Vitrotem/vitronotion/MVP/BOM/IMG/13-018229.jpg

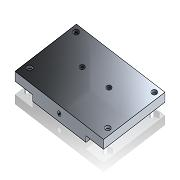
MVP/BOM/IMG/13-018229.jpg
