Vitrotem/vitronotion/MVP_02/BOM/IMG/20-019473.jpg

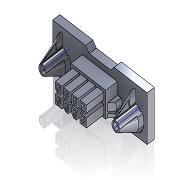
MVP_02/BOM/IMG/20-019473.jpg
