Vitrotem/vitronotion/README.md

# VitroNotion

This repo is for information display to embedded Notion pages...
