Vitrotem/vitronotion/MVP/BOM/index.html

DOCUMENT PREVIEW | ITEM NO. | PartNo | DESCRIPTION | Vendor | VendorNo | Manufacturer | MATERIAL | QTY. | MIN. QTY | Units | Order Status | Expected delivery | Stock | Price in EUR | note | LINK | EMAIL
 | 1 | 13-018308 | MVP-PRT: PELTIER 71W | CONRAD | QC-127-1.4-8.5AS |  |  | 1 |  | 1 | Ordered | 2021-12-20 00:00:00
 | 2 | 13-018423 | MVP-PRT: PCB STANDOFF, M3 x 6 | CONRAD | S45530X10 |  |  | 16 |  | 2 | Ordered | 2021-12-20 00:00:00
 | 3 | 13-018431 | MVP-PRT: CPU FAN 50mm | CONRAD | RDH6025S2 |  |  | 1 |  | 2 | Delivered |  | 2 | 9.91
 | 4 | 13-018440 | MVP-PRT: ARDUINO MEGA 2560 | CONRAD | A000067 |  |  | 1 |  | 2 | Delivered |  | 2 | 31.4
 | 5 | 13-018441 | MVP-PRT: PHOENIX CONTACTS | CONRAD | BU 3002761 |  |  | 1 | 20 | 20 | Delivered |  | 20 | 39.26
 | 6 | 13-018707 | MVP-PRT: JOY-IT PELTIER PSU | CONRAD | DPS5005 |  |  | 1 |  |  | Delivered
 | 7 | 13-018358 | MVP-PRT: PTFE TUBING 1/16" OD - 0.8 ID | PTFE TUBE SHOP | PTFE TUBE 0.8 x 1.6 |  | PTFE (general) | 1 | 1m | 5m | Ordered | 2021-12-22 00:00:00 |  | 86.14 |  | https://ptfetubeshop.com/sv/product/ptfe-slang-08mm-x-16mm-1-32-x-1-16/
 | 8 | 13-018362 | MVP-PRT: 2 PORT BOTTLE CAP | INACOM | 00938T-2F |  |  | 4 |  | 4 | Ordered | 2021-01-20 00:00:00
 | 9 | 13-018394 | MVP-PRT: LUER ADAPTER | INACOM | 009LA |  |  | 6 |  | 6 | Ordered | 2021-01-20 00:00:00
 | 10 | 13-018395 | MVP-PRT: LUER PLUG | INACOM | 009LP |  |  | 6 |  | 6 | Ordered | 2021-01-20 00:00:00
 | 11 | 13-018396 | MVP-PRT: 4 PORT WASTE CAP | INACOM | 00938T-4W |  |  | 1 |  | 1 | Ordered | 2021-01-20 00:00:00
 | 12 | 13-018237 | MVP-PRT: MDRIVE LINEAR ACTUATOR A | ERIKS | MLI1CRL14A4-EQ-LC3Z073AZ |  |  | 1 |  |  | Delivered |  | 1 |  |  | https://novantaims.com/all-products/mdrive-intelligent-motors/mdrive-linear-actuators/ | rick.dekker@eriks.nl
 | 13 | 13-018241 | MVP-PRT: ROUGH NUT | ERIKS |  |  | PMMA | 2 |  |  | Delivered |  | 1
 | 14 | 13-018243 | MVP-PRT: MDRIVE LINEAR ACTUATOR B | ERIKS | MDI31RL14A4-EQ |  |  | 1 |  |  | Delivered |  | 1 |  |  | https://novantaims.com/all-products/mdrive-intelligent-motors/mdrive-linear-actuators/ | rick.dekker@eriks.nl
 | 15 | 13-018351 | MVP-PRT: MDRIVE LINEAR ACTUATOR C | ERIKS | MLI1CRL14A4-EQ-LC3Z098AZ |  |  | 1 |  |  | Delivered |  | 1 |  |  | https://novantaims.com/all-products/mdrive-intelligent-motors/mdrive-linear-actuators/ | rick.dekker@eriks.nl
 | 16 | 13-018408 | MVP-PRT: MOTOR CABLE | ERIKS | PD12B-1434-FL3 |  |  | 1 |  |  | Delivered |  | 3 |  |  | https://novantaims.com/accesories/pd12b-1434-fl3-prototype-development-cable/ | rick.dekker@eriks.nl
 | 17 | 13-018409 | MVP-PRT: USB INTERFACE | ERIKS | MD-CC403-001 |  |  | 1 |  |  | Delivered |  | 1 |  |  | https://novantaims.com/accesories/md-cc403-001/ | rick.dekker@eriks.nl
 | 18 | 13-018399 | MVP-PRT: AWG20 CABLES - RED | FARNELL | 6714 RD005 |  |  | 1 |  |  | Ordered
 | 19 | 13-018439 | MVP-PRT: AWG20 CABLES - BLACK | FARNELL | 6714 BK005 |  |  | 1 |  |  | Ordered |  |  |  | Steven is ordering
 | 20 | 13-018443 | MVP-PRT: AC/DC POWER SUPPLY | FARNELL | VES300PS24 |  |  | 1 |  |  | Ordered
 | 21 | 13-018444 | MVP-PRT: RIBBON CABLE | FARNELL | PSG-JRBN40-MM |  |  | 2 |  |  | Ordered
 | 22 | 13-018210 | MVP-PRT: BIG SLIDER | RS COMPONENTS | 6192385 |  |  | 1
 | 23 | 13-018212 | MVP-PRT: SMALL RAIL | RS COMPONENTS | 6192521 |  |  | 1
 | 24 | 13-018213 | MVP-PRT: SMALL SLIDER | RS COMPONENTS | 6192559 |  |  | 1
 | 25 | 13-018276 | MVP-PRT: DEKSEL RAIL | RS COMPONENTS | 6192391 |  |  | 2
 | 26 | 13-018277 | MVP-PRT: DEKSEL SLIDER | RS COMPONENTS | 6192442 |  |  | 2
 | 27 | 13-018397 | MVP-PRT: BIG RAIL | RS COMPONENTS | 6192363 |  |  | 1
 | 28 | 13-018283 | MVP-PRT: LOW PRESSURE PUMP | HNP-MIKROSYSTEME | MZR-2521 |  |  | 1 |  |  | Delivered |  | 1 |  |  | https://www.hnp-mikrosysteme.de/en/products/detail/mzr-2521/ | Hugo Grunder: hg@suurmond.com
 | 29 | 13-018392 | MVP-PRT: INFLOW FILTER | HNP-MIKROSYSTEME | F-MI0 |  | AISI Type 316L stainless steel | 1 |  |  | Delivered |  | 1 |  |  | https://www.hnp-mikrosysteme.de/en/products/filters/filter-series-f-mi0-1/ | Hugo Grunder: hg@suurmond.com
 | 30 | 13-018421 | MVP-PRT: CERAMIC PUMP CONTROLLER | HNP-MIKROSYSTEME | S-KG-21 |  |  | 1 |  |  | Delivered |  | 1
 | 31 | 13-018357 | MVP-PRT: FLANGELESS FITTING PEEK 5/16-24, 1/8" OD | INACOM | XP-130 |  | Polyetheretherketone (PEEK) | 1 |  |  | Order placed | Not specified
 | 32 | 13-018368 | MVP-PRT: FITTING PEEK 1/4-28, 1/16" OD | INACOM | XP-235 |  | Polyetheretherketone (PEEK) | 16 |  |  | Order placed | Not specified |  |  | Gaat wel via metrohm.nl??? | https://www.coleparmer.de/
 | 33 | 13-018369 | MVP-PRT: ADAPTER 1/4-28 x 5/16-24 PEEK | INACOM | P-135 |  | Polyetheretherketone (PEEK) | 1 |  |  | Order placed | Not specified |  |  |  | https://www.idex-hs.com/store/adapter-1-4-28-x-5-16-24-peek.html
 | 34 | 13-018373 | MVP-PRT: PEEK MANIFOLD 5 Port,1/16" | INACOM | P-154 |  | Polyetheretherketone (PEEK) | 1 |  |  | Order placed | Not specified
 | 35 | 13-018393 | MVP-PRT: FITTING PEEK 1/4-28 - 1/8" OD | INACOM | XP-335 |  | Polyetheretherketone (PEEK) | 1 |  |  | Order placed | Not specified |  |  |  | https://www.idex-hs.com/store/flangeless-fitting-short-natural-peek-1-4-28-flat-bottom-for-1-8-od-natural-10-pack.html
 | 36 | 13-018412 | MVP-PRT: PEEK Y CONNECTOR | INACOM | P-514 |  | Polyetheretherketone (PEEK) | 1 |  |  | Order placed | Not specified |  |  |  | https://www.idex-hs.com/store/y-assembly-peek-1-4-28-060in.html
 | 37 | 13-018418 | MVP-PRT: FITTING PEEK 1/2-20, 1/4" OD | INACOM | U-665 |  | Polyetheretherketone (PEEK) | 2 |  |  | Order placed | Not specified
 | 38 | 13-018419 | MVP-PRT: FLANGELESS FITTING PEEK 1/2-20, 1/4" OD | INACOM | XU-655 |  | Polyetheretherketone (PEEK) | 2 |  |  | Order placed | Not specified
 | 39 | 13-018708 | MVP-PRT: DELRIN PLUG, 1/4-28 FLAT BOTTOM | INACOM | P-309 |  |  | 5
 | 40 | 13-018414 | MVP-PRT: MEMBRANE PUMP | KNF | NF5KPDCB-4 10-26.4V |  |  | 1 |  | 1 | Ordered | 2021-12-08 00:00:00 | 0 | 250 |  | https://knf.com/en/nl/solutions/pumps/series/diaphragm-liquid-pump-nf-5 | mark.hommersen@knf-verder.nl
 | 41 | 13-018420 | MVP-PRT: PTFE TUBING, 1/8" ID, 1/4" OD | PTFE TUBE SHOP | PTFE SLANG 3.2mm x 6.4mm |  | PTFE (general) | 1
 | 42 | 13-018290 | MVP-PRT: ACTUONIX MOTOR | RS COMPONENTS | PQ12-100-6-R |  |  | 2 |  |  | Ordered | 2021-12-20 00:00:00 |  |  | 1 actuonix actuator is delayed and expected delivery is on 21-2-2022 | https://www.actuonix.com/Actuonix-PQ12-R-micro-linear-servos-for-RC-p/pq12-r.htm
 | 43 | 13-018400 | MVP-PRT: BOOTLACE FERRULE | RS COMPONENTS | 228-0321 |  |  | 1 |  |  | Ordered | 2021-12-20 00:00:00
 | 44 | 13-018416 | MVP-PRT: RED BUTTON | RS COMPONENTS | 3SU1150-0AB20-1CA0 |  |  | 1 |  |  | Ordered | 2021-12-20 00:00:00
 | 45 | 13-018434 | MVP-PRT: MOLEX RECEPTICLE | RS COMPONENTS | 15-06-0080 |  |  | 1 |  |  | Ordered | 2021-12-20 00:00:00
 | 46 | 13-018442 | MVP-PRT: SOLID STATE RELAY | RS COMPONENTS | EL100D10-05 |  |  | 4 |  |  | Ordered | 2021-12-20 00:00:00
 | 47 | 13-018445 | MVP-PRT: OMRON 120mm FAN | RS COMPONENTS | R89F-DS1238L |  |  | 1 |  |  | Ordered | 2021-12-20 00:00:00
 | 48 | 13-018447 | MVP-PRT: M8 RUBBER FEET | RS COMPONENTS | 126-4964 |  |  | 4 |  |  | Ordered | 2021-12-20 00:00:00
 | 49 | 13-016706 | M2.5 X 6 SHCS | SAM | DIN 912 A4 M2.5 X 6 |  | AISI Type 316L stainless steel | 4 |  | 50 | Out for delivery | 2021-12-17 00:00:00 |  | 5.29
 | 50 | 13-016707 | M2.5 X 8 SHCS | SAM | DIN 912 A4 M2.5 X 8 |  | AISI Type 316L stainless steel | 1 |  | 50 | Out for delivery | 2021-12-17 00:00:00 |  | 5.29
 | 51 | 13-016708 | M2.5 X 10 SHCS | SAM | DIN 912 A4 M2.5 X 10 |  | AISI Type 316L stainless steel | 4 |  | 50 | Out for delivery | 2021-12-17 00:00:00 |  | 5.29
 | 52 | 13-016709 | M2.5 X 12 SHCS | SAM | DIN 912 A4 M2.5 X 12 |  | AISI Type 316L stainless steel | 12 |  | 50 | Out for delivery | 2021-12-17 00:00:00 |  | 5.29
 | 53 | 13-016711 | M2.5 X 18 SHCS | SAM | DIN 912 A4 M2.5 X 18 |  | AISI Type 316L stainless steel | 2 |  | 25 | Out for delivery | 2021-12-17 00:00:00 |  | 5.87
 | 54 | 13-016752 | M3 X 5 SHCS | SAM | DIN 912 A4 M3 X 5 |  | AISI Type 316L stainless steel | 6 |  | 50 | Out for delivery | 2021-12-17 00:00:00 |  | 4.7
 | 55 | 13-016753 | M3 X 6 SHCS | SAM | DIN 912 A4 M3 X 6 |  | AISI Type 316L stainless steel | 10 |  | 50 | Out for delivery | 2021-12-17 00:00:00 |  | 4.7
 | 56 | 13-016754 | M3 X 8 SHCS | SAM | DIN 912 A4 M3 X 8 |  | AISI Type 316L stainless steel | 6 |  | 50 | Out for delivery | 2021-12-17 00:00:00 |  | 4.7
 | 57 | 13-016755 | M3 X 10 SHCS | SAM | DIN 912 A4 M3 X 10 |  | AISI Type 316L stainless steel | 17 |  | 50 | Out for delivery | 2021-12-17 00:00:00 |  | 4.7
 | 58 | 13-016756 | M3 X 12 SHCS | SAM | DIN 912 A4 M3 X 12 |  | AISI Type 316L stainless steel | 10 |  | 50 | Out for delivery | 2021-12-17 00:00:00 |  | 4.7
 | 59 | 13-016757 | M3 X 16 SHCS | SAM | DIN 912 A4 M3 X 16 |  | AISI Type 316L stainless steel | 8 |  | 50 | Out for delivery | 2021-12-17 00:00:00 |  | 5.29
 | 60 | 13-016797 | M4 X 8 SHCS | SAM | DIN 912 A4 M4 X 8 |  | AISI Type 316L stainless steel | 16 |  | 50 | Out for delivery | 2021-12-17 00:00:00 |  | 6.97
 | 61 | 13-016798 | M4 X 10 SHCS | SAM | DIN 912 A4 M4 X 10 |  | AISI Type 316L stainless steel | 8 |  | 50 | Out for delivery | 2021-12-17 00:00:00 |  | 6.97
 | 62 | 13-016799 | M4 X 12 SHCS | SAM | DIN 912 A4 M4 X 12 |  | AISI Type 316L stainless steel | 6 |  | 50 | Out for delivery | 2021-12-17 00:00:00 |  | 6.97
 | 63 | 13-016800 | M4 X 16 SHCS | SAM | DIN 912 A4 M4 X 16 |  | AISI Type 316L stainless steel | 17 |  | 50 | Out for delivery | 2021-12-17 00:00:00 |  | 8.23
 | 64 | 13-016802 | M4 X 20 SHCS | SAM | DIN 912 A4 M4 X 20 |  | AISI Type 316L stainless steel | 4 |  | 50 | Out for delivery | 2021-12-17 00:00:00 |  | 8.23
 | 65 | 13-016803 | M4 X 25 SHCS | SAM | DIN 912 A4 M4 X 25 |  | AISI Type 316L stainless steel | 4 |  | 50 | Out for delivery | 2021-12-17 00:00:00 |  | 9.32
 | 66 | 13-016807 | M4 X 45 SHCS | SAM | DIN 912 A4 M4 X 45 |  | AISI Type 316L stainless steel | 4 |  | 25 | Out for delivery | 2021-12-17 00:00:00 |  | 8.23
 | 67 | 13-016809 | M4 X 60 SHCS | SAM | DIN 912 A4 M4 X 60 |  | AISI Type 316L stainless steel | 4 |  | 10 | Out for delivery | 2021-12-17 00:00:00 |  | 5.87
 | 68 | 13-016812 | M5 X 10 SHCS | SAM | DIN 912 A4 M5 X 10 |  | AISI Type 316L stainless steel | 15 |  | 25 | Out for delivery | 2021-12-17 00:00:00 |  | 7.55
 | 69 | 13-016813 | M5 X 12 SHCS | SAM | DIN 912 A4 M5 X 12 |  | AISI Type 316L stainless steel | 6
 | 70 | 13-016814 | M5 X 16 SHCS | SAM | DIN 912 A4 M5 X 16 |  | AISI Type 316L stainless steel | 8 |  | 25 | Out for delivery | 2021-12-17 00:00:00 |  | 7.55
 | 71 | 13-016899 | M2.5 HEX NUT | SAM | DIN 934 A4 M2.5 |  | AISI Type 316L stainless steel | 2 |  | 50 | Out for delivery | 2021-12-17 00:00:00 |  | 2.93
 | 72 | 13-016901 | M4 HEX NUT | SAM | DIN 934 A4 M4 |  | AISI Type 316L stainless steel | 4 |  | 50 | Out for delivery | 2021-12-17 00:00:00 |  | 2.93
 | 73 | 13-017540 | M4 FLAT WASHER | SAM | DIN 125 A4 M4 |  | AISI Type 316L stainless steel | 8 |  | 100 | Out for delivery | 2021-12-17 00:00:00 |  | 3.52
 | 74 | 13-017714 | 4 X 12 DP | SAM | DIN 7 A1 4m6 X 12 |  | AISI Type 316L stainless steel | 6 |  | 25 | Out for delivery | 2021-12-17 00:00:00 |  | 3.44
 | 75 | 13-018353 | MVP:PRT: FLOW VALVE | SMC NEDERLAND | LVM10R3-5E2U-3-Q |  |  | 5 |  | 5 | Ordered |  | 0 |  |  | https://www.smc.eu/nl-nl/products/lvm10-100-2-3-poort-magneetventiel-voor-chemicalien~134871~cfg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 | RenÃƒÂ© Bachofner: verkoop@smc.nl
 | 76 | 13-018354 | MVP:PRT: 500ML WATER FLASK | THERMOFISHER | 2019-500 |  |  | 2 | 48.0 |  |  |  |  |  |  | https://www.thermofisher.com/order/catalog/product/2019-0125#/2019-0125
 | 77 | 13-018355 | MVP:PRT: 250ML WATER FLASK | THERMOFISHER | 2019-250 |  |  | 1 | 48.0
 | 78 | 13-018356 | MVP:PRT: 2000ML WATER FLASK | THERMOFISHER | 2019-2000 |  |  | 1 | 24.0
 | 79 | 13-018361 | MVP:PRT: 1000ML WATER FLASK | THERMOFISHER | 2019-1000 |  |  | 1 | 24.0
 | 80 | 13-018219 | MVP-PRT: PRECISION MICRO 4 | VITROTEM | 13-018219 | PRECISION MICRO | 304 SS | 1
 | 81 | 13-018218 | MVP-PRT: CARTRIDGE | VITROTEM | 13-018218 | LASERBEEST | PMMA | 1
 | 82 | 13-018293 | MVP-PRT: TOP COVER | VITROTEM | 13-018293 | LASERBEEST | PMMA | 1 |  | 1 |  | 2021-12-17 00:00:00 | 0
 | 83 | 13-018294 | MVP-PRT: BACK COVER | VITROTEM | 13-018294 | LASERBEEST | PMMA | 1 |  | 1 |  | 2021-12-17 00:00:00 | 0
 | 84 | 13-018295 | MVP-PRT: SIDE COVER A | VITROTEM | 13-018295 | LASERBEEST | PMMA | 1 |  | 1 |  | 2021-12-17 00:00:00 | 0
 | 85 | 13-018426 | MVP-PRT: SIDE COVER B | VITROTEM | 13-018295 | LASERBEEST | PMMA | 1 |  | 1 |  | 2021-12-17 00:00:00 | 0
 | 86 | 13-018433 | MVP-PRT: FRONT COVER | VITROTEM | 13-018433 | LASERBEEST | PMMA | 1 |  | 1 |  | 2021-12-17 00:00:00 | 0
 | 87 | 13-018269 | MVP-PRT: HEATPIPE | VITROTEM | 13-018269 | QUICKCOOL | Copper | 3 |  |  | Delivered |  | 6
 | 88 | 13-018206 | MVP-PRT: BASE PLATE | VITROTEM | 13-018206 | SUPE | 6061 Alloy | 1 |  | 1 | Parts finished dec 27th |  | 0
 | 89 | 13-018207 | MVP-PRT: BACK PLATE | VITROTEM | 13-018207 | SUPE | 6061 Alloy | 1 |  | 1 | Parts finished dec 27th |  | 0
 | 90 | 13-018217 | MVP-PRT: LOOP HOLDER | VITROTEM | 13-018217 | SUPE | 6061 Alloy | 1 |  | 1 | Parts finished dec 27th |  | 0
 | 91 | 13-018220 | MVP-PRT: LOOP HOLDER INTERFACE | VITROTEM | 13-018220 | SUPE | 1060 Alloy | 1 |  | 1 | Parts finished dec 27th |  | 0
 | 92 | 13-018224 | MVP-PRT: BOTTOM PLATE | VITROTEM | 13-018224 | SUPE | 6061 Alloy | 1 |  | 1 | Parts finished dec 27th |  | 0
 | 93 | 13-018229 | MVP-PRT: FLOWCELL SLIDER | VITROTEM | 13-018229 | SUPE | 6061 Alloy | 1 |  | 1 | Parts finished dec 27th |  | 0
 | 94 | 13-018232 | MVP-PRT: CARTRIDGE PLATFORM | VITROTEM | 13-018232 | SUPE | 6061 Alloy | 1 |  | 1 | Parts finished dec 27th |  | 0
 | 95 | 13-018233 | MVP-PRT: GRID HOLDER | VITROTEM | 13-018233 | SUPE | PMMA | 1
 | 96 | 13-018234 | MVP-PRT: CARTRIDGE LANDING PAD | VITROTEM | 13-018234 | SUPE | 6061 Alloy | 1 |  | 1 | Parts finished dec 27th |  | 0
 | 97 | 13-018235 | MVP-PRT: SET BLOCK | VITROTEM | 13-018235 | SUPE | 6061 Alloy | 2 |  | 2 | Parts finished dec 27th |  | 0
 | 98 | 13-018236 | MVP-PRT: CARTRIDGE LANDING LID | VITROTEM | 13-018236 | SUPE | Polyetheretherketone (PEEK) | 1 |  | 1 | Parts finished dec 27th |  | 0
 | 99 | 13-018240 | MVP-PRT: DIFFERENTIAL SCREW | VITROTEM | 13-018240 | SUPE | AISI Type 316L stainless steel | 2 |  | 1 | Parts finished dec 27th |  | 0
 | 100 | 13-018242 | MVP-PRT: HORIZONTAL MOTOR PLATE | VITROTEM | 13-018242 | SUPE | 6061 Alloy | 1 |  | 1 | Parts finished dec 27th |  | 0
 | 101 | 13-018265 | MVP-PRT: HEATPIPE CLAMP A | VITROTEM | 13-018265 | SUPE | Copper | 1 |  | 1 | Parts finished dec 27th |  | 0
 | 102 | 13-018266 | MVP-PRT: HEATPIPE CLAMP B | VITROTEM | 13-018266 | SUPE | Copper | 1 |  | 1 | Parts finished dec 27th |  | 0
 | 103 | 13-018267 | MVP-PRT: LONG AIR | VITROTEM | 13-018267 | SUPE | 6061 Alloy | 1 |  | 1 | Parts finished dec 27th |  | 0
 | 104 | 13-018268 | MVP-PRT: HEATSINK | VITROTEM | 13-018268 | SUPE | Copper | 1 |  | 1 | Parts finished dec 27th |  | 0
 | 105 | 13-018270 | MVP-PRT: SHORT AIR | VITROTEM | 13-018270 | SUPE | 6061 Alloy | 1 |  | 1 | Parts finished dec 27th |  | 0
 | 106 | 13-018271 | MVP-PRT: FLOWCELL COVER | VITROTEM | 13-018271 | SUPE | Polyetheretherketone (PEEK) | 1 |  | 1 | Parts finished dec 27th |  | 0
 | 107 | 13-018272 | MVP-PRT: DIVIDER PLATE A | VITROTEM | 13-018272 | SUPE | 6061 Alloy | 1 |  | 1 | Parts finished dec 27th |  | 0
 | 108 | 13-018273 | MVP-PRT: DIVIDER PLATE B | VITROTEM | 13-018273 | SUPE | 6061 Alloy | 1 |  | 1 | Parts finished dec 27th |  | 0
 | 109 | 13-018274 | MVP-PRT: HEATSINK CLAMP | VITROTEM | 13-018274 | SUPE | 6061 Alloy | 1 |  | 1 | Parts finished dec 27th |  | 0
 | 110 | 13-018275 | MVP-PRT: FLOWCELL COVER BRACKET | VITROTEM | 13-018275 | SUPE | 6061 Alloy | 1 |  | 1 | Parts finished dec 27th |  | 0
 | 111 | 13-018278 | MVP-PRT: LEFT BRACE CONNECTOR | VITROTEM | 13-018278 | SUPE | 6061 Alloy | 1 |  | 1 | Parts finished dec 27th |  | 0
 | 112 | 13-018279 | MVP-PRT: RIGHT BRACE CONNECTOR | VITROTEM | 13-018279 | SUPE | 6061 Alloy | 1 |  | 1 | Parts finished dec 27th |  | 0
 | 113 | 13-018285 | MVP-PRT: VALVE PLATE | VITROTEM | 13-018285 | SUPE | 6061 Alloy | 1 |  | 1 | Parts finished dec 27th |  | 0
 | 114 | 13-018286 | MVP-PRT: ACTUATOR BRACKET | VITROTEM | 13-018286 | SUPE | 6061 Alloy | 1 |  | 1 | Parts finished dec 27th |  | 0
 | 115 | 13-018287 | MVP-PRT: CARTRIDGE BRACKET | VITROTEM | 13-018287 | SUPE | 6061 Alloy | 1 |  | 1 | Parts finished dec 27th |  | 0
 | 116 | 13-018288 | MVP-PRT: BOTTOM TRAY B | VITROTEM | 13-018288 | SUPE | Polyetheretherketone (PEEK) | 1 |  | 1 | Parts finished dec 27th |  | 0
 | 117 | 13-018289 | MVP-PRT: BOTTOM TRAY A | VITROTEM | 13-018289 | SUPE | Polyetheretherketone (PEEK) | 1 |  | 1 | Parts finished dec 27th |  | 0
 | 118 | 13-018292 | MVP-PRT: LOOP HOLDER CLIP | VITROTEM | 13-018292 | SUPE | Polyetheretherketone (PEEK) | 1 |  | 1 | Parts finished dec 27th |  | 0
 | 119 | 13-018301 | MVP-PRT: HOUSING CONNECTION A | VITROTEM | 13-018301 | SUPE | 6061 Alloy | 4 |  | 4 | Parts finished dec 27th |  | 0
 | 120 | 13-018309 | MVP-PRT: COPPER JACKET | VITROTEM | 13-018309 | SUPE | Copper | 1 |  | 1 | Parts finished dec 27th |  | 0
 | 121 | 13-018313 | MVP-PRT: MOTOR / RAIL BRACKET A | VITROTEM | 13-018313 | SUPE | 6061 Alloy | 1 |  | 1 | Parts finished dec 27th |  | 0
 | 122 | 13-018314 | MVP-PRT: MOTOR / RAIL BRACKET b | VITROTEM | 13-018314 | SUPE | 6061 Alloy | 1 |  | 1 | Parts finished dec 27th |  | 0
 | 123 | 13-018410 | MVP-PRT: FLOWCELL | VITROTEM | 13-018307 | SUPE | Polyetheretherketone (PEEK) | 1 |  | 1 | Parts finished dec 27th |  | 0
 | 124 | 13-018425 | MVP-PRT: HOUSING CONNECTION B | VITROTEM | 13-018301 | SUPE | 6061 Alloy | 4 |  | 4 | Parts finished dec 27th |  | 0
 | 125 | 13-018446 | MVP-PRT: PATCH PANEL FOR PSU | VITROTEM | 13-018446 | SUPE | 6061 Alloy | 1 |  | 1 | Parts finished dec 27th |  | 0
 | 126 | 13-018730 | MVP-PRT: SS SPRING | RS COMPONENTS | 821-526 |  |  | 2
 | 127 | 13-018370 | MVP-PRT: PTFE TUBING 1/8" OD - 1.6 ID | PTFE TUBE SHOP | PTFE SLANG 1.6mm x 3.2mm |  | PTFE (general) | 1
 | 128 | 13-018716 | MVP-PRT: PELTIER PSU SUPPORT | VITROTEM | 13-018716 |  | PMMA | 1
 | 129 | 13-018717 | MVP-PRT: PELTIER HOLDER BRACKET | VITROTEM | 13-018717 |  | PMMA | 1
 | 130 | 13-018718 | MVP-PRT: TC PLATE | VITROTEM | 13-018718 |  | PMMA | 1
 | 131 | 13-018720 | MVP-PRT: TC HOLDER BRACKET | VITROTEM | 13-018720 |  | PMMA | 1
 | 132 | 13-018737 | MVP: PCB | VITROTEM | 13-018737 |  |  | 1
 | 133 | 13-018738 | MVP: PCB BRACKET | VITROTEM | 13-018738 |  | Material <not specified> | 1
 | 134 | 13-018739 | MVP: ARUINO BRACKET | VITROTEM | 13-018739 |  | Material <not specified> | 1
