Vitrotem/vitronotion/MVP_02/SHOPPING_LISTS/CONRAD.xlsx

DOCUMENT PREVIEW | ITEM NO. | PartNo | DESCRIPTION | Vendor | VendorNo | Manufacturer | MATERIAL | QTY.
 | 1 | 20-019470 | PELTIER 71W | CONRAD | QC-127-1.4-8.5AS |  |  | 1
 | 2 | 20-019458 | PCB STANDOFF, M3 x 6 | CONRAD | S45530X10 |  |  | 8
 | 3 | 20-019475 | ARDUINO MEGA 2560 | CONRAD | A000067 |  |  | 1
 | 4 | 20-019476 | PHOENIX CONTACTS | CONRAD | BU 3002761 |  |  | 1
 | 5 | 20-019485 | JOY-IT PELTIER PSU | CONRAD | DPS5005 |  |  | 1
