Vitrotem/vitronotion/MVP_02/SHOPPING_LISTS/ERIKS.xlsx

DOCUMENT PREVIEW | ITEM NO. | PartNo | DESCRIPTION | Vendor | VendorNo | Manufacturer | MATERIAL | QTY.
 | 11 | 20-019380 | MDRIVE LINEAR ACTUATOR C | ERIKS | MLI1CRL14A4-EQ-LC3Z098AZ |  |  | 1
 | 12 | 20-019382 | ROUGH NUT | ERIKS | 20-019382 |  | PMMA | 2
 | 13 | 20-019448 | MOTOR CABLE | ERIKS | PD12B-1434-FL3 |  |  | 3
 | 14 | 20-019449 | USB INTERFACE | ERIKS | MD-CC403-001 |  |  | 1
 | 114 | 20-019424 | MDRIVE LINEAR ACTUATOR A | ERIKS | MLI1CRL14A4-EQ-LC3Z073AZ |  |  | 1
