Vitrotem/vitronotion/MVP_02/SHOPPING_LISTS/FARNELL.xlsx

DOCUMENT PREVIEW | ITEM NO. | PartNo | DESCRIPTION | Vendor | VendorNo | Manufacturer | MATERIAL | QTY.
 | 15 | 20-019442 | AWG20 CABLES - RED | FARNELL | 6714 RD005 |  |  | 1
 | 16 | 20-019474 | AWG20 CABLES - BLACK | FARNELL | 6714 BK005 |  |  | 1
 | 18 | 20-019479 | RIBBON CABLE | FARNELL | PSG-JRBN40-MM |  |  | 2
 | 39 | 20-019477 | SOLID STATE RELAY | FARNELL | 7229136 | OPTO 22 |  | 4
 | 132 | 20-019512 | DC POWER CONNECTOR | FARNELL | 1871166 | SWITCHCRAFT |  | 1
 | 133 | 20-019513 | AC/DC POWER SUPPLY - 120W, 5A | FARNELL | 2815847 | MEAN WELL |  | 1
