Vitrotem/vitronotion/MVP_02/SHOPPING_LISTS/HNP-MIKROSYSTEME.xlsx

DOCUMENT PREVIEW | ITEM NO. | PartNo | DESCRIPTION | Vendor | VendorNo | Manufacturer | MATERIAL | QTY.
 | 25 | 20-019398 | LOW PRESSURE PUMP | HNP-MIKROSYSTEME | MZR-2521 |  |  | 1
 | 26 | 20-019436 | INFLOW FILTER | HNP-MIKROSYSTEME | F-MI0 |  | AISI Type 316L stainless steel | 1
 | 27 | 20-019457 | CERAMIC PUMP CONTROLLER | HNP-MIKROSYSTEME | S-KG-21 |  |  | 1
