Vitrotem/vitronotion/MVP_02/SHOPPING_LISTS/KNF.xlsx

DOCUMENT PREVIEW | ITEM NO. | PartNo | DESCRIPTION | Vendor | VendorNo | Manufacturer | MATERIAL | QTY.
 | 35 | 20-019452 | MEMBRANE PUMP | KNF | NF5KPDCB-4 10-26.4V |  |  | 1
 | 124 | 20-019522 | OUTFLOW FILTER | KNF | FS60 |  |  | 1
