Vitrotem/vitronotion/MVP_02/SHOPPING_LISTS/PTFE TUBE SHOP.xlsx

DOCUMENT PREVIEW | ITEM NO. | PartNo | DESCRIPTION | Vendor | VendorNo | Manufacturer | MATERIAL | QTY.
 | 6 | 20-019429 | PTFE TUBING 1/16" OD - 0.8 ID | PTFE TUBE SHOP | PTFE TUBE 0.8 x 1.6 |  | PTFE (general) | 1
 | 122 | 20-019434 | PTFE TUBING 1/8" OD - 1.6 ID | PTFE TUBE SHOP | PTFE SLANG 1.6mm x 3.2mm |  | PTFE (general) | 1
