Vitrotem/vitronotion/MVP_02/SHOPPING_LISTS/RS COMPONENTS.xlsx

DOCUMENT PREVIEW | ITEM NO. | PartNo | DESCRIPTION | Vendor | VendorNo | Manufacturer | MATERIAL | QTY.
 | 17 | 20-019478 | AC/DC POWER SUPPLY | RS COMPONENTS | 200-6361 |  |  | 1
 | 19 | 20-019365 | BIG SLIDER | RS COMPONENTS | 6192385 |  |  | 1
 | 20 | 20-019367 | SMALL RAIL | RS COMPONENTS | 6192521 |  |  | 1
 | 21 | 20-019368 | SMALL SLIDER | RS COMPONENTS | 6192559 |  |  | 1
 | 22 | 20-019394 | DEKSEL RAIL | RS COMPONENTS | 6192391 |  |  | 2
 | 23 | 20-019395 | DEKSEL SLIDER | RS COMPONENTS | 6192442 |  |  | 2
 | 24 | 20-019441 | BIG RAIL | RS COMPONENTS | 6192363 |  |  | 1
 | 36 | 20-019404 | ACTUONIX MOTOR | RS COMPONENTS | 180-8409 |  |  | 2
 | 37 | 20-019443 | BOOTLACE FERRULE | RS COMPONENTS | 228-0321 |  |  | 1
 | 38 | 20-019511 | EMERGENCY STOP | RS COMPONENTS | 425-8449 | SCHNEIDER |  | 1
 | 40 | 20-019480 | OMRON 120mm FAN | RS COMPONENTS | 194-0653 | OMRON |  | 1
 | 41 | 20-019483 | M8 RUBBER FEET | RS COMPONENTS | 126-4964 |  |  | 4
 | 115 | 20-019491 | SS SPRING | RS COMPONENTS | 821-526 |  |  | 2
 | 135 | 20-019525 | TYPE K THERMOCOUPLE | RS COMPONENTS | 444-1275 |  |  | 1
