Vitrotem/vitronotion/MVP_02/SHOPPING_LISTS/SMC NEDERLAND.xlsx

DOCUMENT PREVIEW | ITEM NO. | PartNo | DESCRIPTION | Vendor | VendorNo | Manufacturer | MATERIAL | QTY.
 | 66 | 20-019425 | MVP:PRT: FLOW VALVE | SMC NEDERLAND | LVM10R3-5E2U-3-Q |  |  | 5
