Vitrotem/vitronotion/MVP_02/SHOPPING_LISTS/THERMOFISHER.xlsx

DOCUMENT PREVIEW | ITEM NO. | PartNo | DESCRIPTION | Vendor | VendorNo | Manufacturer | MATERIAL | QTY.
 | 67 | 20-019427 | MVP:PRT: 500ML WATER FLASK | THERMOFISHER | 2019-500 |  |  | 2
 | 68 | 20-019409 | MVP:PRT: 250ML WATER FLASK | THERMOFISHER | 2019-250 |  |  | 1
 | 69 | 20-019430 | MVP:PRT: 2000ML WATER FLASK | THERMOFISHER | 2019-2000 |  |  | 1
 | 70 | 20-019426 | MVP:PRT: 1000ML WATER FLASK | THERMOFISHER | 2019-1000 |  |  | 1
