Vitrotem/vitronotion/MVP_02/SHOPPING_LISTS/VITROTEM.xlsx

DOCUMENT PREVIEW | ITEM NO. | PartNo | DESCRIPTION | Vendor | VendorNo | Manufacturer | MATERIAL | QTY.
 | 71 | 20-019371 | PRECISION MICRO 4 | VITROTEM | 20-019371 | PRECISION MICRO | 304 SS | 1
 | 72 | 20-019370 | CARTRIDGE | VITROTEM | 20-019370 | LASERBEEST | PMMA | 1
 | 73 | 20-019406 | TOP COVER | VITROTEM | 20-019406 | LASERBEEST | PMMA | 1
 | 74 | 20-019407 | BACK COVER | VITROTEM | 20-019407 | LASERBEEST | PMMA | 1
 | 75 | 20-019408 | SIDE COVER A | VITROTEM | 20-019408 | LASERBEEST | PMMA | 1
 | 76 | 20-019462 | SIDE COVER B | VITROTEM | 20-019462 | LASERBEEST | PMMA | 1
 | 77 | 20-019468 | FRONT COVER | VITROTEM | 20-019468 | LASERBEEST | PMMA | 1
 | 78 | 20-019388 | HEATPIPE | VITROTEM | 20-019388 | QUICKCOOL | Copper | 3
 | 79 | 20-019362 | BASE PLATE | VITROTEM | 20-019362 | SUPE | 6061 Alloy | 1
 | 80 | 20-019363 | BACK PLATE | VITROTEM | 20-019363 | SUPE | 6061 Alloy | 1
 | 81 | 20-019369 | LOOP HOLDER | VITROTEM | 20-019369 | SUPE | 6061 Alloy | 1
 | 82 | 20-019373 | BOTTOM PLATE | VITROTEM | 20-019373 | SUPE | 6061 Alloy | 1
 | 83 | 20-019374 | FLOWCELL SLIDER | VITROTEM | 20-019374 | SUPE | 6061 Alloy | 1
 | 84 | 20-019375 | CARTRIDGE PLATFORM | VITROTEM | 20-019375 | SUPE | 6061 Alloy | 1
 | 85 | 20-019376 | GRID HOLDER | VITROTEM | 20-019376 | SUPE | PMMA | 1
 | 86 | 20-019377 | CARTRIDGE LANDING PAD | VITROTEM | 20-019377 | SUPE | 6061 Alloy | 1
 | 87 | 20-019378 | SET BLOCK | VITROTEM | 20-019378 | SUPE | 6061 Alloy | 2
 | 88 | 20-019379 | CARTRIDGE LANDING LID | VITROTEM | 20-019379 | SUPE | ABS Black | 1
 | 89 | 20-019383 | HORIZONTAL MOTOR PLATE | VITROTEM | 20-019383 | SUPE | 6061 Alloy | 1
 | 90 | 20-019385 | HEATPIPE CLAMP A | VITROTEM | 20-019385 | SUPE | Copper | 1
 | 91 | 20-019386 | HEATPIPE CLAMP B | VITROTEM | 20-019386 | SUPE | Copper | 1
 | 92 | 20-019387 | HEATSINK | VITROTEM | 20-019387 | SUPE | Copper | 1
 | 93 | 20-019389 | FLOWCELL COVER | VITROTEM | 20-019389 | SUPE | ABS Clear | 1
 | 94 | 20-019390 | DIVIDER PLATE A | VITROTEM | 20-019390 | SUPE | 6061 Alloy | 1
 | 95 | 20-019391 | DIVIDER PLATE B | VITROTEM | 20-019391 | SUPE | 6061 Alloy | 1
 | 96 | 20-019392 | HEATSINK CLAMP | VITROTEM | 20-019392 | SUPE | 6061 Alloy | 1
 | 97 | 20-019393 | FLOWCELL COVER BRACKET | VITROTEM | 20-019393 | SUPE | 6061 Alloy | 1
 | 98 | 20-019396 | LEFT BRACE CONNECTOR | VITROTEM | 20-019396 | SUPE | 6061 Alloy | 1
 | 99 | 20-019397 | RIGHT BRACE CONNECTOR | VITROTEM | 20-019397 | SUPE | 6061 Alloy | 1
 | 100 | 20-019399 | VALVE PLATE | VITROTEM | 20-019399 | SUPE | 6061 Alloy | 1
 | 101 | 20-019400 | ACTUATOR BRACKET | VITROTEM | 20-019400 | SUPE | 6061 Alloy | 1
 | 102 | 20-019401 | CARTRIDGE BRACKET | VITROTEM | 20-019401 | SUPE | 6061 Alloy | 1
 | 103 | 20-019402 | BOTTOM TRAY B | VITROTEM | 20-019402 | SUPE | ABS Black | 1
 | 104 | 20-019403 | BOTTOM TRAY A | VITROTEM | 20-019403 | SUPE | ABS Black | 1
 | 105 | 20-019405 | LOOP HOLDER CLIP | VITROTEM | 20-019405 | SUPE | ABS Black | 1
 | 106 | 20-019410 | HOUSING CONNECTION A | VITROTEM | 20-019410 | SUPE | 6061 Alloy | 4
 | 107 | 20-019471 | COPPER JACKET | VITROTEM | 20-019471 | SUPE | Copper | 1
 | 108 | 20-019421 | MOTOR / RAIL BRACKET A | VITROTEM | 20-019421 | SUPE | 6061 Alloy | 1
 | 109 | 20-019422 | MOTOR / RAIL BRACKET b | VITROTEM | 20-019422 | SUPE | 6061 Alloy | 1
 | 110 | 20-019469 | FLOWCELL | VITROTEM | 20-019469 | SUPE | PEEK Natural | 1
 | 111 | 20-019460 | HOUSING CONNECTION B | VITROTEM | 20-019460 | SUPE | 6061 Alloy | 4
 | 112 | 20-019482 | PATCH PANEL FOR PSU | VITROTEM | 20-019482 | SUPE | 6061 Alloy | 1
 | 113 | 20-019497 | WATER TRAY | VITROTEM | 20-019497 |  | PLA | 1
 | 116 | 20-019529 | COVER D | VITROTEM | 20-019529 | LASERBEEST | PMMA | 1
 | 117 | 20-019500 | COVER A | VITROTEM | 20-019500 | LASERBEEST | PMMA | 1
 | 118 | 20-019501 | COVER B | VITROTEM | 20-019501 | LASERBEEST | PMMA | 2
 | 119 | 20-019502 | COVER C | VITROTEM | 20-019502 | LASERBEEST | PMMA | 1
 | 120 | 20-019506 | COVER CORNER BRACKETS | VITROTEM | 20-019506 |  | PLA | 4
 | 123 | 20-019503 | MEMBRANE PUMP BRACKET | VITROTEM | 20-019503 |  | PLA | 1
 | 125 | 20-019487 | PELTIER PSU SUPPORT | VITROTEM | 20-019487 |  | PLA | 1
 | 126 | 20-019488 | PELTIER HOLDER BRACKET | VITROTEM | 20-019488 |  | PLA | 1
 | 127 | 20-019490 | TC HOLDER BRACKET | VITROTEM | 20-019490 |  | PLA | 1
 | 128 | 20-019492 | MVP: PCB | VITROTEM | 20-019492 |  |  | 1
 | 129 | 20-019494 | MVP: ARUINO BRACKET | VITROTEM | 20-019494 |  | PLA | 1
 | 130 | 20-019493 | MVP: PCB BRACKET | VITROTEM | 20-019493 |  | PLA | 1
 | 131 | 20-019496 | PUMP BRACKET B | VITROTEM | 20-019496 |  | PLA | 1
 | 134 | 20-019508 | MOTOR STOP | VITROTEM | 20-019508 |  | PLA | 1
 | 136 | 20-019526 | LOOP HOLDER INTERFACE | VITROTEM | 20-019372 | SUPE | 6061 Alloy | 1
 | 137 | 20-019528 | COVER CORNER BRACKETS B | VITROTEM | 20-019528 |  | PLA | 2
 | 138 | 20-019633 | TC / OUTFLOW MOTOR PLATE | VITROTEM | 20-019633 |  | Material <not specified> | 1
