Vitrotem/vitronotion/MVP_02/SHOPPING_LISTS/TAMESON.xlsx

DOCUMENT PREVIEW | ITEM NO. | PartNo | DESCRIPTION | Vendor | VendorNo | Manufacturer | MATERIAL | QTY.
 | 131 | 20-019507 | 1/2-28 X 10 NIPPLE | TAMESON | FL2S-MH-BN-012R-10 | TAMESON |  | 1
