Vitrotem/vitronotion/MVP/SHOPPING_LISTS/DARWIN.xlsx

DOCUMENT PREVIEW | ITEM NO. | PartNo | DESCRIPTION | Vendor | VendorNo | Manufacturer | MATERIAL | QTY.
 | 7 | 13-018358 | MVP-PRT: PTFE TUBING 1/16" OD - 0.8 ID | DARWIN | BL-PTFE-1603-20 |  | PTFE (general) | 1
