Vitrotem/vitronotion/MVP/SHOPPING_LISTS/ROMYNOX.xlsx

DOCUMENT PREVIEW | ITEM NO. | PartNo | DESCRIPTION | Vendor | VendorNo | Manufacturer | MATERIAL | QTY.
 | 41 | 13-018420 | MVP-PRT: PTFE TUBING, 1/8" ID, 1/4" OD | ROMYNOX | CG-125X250 |  | PTFE (general) | 1
