Vitrotem/vitronotion/MVP_02/SHOPPING_LISTS/QUICKCOOL/QUICKCOOL.xlsx

DOCUMENT PREVIEW | ITEM NO. | PartNo | DESCRIPTION | Vendor | VendorNo | Manufacturer | MATERIAL | QTY.
 | 78 | 20-019388 | HEATPIPE | VITROTEM | 20-019388 | QUICKCOOL | Copper | 3
