Vitrotem/vitronotion/MVP_02/SHOPPING_LISTS/SCHNEIDER/SCHNEIDER.xlsx

DOCUMENT PREVIEW | ITEM NO. | PartNo | DESCRIPTION | Vendor | VendorNo | Manufacturer | MATERIAL | QTY.
 | 42 | 20-019511 | EMERGENCY STOP | RS COMPONENTS | 330-9388 | SCHNEIDER |  | 1
