Vitrotem/vitronotion/MVP/SHOPPING_LISTS/LASERBEEST/LASERBEEST.xlsx

DOCUMENT PREVIEW | ITEM NO. | PartNo | DESCRIPTION | Vendor | VendorNo | Manufacturer | MATERIAL | QTY.
 | 80 | 13-018218 | MVP-PRT: CARTRIDGE | VITROTEM | 13-018218 | LASERBEEST | PMMA | 1
 | 81 | 13-018293 | MVP-PRT: TOP COVER | VITROTEM | 13-018293 | LASERBEEST | PMMA | 1
 | 82 | 13-018294 | MVP-PRT: BACK COVER | VITROTEM | 13-018294 | LASERBEEST | PMMA | 1
 | 83 | 13-018295 | MVP-PRT: SIDE COVER A | VITROTEM | 13-018295 | LASERBEEST | PMMA | 1
 | 84 | 13-018426 | MVP-PRT: SIDE COVER B | VITROTEM | 13-018295 | LASERBEEST | PMMA | 1
 | 85 | 13-018433 | MVP-PRT: FRONT COVER | VITROTEM | 13-018433 | LASERBEEST | PMMA | 1
 | 125 | 13-018746 | MVP-PRT: COVER A | VITROTEM | 13-018746 | LASERBEEST | PLA | 2
 | 126 | 13-018747 | MVP-PRT: COVER B | VITROTEM | 13-018747 | LASERBEEST | Material <not specified> | 2
 | 127 | 13-018748 | MVP-PRT: COVER C | VITROTEM | 13-018748 | LASERBEEST | Material <not specified> | 1
