Vitrotem/vitronotion/MVP/SHOPPING_LISTS/PRECISION MICRO/PRECISION MICRO.xlsx

DOCUMENT PREVIEW | ITEM NO. | PartNo | DESCRIPTION | Vendor | VendorNo | Manufacturer | MATERIAL | QTY.
 | 79 | 13-018219 | MVP-PRT: PRECISION MICRO 4 | VITROTEM | 13-018219 | PRECISION MICRO | 304 SS | 1
