Vitrotem/vitronotion/MVP/SHOPPING_LISTS/QUICKCOOL/QUICKCOOL.xlsx

DOCUMENT PREVIEW | ITEM NO. | PartNo | DESCRIPTION | Vendor | VendorNo | Manufacturer | MATERIAL | QTY.
 | 86 | 13-018269 | MVP-PRT: HEATPIPE | VITROTEM | 13-018269 | QUICKCOOL | Copper | 3
