Vitrotem/vitronotion/MVP/SHOPPING_LISTS/SUPE/SUPE.xlsx

DOCUMENT PREVIEW | ITEM NO. | PartNo | DESCRIPTION | Vendor | VendorNo | Manufacturer | MATERIAL | QTY.
 | 87 | 13-018206 | MVP-PRT: BASE PLATE | VITROTEM | 13-018206 | SUPE | 6061 Alloy | 1
 | 88 | 13-018207 | MVP-PRT: BACK PLATE | VITROTEM | 13-018207 | SUPE | 6061 Alloy | 1
 | 89 | 13-018217 | MVP-PRT: LOOP HOLDER | VITROTEM | 13-018217 | SUPE | 6061 Alloy | 1
 | 90 | 13-018220 | MVP-PRT: LOOP HOLDER INTERFACE | VITROTEM | 13-018220 | SUPE | 1060 Alloy | 1
 | 91 | 13-018224 | MVP-PRT: BOTTOM PLATE | VITROTEM | 13-018224 | SUPE | 6061 Alloy | 1
 | 92 | 13-018229 | MVP-PRT: FLOWCELL SLIDER | VITROTEM | 13-018229 | SUPE | 6061 Alloy | 1
 | 93 | 13-018232 | MVP-PRT: CARTRIDGE PLATFORM | VITROTEM | 13-018232 | SUPE | 6061 Alloy | 1
 | 94 | 13-018233 | MVP-PRT: GRID HOLDER | VITROTEM | 13-018233 | SUPE | PMMA | 1
 | 95 | 13-018234 | MVP-PRT: CARTRIDGE LANDING PAD | VITROTEM | 13-018234 | SUPE | 6061 Alloy | 1
 | 96 | 13-018235 | MVP-PRT: SET BLOCK | VITROTEM | 13-018235 | SUPE | 6061 Alloy | 2
 | 97 | 13-018236 | MVP-PRT: CARTRIDGE LANDING LID | VITROTEM | 13-018236 | SUPE | Polyetheretherketone (PEEK) | 1
 | 98 | 13-018240 | MVP-PRT: DIFFERENTIAL SCREW | VITROTEM | 13-018240 | SUPE | AISI Type 316L stainless steel | 2
 | 99 | 13-018242 | MVP-PRT: HORIZONTAL MOTOR PLATE | VITROTEM | 13-018242 | SUPE | 6061 Alloy | 1
 | 100 | 13-018265 | MVP-PRT: HEATPIPE CLAMP A | VITROTEM | 13-018265 | SUPE | Copper | 1
 | 101 | 13-018266 | MVP-PRT: HEATPIPE CLAMP B | VITROTEM | 13-018266 | SUPE | Copper | 1
 | 102 | 13-018268 | MVP-PRT: HEATSINK | VITROTEM | 13-018268 | SUPE | Copper | 1
 | 103 | 13-018271 | MVP-PRT: FLOWCELL COVER | VITROTEM | 13-018271 | SUPE | Polyetheretherketone (PEEK) | 1
 | 104 | 13-018272 | MVP-PRT: DIVIDER PLATE A | VITROTEM | 13-018272 | SUPE | 6061 Alloy | 1
 | 105 | 13-018273 | MVP-PRT: DIVIDER PLATE B | VITROTEM | 13-018273 | SUPE | 6061 Alloy | 1
 | 106 | 13-018274 | MVP-PRT: HEATSINK CLAMP | VITROTEM | 13-018274 | SUPE | 6061 Alloy | 1
 | 107 | 13-018275 | MVP-PRT: FLOWCELL COVER BRACKET | VITROTEM | 13-018275 | SUPE | 6061 Alloy | 1
 | 108 | 13-018278 | MVP-PRT: LEFT BRACE CONNECTOR | VITROTEM | 13-018278 | SUPE | 6061 Alloy | 1
 | 109 | 13-018279 | MVP-PRT: RIGHT BRACE CONNECTOR | VITROTEM | 13-018279 | SUPE | 6061 Alloy | 1
 | 110 | 13-018285 | MVP-PRT: VALVE PLATE | VITROTEM | 13-018285 | SUPE | 6061 Alloy | 1
 | 111 | 13-018286 | MVP-PRT: ACTUATOR BRACKET | VITROTEM | 13-018286 | SUPE | 6061 Alloy | 1
 | 112 | 13-018287 | MVP-PRT: CARTRIDGE BRACKET | VITROTEM | 13-018287 | SUPE | 6061 Alloy | 1
 | 113 | 13-018288 | MVP-PRT: BOTTOM TRAY B | VITROTEM | 13-018288 | SUPE | Polyetheretherketone (PEEK) | 1
 | 114 | 13-018289 | MVP-PRT: BOTTOM TRAY A | VITROTEM | 13-018289 | SUPE | Polyetheretherketone (PEEK) | 1
 | 115 | 13-018292 | MVP-PRT: LOOP HOLDER CLIP | VITROTEM | 13-018292 | SUPE | Polyetheretherketone (PEEK) | 1
 | 116 | 13-018301 | MVP-PRT: HOUSING CONNECTION A | VITROTEM | 13-018301 | SUPE | 6061 Alloy | 4
 | 117 | 13-018309 | MVP-PRT: COPPER JACKET | VITROTEM | 13-018309 | SUPE | Copper | 1
 | 118 | 13-018313 | MVP-PRT: MOTOR / RAIL BRACKET A | VITROTEM | 13-018313 | SUPE | 6061 Alloy | 1
 | 119 | 13-018314 | MVP-PRT: MOTOR / RAIL BRACKET b | VITROTEM | 13-018314 | SUPE | 6061 Alloy | 1
 | 120 | 13-018410 | MVP-PRT: FLOWCELL | VITROTEM | 13-018307 | SUPE | Polyetheretherketone (PEEK) | 1
 | 121 | 13-018425 | MVP-PRT: HOUSING CONNECTION B | VITROTEM | 13-018301 | SUPE | 6061 Alloy | 4
 | 122 | 13-018446 | MVP-PRT: PATCH PANEL FOR PSU | VITROTEM | 13-018446 | SUPE | 6061 Alloy | 1
