Vitrotem/vitronotion/MVP_02/SHOPPING_LISTS/INACOM.xlsx

DOCUMENT PREVIEW | ITEM NO. | PartNo | DESCRIPTION | Vendor | VendorNo | Manufacturer | MATERIAL | QTY.
 | 7 | 20-019431 | 2 PORT BOTTLE CAP | INACOM | 00938T-2F |  |  | 4
 | 8 | 20-019438 | LUER ADAPTER | INACOM | 009LA |  |  | 6
 | 9 | 20-019439 | LUER PLUG | INACOM | 009LP |  |  | 6
 | 10 | 20-019440 | 4 PORT WASTE CAP | INACOM | 00938T-4W |  |  | 1
 | 28 | 20-019428 | FLANGELESS FITTING PEEK 5/16-24, 1/8" OD | INACOM | XP-130 |  | Polyetheretherketone (PEEK) | 1
 | 29 | 20-019432 | FITTING PEEK 1/4-28, 1/16" OD | INACOM | XP-235 |  | Polyetheretherketone (PEEK) | 16
 | 30 | 20-019433 | ADAPTER 1/4-28 x 5/16-24 PEEK | INACOM | P-135 |  | Polyetheretherketone (PEEK) | 1
 | 31 | 20-019435 | PEEK MANIFOLD 5 Port,1/16" | INACOM | P-154 |  | Polyetheretherketone (PEEK) | 1
 | 32 | 20-019437 | FITTING PEEK 1/4-28 - 1/8" OD | INACOM | XP-335 |  | Polyetheretherketone (PEEK) | 1
 | 33 | 20-019450 | PEEK Y CONNECTOR | INACOM | P-514 |  | Polyetheretherketone (PEEK) | 1
 | 34 | 20-019486 | DELRIN PLUG, 1/4-28 FLAT BOTTOM | INACOM | P-309 |  |  | 5
