Vitrotem/vitronotion/MVP_02/SHOPPING_LISTS/RVS PALEIS.xlsx

DOCUMENT PREVIEW | ITEM NO. | PartNo | DESCRIPTION | Vendor | VendorNo | Manufacturer | MATERIAL | QTY.
 | 42 | 13-016706 | M2.5 X 6 SHCS | RVS PALEIS | DIN 912 A4 M2.5 X 6 |  | AISI Type 316L stainless steel | 4
 | 43 | 13-016707 | M2.5 X 8 SHCS | RVS PALEIS | DIN 912 A4 M2.5 X 8 |  | AISI Type 316L stainless steel | 1
 | 44 | 13-016708 | M2.5 X 10 SHCS | RVS PALEIS | DIN 912 A4 M2.5 X 10 |  | AISI Type 316L stainless steel | 4
 | 45 | 13-016711 | M2.5 X 18 SHCS | RVS PALEIS | DIN 912 A4 M2.5 X 18 |  | AISI Type 316L stainless steel | 2
 | 46 | 13-016752 | M3 X 5 SHCS | RVS PALEIS | DIN 912 A4 M3 X 5 |  | AISI Type 316L stainless steel | 6
 | 47 | 13-016753 | M3 X 6 SHCS | RVS PALEIS | DIN 912 A4 M3 X 6 |  | AISI Type 316L stainless steel | 10
 | 48 | 13-016755 | M3 X 10 SHCS | RVS PALEIS | DIN 912 A4 M3 X 10 |  | AISI Type 316L stainless steel | 12
 | 49 | 13-016756 | M3 X 12 SHCS | RVS PALEIS | DIN 912 A4 M3 X 12 |  | AISI Type 316L stainless steel | 22
 | 50 | 13-016757 | M3 X 16 SHCS | RVS PALEIS | DIN 912 A4 M3 X 16 |  | AISI Type 316L stainless steel | 8
 | 51 | 13-016797 | M4 X 8 SHCS | RVS PALEIS | DIN 912 A4 M4 X 8 |  | AISI Type 316L stainless steel | 22
 | 52 | 13-016798 | M4 X 10 SHCS | RVS PALEIS | DIN 912 A4 M4 X 10 |  | AISI Type 316L stainless steel | 8
 | 53 | 13-016799 | M4 X 12 SHCS | RVS PALEIS | DIN 912 A4 M4 X 12 |  | AISI Type 316L stainless steel | 26
 | 54 | 13-016800 | M4 X 16 SHCS | RVS PALEIS | DIN 912 A4 M4 X 16 |  | AISI Type 316L stainless steel | 17
 | 55 | 13-016802 | M4 X 20 SHCS | RVS PALEIS | DIN 912 A4 M4 X 20 |  | AISI Type 316L stainless steel | 4
 | 56 | 13-016803 | M4 X 25 SHCS | RVS PALEIS | DIN 912 A4 M4 X 25 |  | AISI Type 316L stainless steel | 4
 | 57 | 13-016807 | M4 X 45 SHCS | RVS PALEIS | DIN 912 A4 M4 X 45 |  | AISI Type 316L stainless steel | 4
 | 58 | 13-016809 | M4 X 60 SHCS | RVS PALEIS | DIN 912 A4 M4 X 60 |  | AISI Type 316L stainless steel | 4
 | 59 | 13-016812 | M5 X 10 SHCS | RVS PALEIS | DIN 912 A4 M5 X 10 |  | AISI Type 316L stainless steel | 15
 | 60 | 13-016813 | M5 X 12 SHCS | RVS PALEIS | DIN 912 A4 M5 X 12 |  | AISI Type 316L stainless steel | 6
 | 61 | 13-016814 | M5 X 16 SHCS | RVS PALEIS | DIN 912 A4 M5 X 16 |  | AISI Type 316L stainless steel | 8
 | 62 | 13-016899 | M2.5 HEX NUT | RVS PALEIS | DIN 934 A4 M2.5 |  | AISI Type 316L stainless steel | 2
 | 63 | 13-016901 | M4 HEX NUT | RVS PALEIS | DIN 934 A4 M4 |  | AISI Type 316L stainless steel | 4
 | 64 | 13-017540 | M4 FLAT WASHER | RVS PALEIS | DIN 125 A4 M4 |  | AISI Type 316L stainless steel | 8
 | 65 | 13-017712 | 4 X 8 DP | RVS PALEIS | DIN 7 A1 4m6 X 8 |  | AISI Type 316L stainless steel | 6
 | 121 | 13-016835 | M6 X 30 SHCS | RVS PALEIS | DIN 912 A4 M6 X 30 |  | AISI Type 316L stainless steel | 2
