Vitrotem/vitronotion/MVP/SHOPPING_LISTS/DIBA INDUSTRIES.xlsx

DOCUMENT PREVIEW | ITEM NO. | PartNo | DESCRIPTION | Vendor | VendorNo | Manufacturer | MATERIAL | QTY.
 | 8 | 13-018362 | MVP-PRT: 2 PORT BOTTLE CAP | DIBA INDUSTRIES | 00938T-2F |  |  | 4
 | 9 | 13-018394 | MVP-PRT: LUER ADAPTER | DIBA INDUSTRIES | 009LA |  |  | 6
 | 10 | 13-018395 | MVP-PRT: LUER PLUG | DIBA INDUSTRIES | 009LP |  |  | 6
 | 11 | 13-018396 | MVP-PRT: 4 PORT WASTE CAP | DIBA INDUSTRIES | 00938T-4W |  |  | 1
