Vitrotem/vitronotion/MVP/BOM/IMG/13-017714.jpg

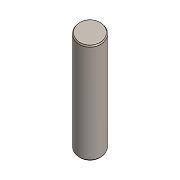
MVP/BOM/IMG/13-017714.jpg
