Vitrotem/vitronotion/MVP/BOM/IMG/13-018206.jpg

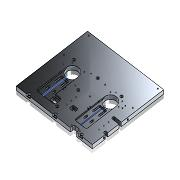
MVP/BOM/IMG/13-018206.jpg
