Vitrotem/vitronotion/MVP/BOM/IMG/13-018207.jpg

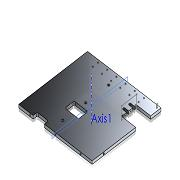
MVP/BOM/IMG/13-018207.jpg
