Vitrotem/vitronotion/MVP/BOM/IMG/13-018232.jpg

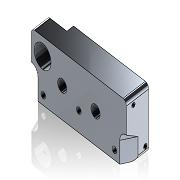
MVP/BOM/IMG/13-018232.jpg
