Vitrotem/vitronotion/MVP/BOM/IMG/13-018234.jpg

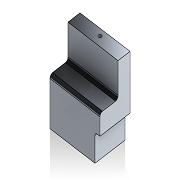
MVP/BOM/IMG/13-018234.jpg
