Vitrotem/vitronotion/MVP/BOM/IMG/13-018236.jpg

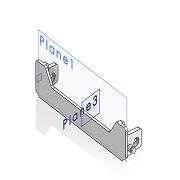
MVP/BOM/IMG/13-018236.jpg
