Vitrotem/vitronotion/MVP/BOM/IMG/13-018240.jpg

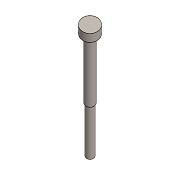
MVP/BOM/IMG/13-018240.jpg
