Vitrotem/vitronotion/MVP/BOM/IMG/13-018267.jpg

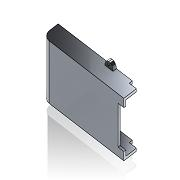
MVP/BOM/IMG/13-018267.jpg
