Vitrotem/vitronotion/MVP/BOM/IMG/13-018268.jpg

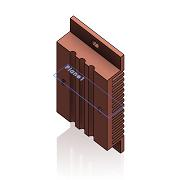
MVP/BOM/IMG/13-018268.jpg
