Vitrotem/vitronotion/MVP/BOM/IMG/13-018270.jpg

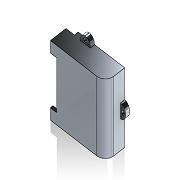
MVP/BOM/IMG/13-018270.jpg
