Vitrotem/vitronotion/MVP/BOM/IMG/13-018283.jpg

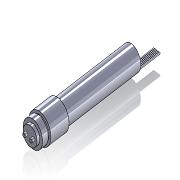
MVP/BOM/IMG/13-018283.jpg
