Vitrotem/vitronotion/MVP/BOM/IMG/13-018313.jpg

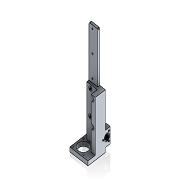
MVP/BOM/IMG/13-018313.jpg
