Vitrotem/vitronotion/MVP/BOM/IMG/13-018314.jpg

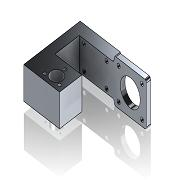
MVP/BOM/IMG/13-018314.jpg
