Vitrotem/vitronotion/MVP/BOM/IMG/13-018423.jpg

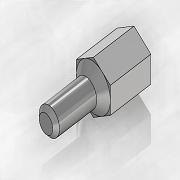
MVP/BOM/IMG/13-018423.jpg
