Vitrotem/vitronotion/MVP/BOM/IMG/13-018431.jpg

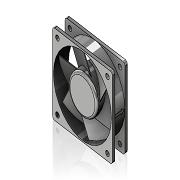
MVP/BOM/IMG/13-018431.jpg
