Vitrotem/vitronotion/MVP/BOM/IMG/13-018436.jpg

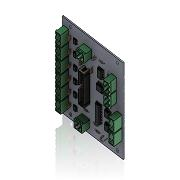
MVP/BOM/IMG/13-018436.jpg
