Vitrotem/vitronotion/MVP/BOM/IMG/13-018437.jpg

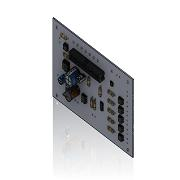
MVP/BOM/IMG/13-018437.jpg
