Vitrotem/vitronotion/MVP/BOM/IMG/13-018438.jpg

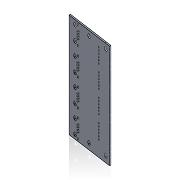
MVP/BOM/IMG/13-018438.jpg
