Vitrotem/vitronotion/MVP_02/BOM/IMG/13-016706.jpg

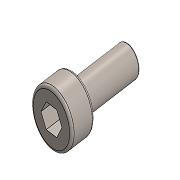
MVP_02/BOM/IMG/13-016706.jpg
