Vitrotem/vitronotion/MVP_02/BOM/IMG/13-016707.jpg

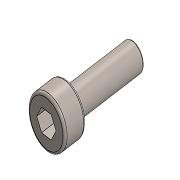
MVP_02/BOM/IMG/13-016707.jpg
