Vitrotem/vitronotion/MVP_02/BOM/IMG/13-016809.jpg

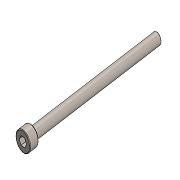
MVP_02/BOM/IMG/13-016809.jpg
