Vitrotem/vitronotion/MVP_02/BOM/IMG/20-019372.jpg

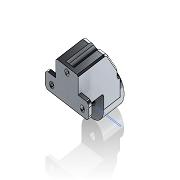
MVP_02/BOM/IMG/20-019372.jpg
