Vitrotem/vitronotion/MVP_02/BOM/IMG/20-019373.jpg

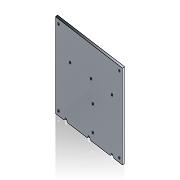
MVP_02/BOM/IMG/20-019373.jpg
