Vitrotem/vitronotion/MVP_02/BOM/IMG/20-019376.jpg

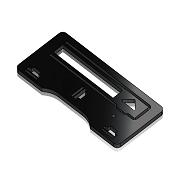
MVP_02/BOM/IMG/20-019376.jpg
