Vitrotem/vitronotion/MVP_02/BOM/IMG/20-019388.jpg

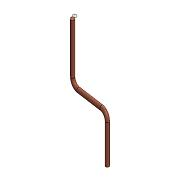
MVP_02/BOM/IMG/20-019388.jpg
