Vitrotem/vitronotion/MVP_02/BOM/IMG/20-019399.jpg

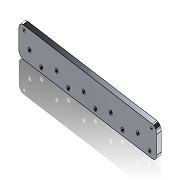
MVP_02/BOM/IMG/20-019399.jpg
