Vitrotem/vitronotion/MVP_02/BOM/IMG/20-019401.jpg

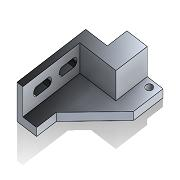
MVP_02/BOM/IMG/20-019401.jpg
