Vitrotem/vitronotion/MVP_02/BOM/IMG/20-019406.jpg

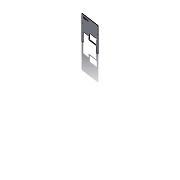
MVP_02/BOM/IMG/20-019406.jpg
