Vitrotem/vitronotion/MVP_02/BOM/IMG/20-019407.jpg

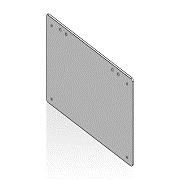
MVP_02/BOM/IMG/20-019407.jpg
