Vitrotem/vitronotion/MVP_02/BOM/IMG/20-019408.jpg

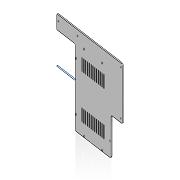
MVP_02/BOM/IMG/20-019408.jpg
