Vitrotem/vitronotion/MVP_02/BOM/IMG/20-019410.jpg

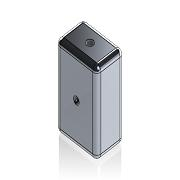
MVP_02/BOM/IMG/20-019410.jpg
