Vitrotem/vitronotion/MVP_02/BOM/IMG/20-019453.jpg

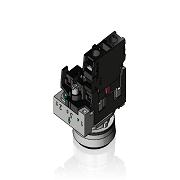
MVP_02/BOM/IMG/20-019453.jpg
