Vitrotem/vitronotion/MVP_02/BOM/IMG/20-019454.jpg

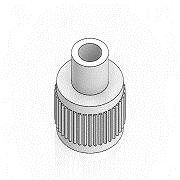
MVP_02/BOM/IMG/20-019454.jpg
