Vitrotem/vitronotion/MVP_02/BOM/IMG/20-019455.jpg

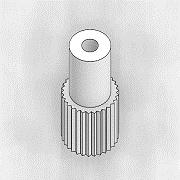
MVP_02/BOM/IMG/20-019455.jpg
