Vitrotem/vitronotion/MVP_02/BOM/IMG/20-019456.jpg

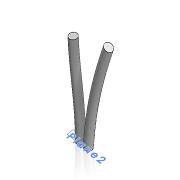
MVP_02/BOM/IMG/20-019456.jpg
