Vitrotem/vitronotion/MVP_02/BOM/IMG/20-019468.jpg

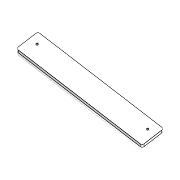
MVP_02/BOM/IMG/20-019468.jpg
