Vitrotem/vitronotion/MVP_02/BOM/IMG/20-019482.jpg

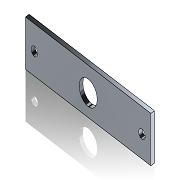
MVP_02/BOM/IMG/20-019482.jpg
