Vitrotem/vitronotion/MVP_02/BOM/IMG/20-019489.jpg

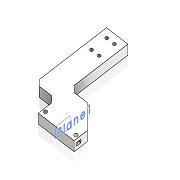
MVP_02/BOM/IMG/20-019489.jpg
