Vitrotem/vitronotion/MVP_02/BOM/IMG/20-019495.jpg

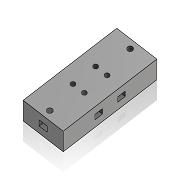
MVP_02/BOM/IMG/20-019495.jpg
