Vitrotem/vitronotion/MVP_02/BOM/IMG/20-019498.jpg

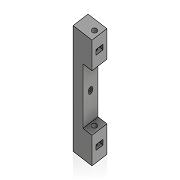
MVP_02/BOM/IMG/20-019498.jpg
