Vitrotem/vitronotion/MVP_02/BOM/IMG/20-019499.jpg

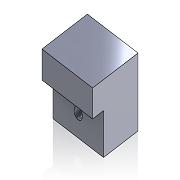
MVP_02/BOM/IMG/20-019499.jpg
