Vitrotem/vitronotion/MVP_02/BOM/IMG/20-019500.jpg

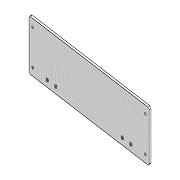
MVP_02/BOM/IMG/20-019500.jpg
