Vitrotem/vitronotion/MVP_02/BOM/IMG/20-019501.jpg

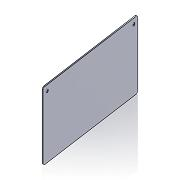
MVP_02/BOM/IMG/20-019501.jpg
