Vitrotem/vitronotion/MVP_02/BOM/IMG/20-019502.jpg

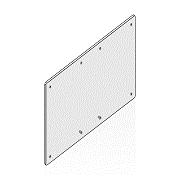
MVP_02/BOM/IMG/20-019502.jpg
