Vitrotem/vitronotion/MVP_02/BOM/IMG/20-019504.jpg

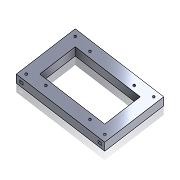
MVP_02/BOM/IMG/20-019504.jpg
