Vitrotem/vitronotion/MVP_02/BOM/IMG/20-019505.jpg

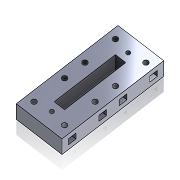
MVP_02/BOM/IMG/20-019505.jpg
