Vitrotem/vitronotion/MVP_02/BOM/IMG/20-019506.jpg

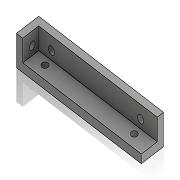
MVP_02/BOM/IMG/20-019506.jpg
