Vitrotem/vitronotion/MVP_02/BOM/IMG/20-019511.jpg

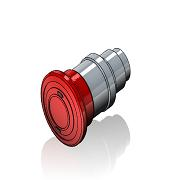
MVP_02/BOM/IMG/20-019511.jpg
