Vitrotem/vitronotion/MVP_02/BOM/IMG/20-019526.jpg

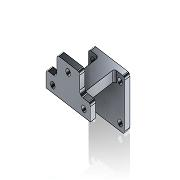
MVP_02/BOM/IMG/20-019526.jpg
