Vitrotem/vitronotion/MVP_02/BOM/IMG/20-019633.jpg

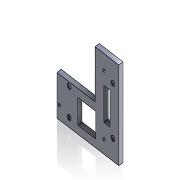
MVP_02/BOM/IMG/20-019633.jpg
