Vitrotem/vitronotion/NAIAD/BOM/IMG/13-016799.jpg

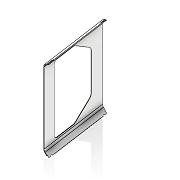
NAIAD/BOM/IMG/13-016799.jpg
