Vitrotem/vitronotion/NAIAD/BOM/IMG/20-019669.jpg

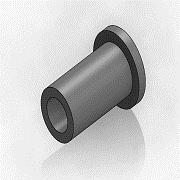
NAIAD/BOM/IMG/20-019669.jpg
