Vitrotem/vitronotion/NAIAD/BOM/IMG/20-019746.jpg

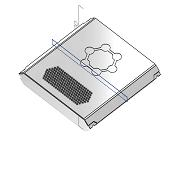
NAIAD/BOM/IMG/20-019746.jpg
