Vitrotem/vitronotion/NAIAD/BOM/IMG/20-019752.jpg

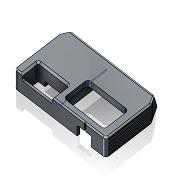
NAIAD/BOM/IMG/20-019752.jpg
