Vitrotem/vitronotion/NAIAD/BOM/IMG/20-019760.jpg

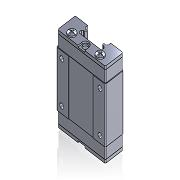
NAIAD/BOM/IMG/20-019760.jpg
