Vitrotem/vitronotion/NAIAD/BOM/IMG/20-019765.jpg

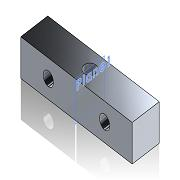
NAIAD/BOM/IMG/20-019765.jpg
