Vitrotem/vitronotion/NAIAD/BOM/IMG/20-019769.jpg

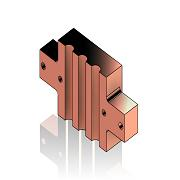
NAIAD/BOM/IMG/20-019769.jpg
