Vitrotem/vitronotion/NAIAD/BOM/IMG/20-019770.jpg

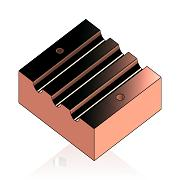
NAIAD/BOM/IMG/20-019770.jpg
