Vitrotem/vitronotion/NAIAD/BOM/IMG/20-019771.jpg

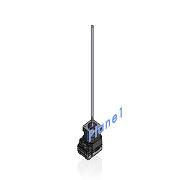
NAIAD/BOM/IMG/20-019771.jpg
