Vitrotem/vitronotion/NAIAD/BOM/IMG/20-019772.jpg

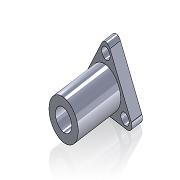
NAIAD/BOM/IMG/20-019772.jpg
