Vitrotem/vitronotion/NAIAD/BOM/IMG/20-019774.jpg

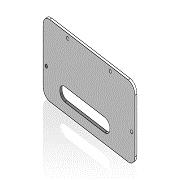
NAIAD/BOM/IMG/20-019774.jpg
