Vitrotem/vitronotion/NAIAD/BOM/IMG/20-019776.jpg

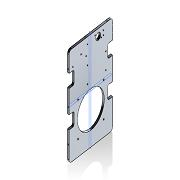
NAIAD/BOM/IMG/20-019776.jpg
