Vitrotem/vitronotion/NAIAD/BOM/IMG/20-019777.jpg

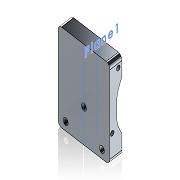
NAIAD/BOM/IMG/20-019777.jpg
