Vitrotem/vitronotion/NAIAD/BOM/IMG/20-019779.jpg

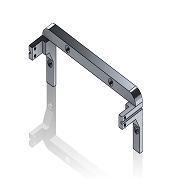
NAIAD/BOM/IMG/20-019779.jpg
