Vitrotem/vitronotion/NAIAD/BOM/IMG/20-019780.jpg

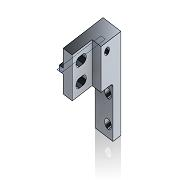
NAIAD/BOM/IMG/20-019780.jpg
