Vitrotem/vitronotion/NAIAD/BOM/IMG/20-019781.jpg

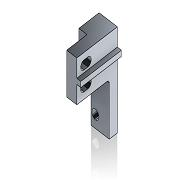
NAIAD/BOM/IMG/20-019781.jpg
