Vitrotem/vitronotion/NAIAD/BOM/IMG/20-019785.jpg

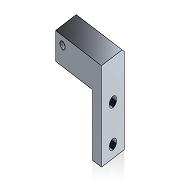
NAIAD/BOM/IMG/20-019785.jpg
