Vitrotem/vitronotion/NAIAD/BOM/IMG/20-019789.jpg

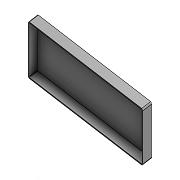
NAIAD/BOM/IMG/20-019789.jpg
