Vitrotem/vitronotion/NAIAD/BOM/IMG/20-019790.jpg

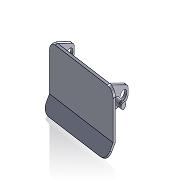
NAIAD/BOM/IMG/20-019790.jpg
