Vitrotem/vitronotion/NAIAD/BOM/IMG/20-019791.jpg

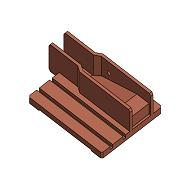
NAIAD/BOM/IMG/20-019791.jpg
