Vitrotem/vitronotion/NAIAD/BOM/IMG/20-019793.jpg

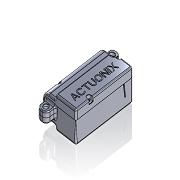
NAIAD/BOM/IMG/20-019793.jpg
