Vitrotem/vitronotion/NAIAD/BOM/IMG/20-019794.jpg

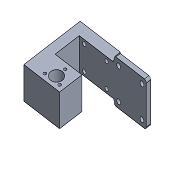
NAIAD/BOM/IMG/20-019794.jpg
