Vitrotem/vitronotion/NAIAD/BOM/IMG/20-019798.jpg

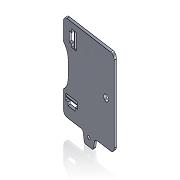
NAIAD/BOM/IMG/20-019798.jpg
