Vitrotem/vitronotion/NAIAD/BOM/IMG/20-019800.jpg

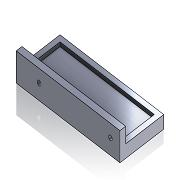
NAIAD/BOM/IMG/20-019800.jpg
