Vitrotem/vitronotion/NAIAD/BOM/IMG/20-019802.jpg

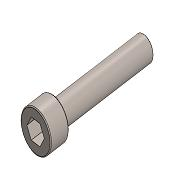
NAIAD/BOM/IMG/20-019802.jpg
