Vitrotem/vitronotion/NAIAD/BOM/IMG/20-019807.jpg

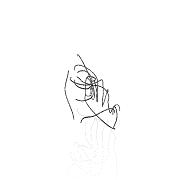
NAIAD/BOM/IMG/20-019807.jpg
