Vitrotem/vitronotion/NAIAD/BOM/IMG/20-019808.jpg

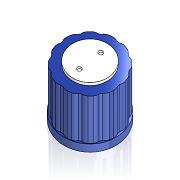
NAIAD/BOM/IMG/20-019808.jpg
