Vitrotem/vitronotion/NAIAD/BOM/IMG/20-019809.jpg

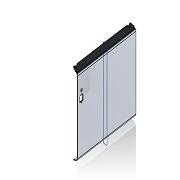
NAIAD/BOM/IMG/20-019809.jpg
