Vitrotem/vitronotion/NAIAD/BOM/IMG/20-019810.jpg

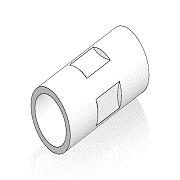
NAIAD/BOM/IMG/20-019810.jpg
