Vitrotem/vitronotion/NAIAD/BOM/IMG/20-019812.jpg

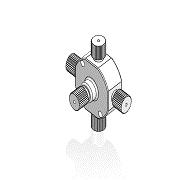
NAIAD/BOM/IMG/20-019812.jpg
