Vitrotem/vitronotion/NAIAD/BOM/IMG/20-019814.jpg

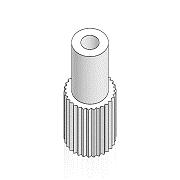
NAIAD/BOM/IMG/20-019814.jpg
