Vitrotem/vitronotion/NAIAD/BOM/IMG/20-019819.jpg

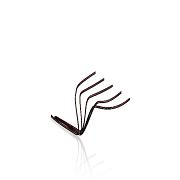
NAIAD/BOM/IMG/20-019819.jpg
