Vitrotem/vitronotion/NAIAD/BOM/IMG/20-019824.jpg

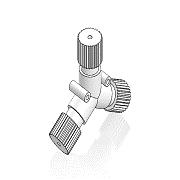
NAIAD/BOM/IMG/20-019824.jpg
