Vitrotem/vitronotion/NAIAD/BOM/IMG/20-019825.jpg

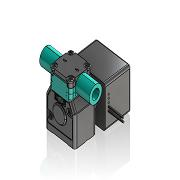
NAIAD/BOM/IMG/20-019825.jpg
