Vitrotem/vitronotion/NAIAD/BOM/IMG/20-019826.jpg

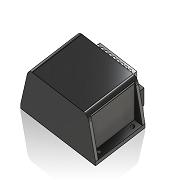
NAIAD/BOM/IMG/20-019826.jpg
