Vitrotem/vitronotion/NAIAD/BOM/IMG/20-019827.jpg

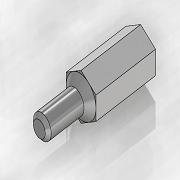
NAIAD/BOM/IMG/20-019827.jpg
