Vitrotem/vitronotion/NAIAD/BOM/IMG/20-019832.jpg

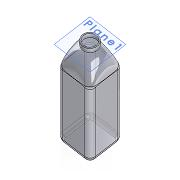
NAIAD/BOM/IMG/20-019832.jpg
