Vitrotem/vitronotion/NAIAD/BOM/IMG/20-019835.jpg

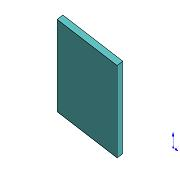
NAIAD/BOM/IMG/20-019835.jpg
