Vitrotem/vitronotion/NAIAD/BOM/IMG/20-019836.jpg

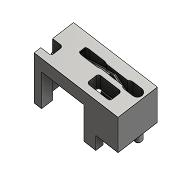
NAIAD/BOM/IMG/20-019836.jpg
