Vitrotem/vitronotion/NAIAD/BOM/IMG/20-019838.jpg

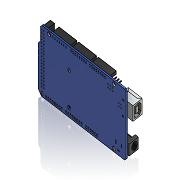
NAIAD/BOM/IMG/20-019838.jpg
