Vitrotem/vitronotion/NAIAD/BOM/IMG/20-019843.jpg

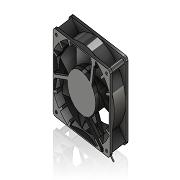
NAIAD/BOM/IMG/20-019843.jpg
