Vitrotem/vitronotion/NAIAD/BOM/IMG/20-019846.jpg

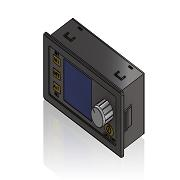
NAIAD/BOM/IMG/20-019846.jpg
