Vitrotem/vitronotion/NAIAD/BOM/IMG/20-019848.jpg

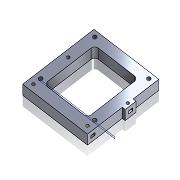
NAIAD/BOM/IMG/20-019848.jpg
