Vitrotem/vitronotion/NAIAD/BOM/IMG/20-019849.jpg

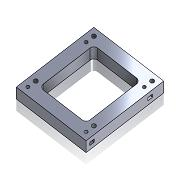
NAIAD/BOM/IMG/20-019849.jpg
