Vitrotem/vitronotion/NAIAD/BOM/IMG/20-019850.jpg

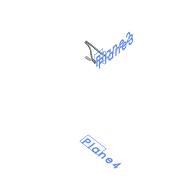
NAIAD/BOM/IMG/20-019850.jpg
