Vitrotem/vitronotion/NAIAD/BOM/IMG/20-019851.jpg

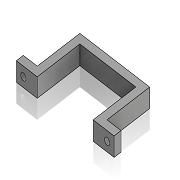
NAIAD/BOM/IMG/20-019851.jpg
