Vitrotem/vitronotion/NAIAD/BOM/IMG/20-019854.jpg

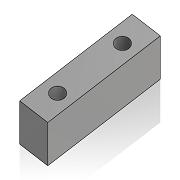
NAIAD/BOM/IMG/20-019854.jpg
