Vitrotem/vitronotion/NAIAD/BOM/IMG/20-019855.jpg

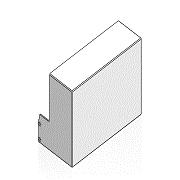
NAIAD/BOM/IMG/20-019855.jpg
