Vitrotem/vitronotion/NAIAD/BOM/IMG/20-019858.jpg

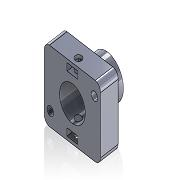
NAIAD/BOM/IMG/20-019858.jpg
