Vitrotem/vitronotion/NAIAD/BOM/IMG/20-019859.jpg

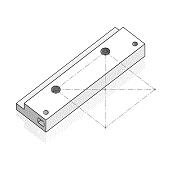
NAIAD/BOM/IMG/20-019859.jpg
