Vitrotem/vitronotion/NAIAD/BOM/IMG/20-019861.jpg

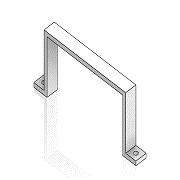
NAIAD/BOM/IMG/20-019861.jpg
