Vitrotem/vitronotion/NAIAD/BOM/IMG/20-019872.jpg

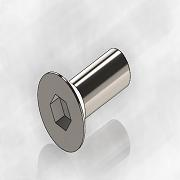
NAIAD/BOM/IMG/20-019872.jpg
