Vitrotem/vitronotion/NAIAD/BOM/IMG/20-019876.jpg

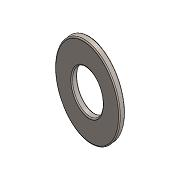
NAIAD/BOM/IMG/20-019876.jpg
