Vitrotem/vitronotion/NAIAD/BOM/IMG/20-019881.jpg

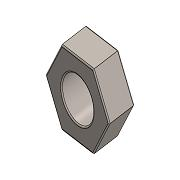
NAIAD/BOM/IMG/20-019881.jpg
