Vitrotem/vitronotion/NAIAD/BOM/IMG/20-019882.jpg

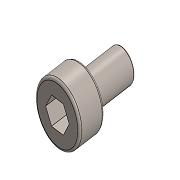
NAIAD/BOM/IMG/20-019882.jpg
