Vitrotem/vitronotion/NAIAD/BOM/IMG/20-019888.jpg

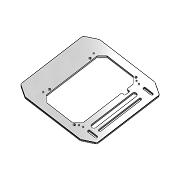
NAIAD/BOM/IMG/20-019888.jpg
