Vitrotem/vitronotion/NAIAD/BOM/IMG/20-019891.jpg

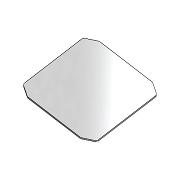
NAIAD/BOM/IMG/20-019891.jpg
