Vitrotem/vitronotion/NAIAD/BOM/IMG/20-019894.jpg

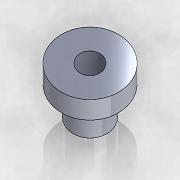
NAIAD/BOM/IMG/20-019894.jpg
