Vitrotem/vitronotion/NAIAD/BOM/IMG/20-019896.jpg

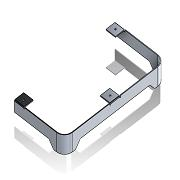
NAIAD/BOM/IMG/20-019896.jpg
