Vitrotem/vitronotion/NAIAD/BOM/IMG/20-019897.jpg

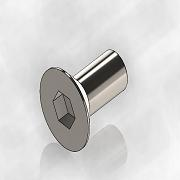
NAIAD/BOM/IMG/20-019897.jpg
