Vitrotem/vitronotion/NAIAD/BOM/IMG/20-019898.jpg

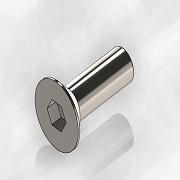
NAIAD/BOM/IMG/20-019898.jpg
