Vitrotem/vitronotion/NAIAD/BOM/IMG/20-019899.jpg

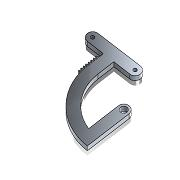
NAIAD/BOM/IMG/20-019899.jpg
