Vitrotem/vitronotion/NAIAD/BOM/IMG/20-019906.jpg

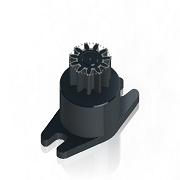
NAIAD/BOM/IMG/20-019906.jpg
