Vitrotem/vitronotion/MVP/SHOPPING_LISTS/LASERBEEST/13-018426.step

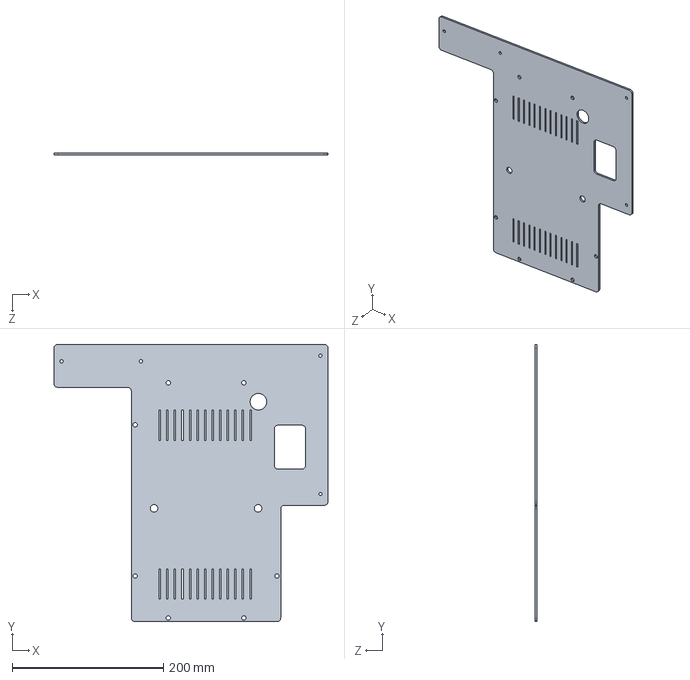
[picture p116: CAD file, 2022-03-07]
MVP/SHOPPING_LISTS/LASERBEEST/13-018426.step
362.5 x 367.0 x 3.00 mm
