Vitrotem/vitronotion/MVP/SHOPPING_LISTS/PRECISION MICRO/13-018219.step

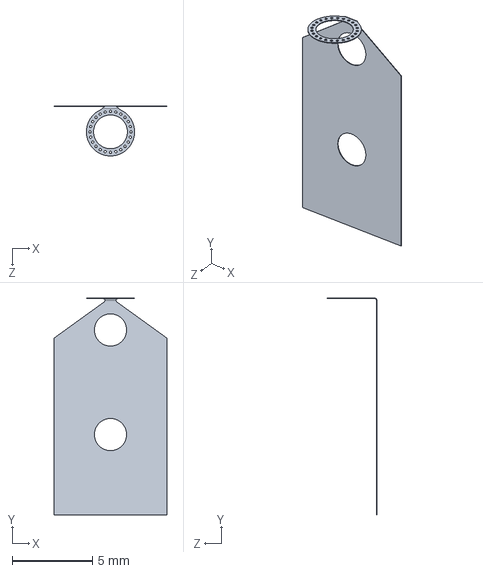
[picture p117: CAD file, 2022-03-07]
MVP/SHOPPING_LISTS/PRECISION MICRO/13-018219.step
7.00 x 13.5 x 3.10 mm
