Vitrotem/vitronotion/MVP/SHOPPING_LISTS/QUICKCOOL/13-018269.step

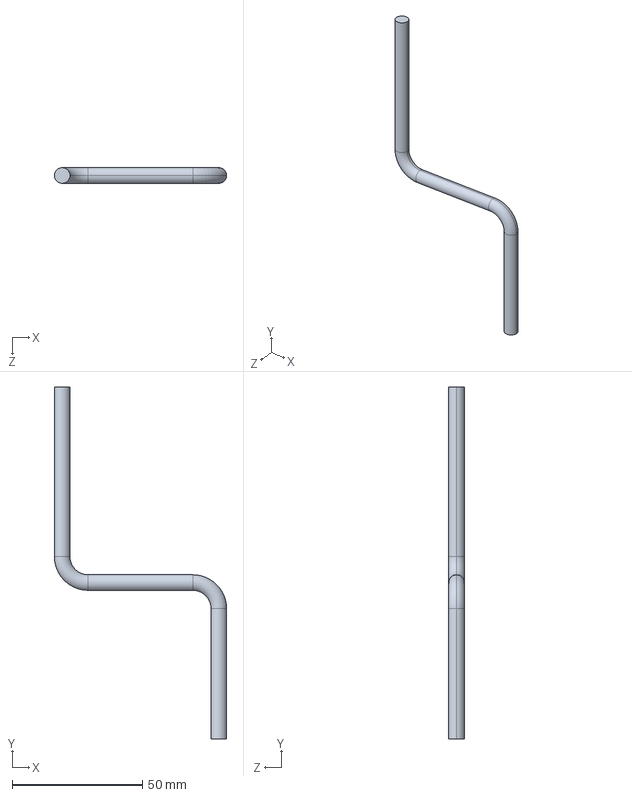
[picture p118: CAD file, 2022-03-07]
MVP/SHOPPING_LISTS/QUICKCOOL/13-018269.step
66.1 x 135.0 x 5.99 mm
