Vitrotem/vitronotion/MVP/SHOPPING_LISTS/SUPE/13-018236.step

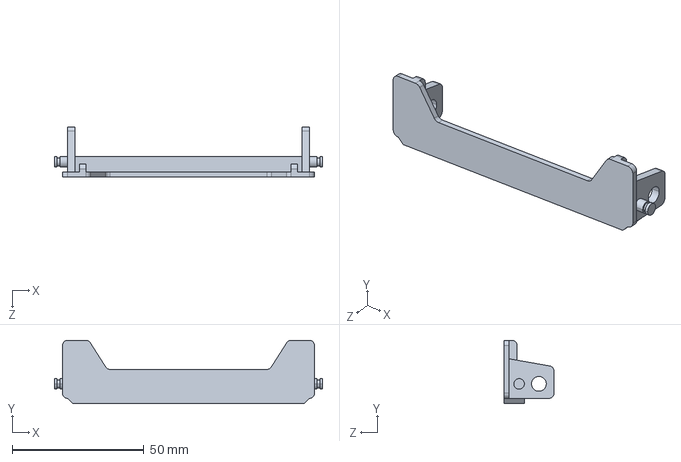
[picture p119: CAD file, 2022-03-07]
MVP/SHOPPING_LISTS/SUPE/13-018236.step
101.6 x 24.0 x 19.0 mm
