Vitrotem/vitronotion/MVP_02/SHOPPING_LISTS/LASERBEEST/20-019529.dxf

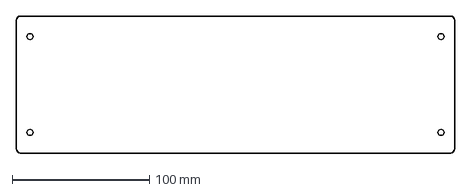
[picture p120: CAD file, 2022-06-14]
MVP_02/SHOPPING_LISTS/LASERBEEST/20-019529.dxf
320.0 x 100.0 mm
