Vitrotem/vitronotion/MVP_02/SHOPPING_LISTS/QUICKCOOL/20-019388--HEATPIPE--Rev_B.step

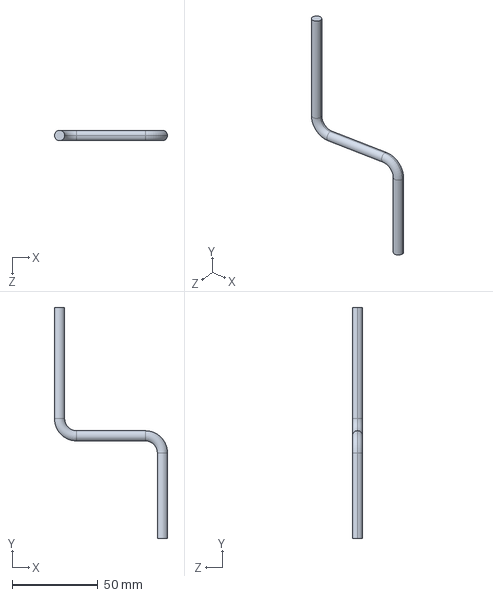
[picture p121: CAD file, 2022-06-14]
MVP_02/SHOPPING_LISTS/QUICKCOOL/20-019388--HEATPIPE--Rev_B.step
66.1 x 135.0 x 5.99 mm
