Vitrotem/vitronotion/MVP_02/SHOPPING_LISTS/SCHNEIDER/20-019511.step

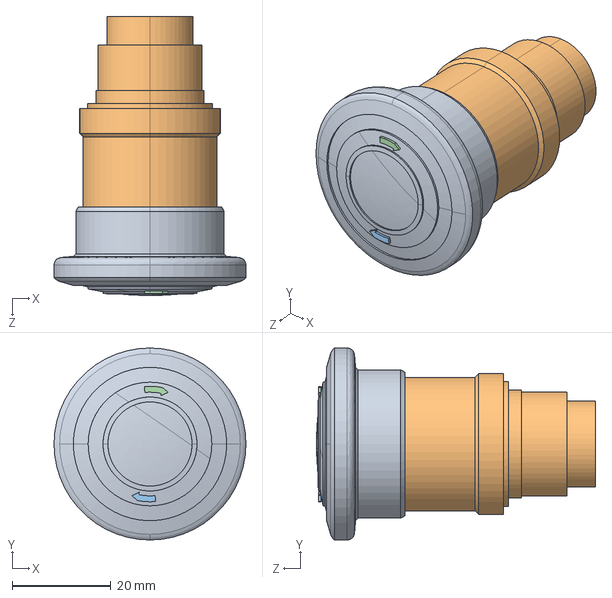
[picture p122: CAD file, 2022-04-21]
MVP_02/SHOPPING_LISTS/SCHNEIDER/20-019511.step
38.8 x 38.8 x 56.4 mm
