Vitrotem/vitronotion/MVP_02/SHOPPING_LISTS/SUPE/20-019362--BASE PLATE--Rev_A.step

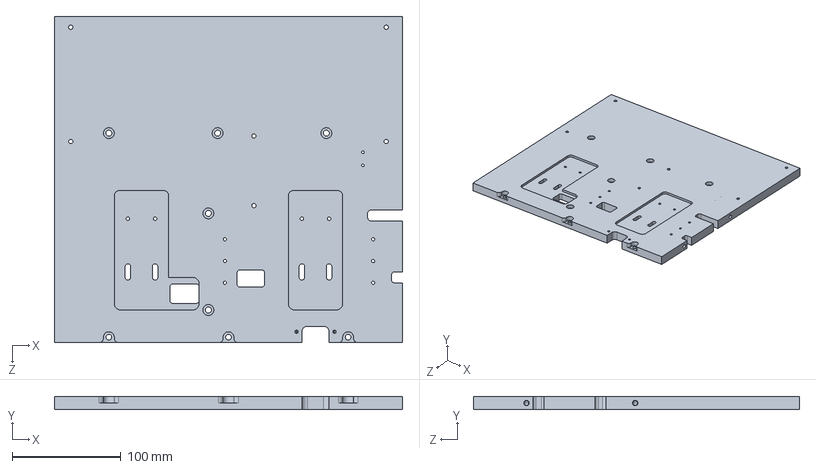
[picture p123: CAD file, 2022-06-14]
MVP_02/SHOPPING_LISTS/SUPE/20-019362--BASE PLATE--Rev_A.step
320.0 x 12.0 x 300.0 mm
