Vitrotem/vitronotion/MVP/SHOPPING_LISTS/LASERBEEST/13-018218.step

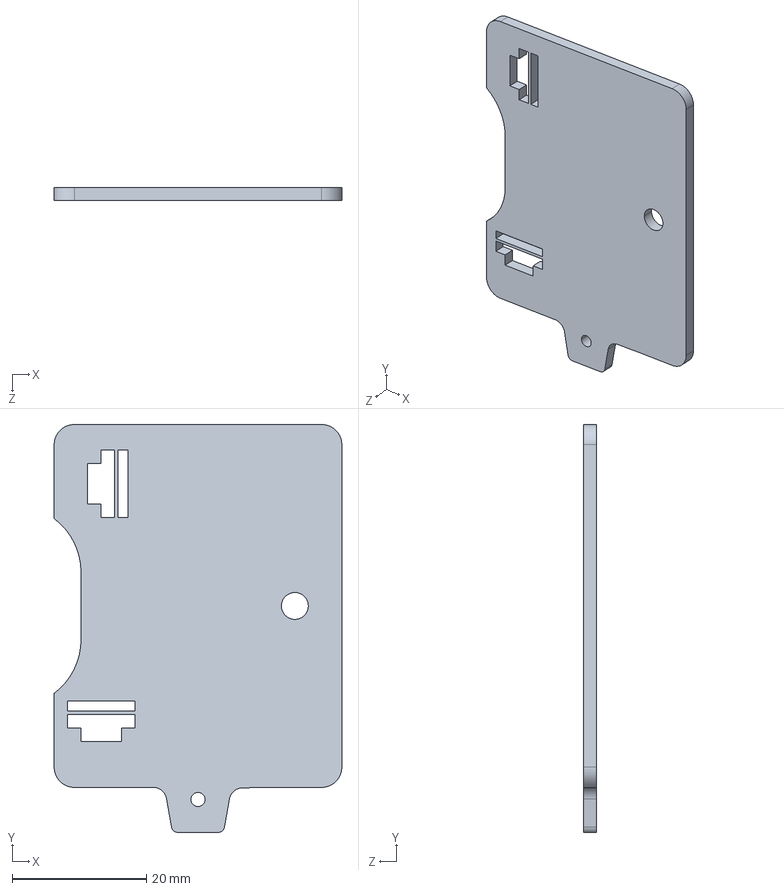
[picture p124: CAD file, 2022-03-07]
MVP/SHOPPING_LISTS/LASERBEEST/13-018218.step
42.8 x 60.7 x 2.00 mm
