Vitrotem/vitronotion/MVP_02/SHOPPING_LISTS/LASERBEEST/20-019406--TOP COVER --Rev_A.step

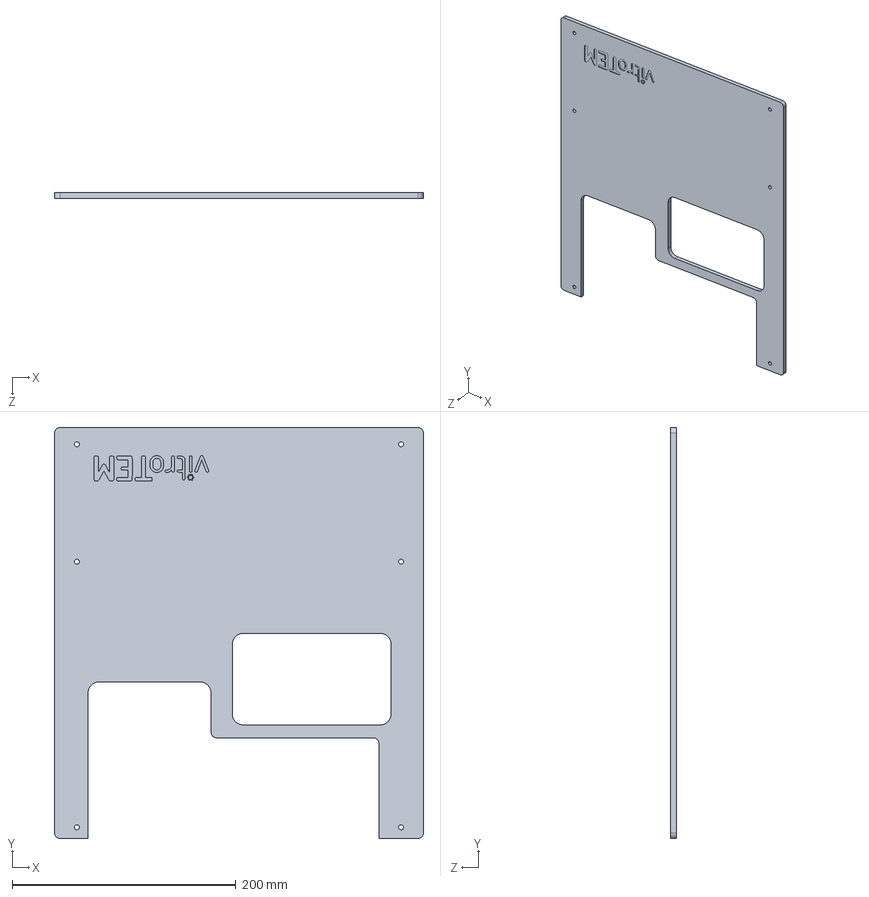
[picture p126: CAD file, 2022-06-14]
MVP_02/SHOPPING_LISTS/LASERBEEST/20-019406--TOP COVER --Rev_A.step
330.0 x 367.5 x 5.00 mm
