Vitrotem/vitronotion/MVP_02/SHOPPING_LISTS/SUPE/20-019374--FLOWCELL SLIDER--Rev_A.step

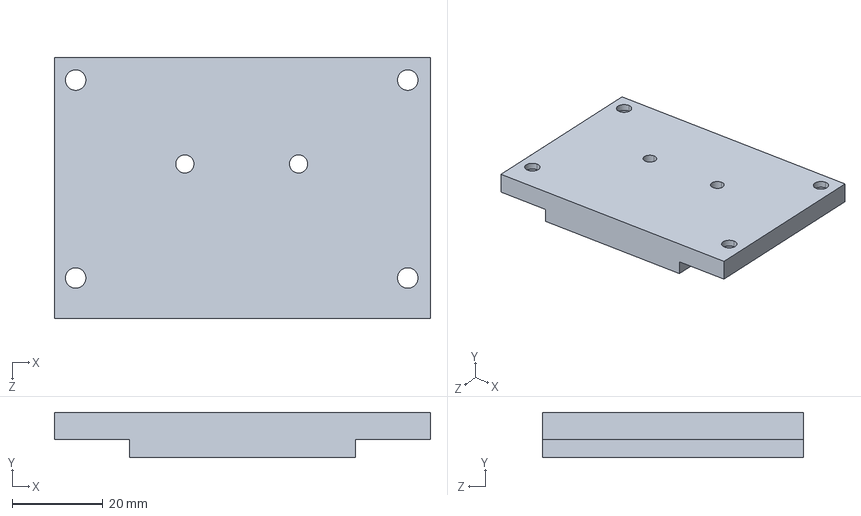
[picture p127: CAD file, 2022-06-14]
MVP_02/SHOPPING_LISTS/SUPE/20-019374--FLOWCELL SLIDER--Rev_A.step
82.6 x 10.0 x 57.4 mm
