Vitrotem/vitronotion/MVP/SHOPPING_LISTS/LASERBEEST/13-018433.step

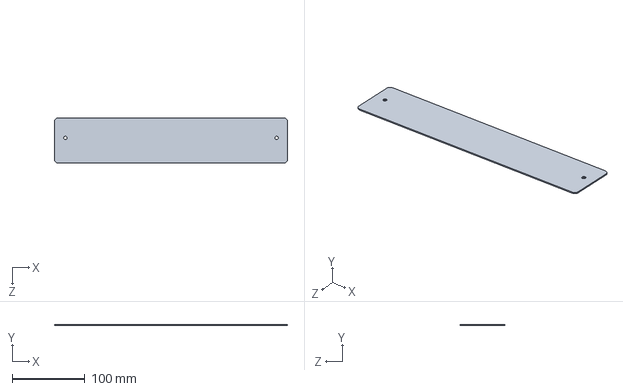
[picture p128: CAD file, 2022-03-07]
MVP/SHOPPING_LISTS/LASERBEEST/13-018433.step
320.0 x 1.50 x 62.0 mm
