Vitrotem/vitronotion/MVP/SHOPPING_LISTS/SUPE/13-018285.step

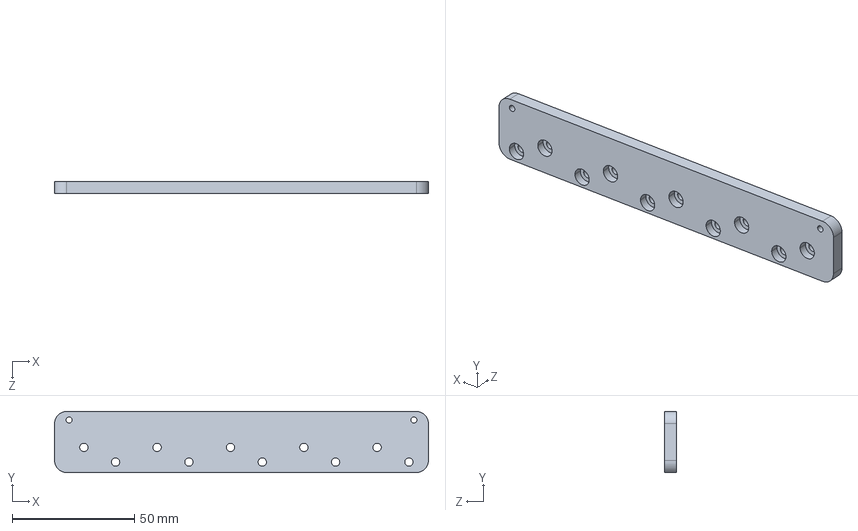
[picture p129: CAD file, 2022-03-07]
MVP/SHOPPING_LISTS/SUPE/13-018285.step
153.0 x 25.0 x 5.00 mm
