Vitrotem/vitronotion/MVP_02/SHOPPING_LISTS/SUPE/20-019389--FLOWCELL COVER--Rev_A.step

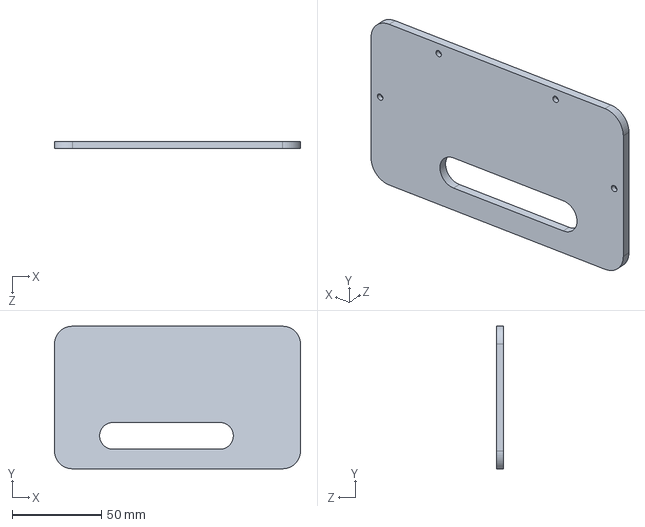
[picture p130: CAD file, 2022-06-14]
MVP_02/SHOPPING_LISTS/SUPE/20-019389--FLOWCELL COVER--Rev_A.step
138.0 x 80.0 x 4.00 mm
