Vitrotem/vitronotion/MVP/SHOPPING_LISTS/LASERBEEST/13-018748.step

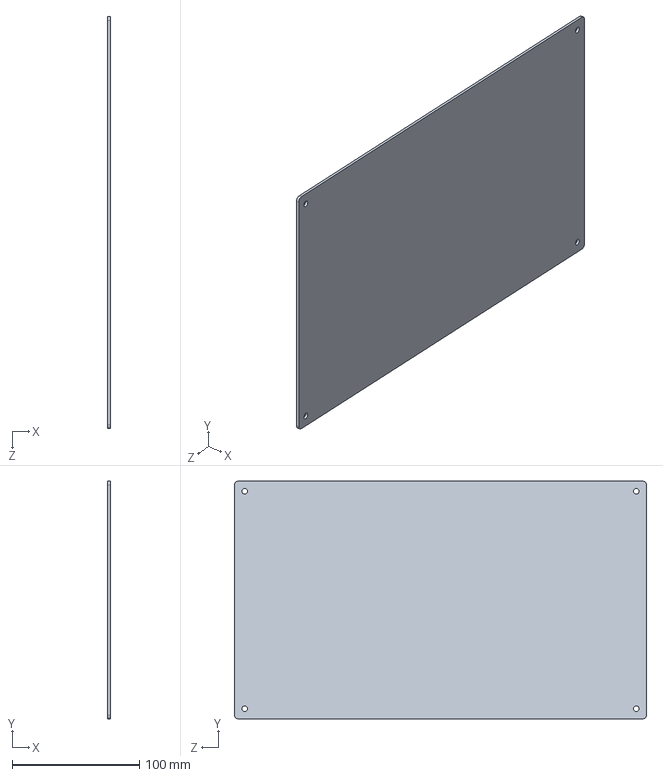
[picture p131: CAD file, 2022-03-07]
MVP/SHOPPING_LISTS/LASERBEEST/13-018748.step
2.00 x 187.0 x 324.0 mm
