Vitrotem/vitronotion/MVP/SHOPPING_LISTS/SUPE/13-018268.step

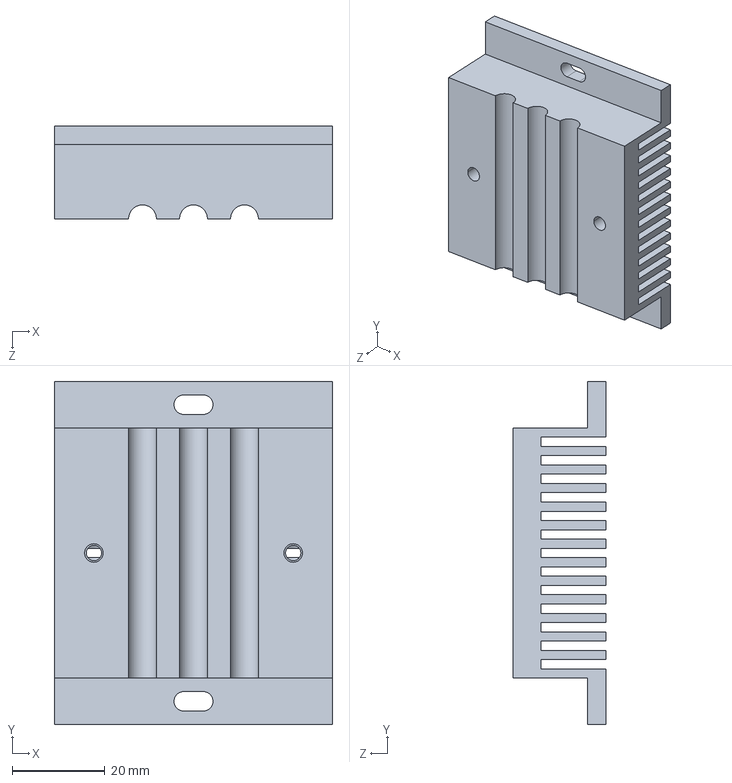
[picture p132: CAD file, 2022-03-07]
MVP/SHOPPING_LISTS/SUPE/13-018268.step
60.0 x 74.0 x 20.0 mm
