Vitrotem/vitronotion/MVP_02/SHOPPING_LISTS/LASERBEEST/20-019502--COVER C--Rev_A.step

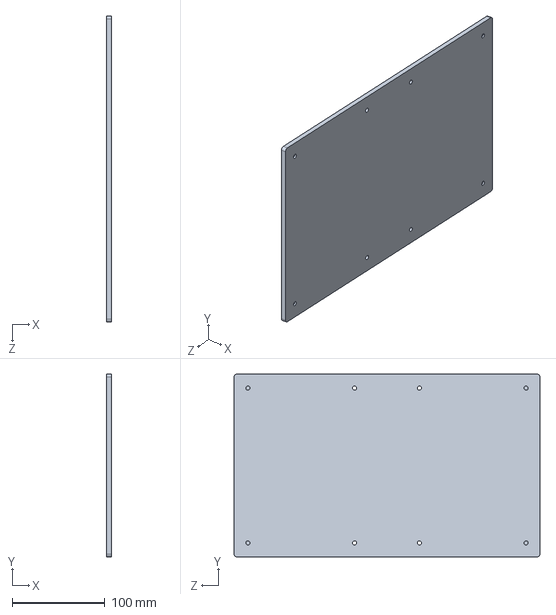
[picture p133: CAD file, 2022-06-14]
MVP_02/SHOPPING_LISTS/LASERBEEST/20-019502--COVER C--Rev_A.step
5.00 x 197.0 x 330.0 mm
