Vitrotem/vitronotion/MVP_02/SHOPPING_LISTS/SUPE/20-019377--CARTRIDGE LANDING PAD--Rev_A.step

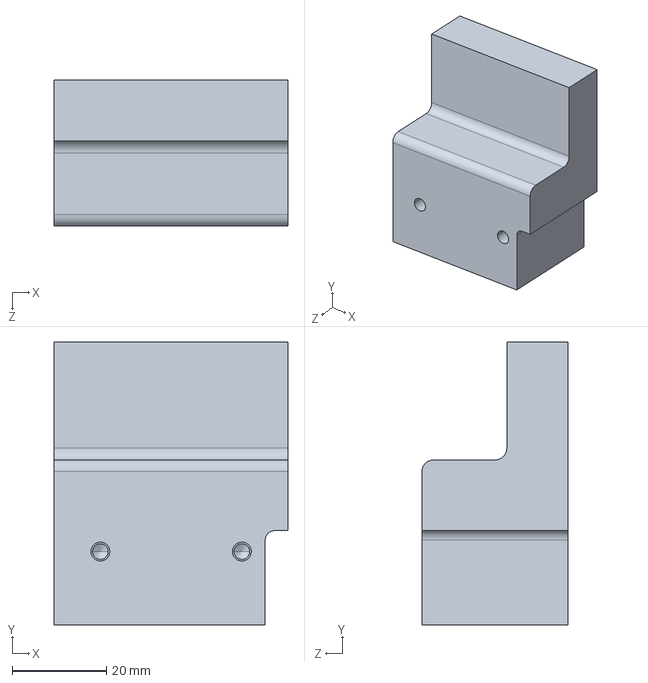
[picture p134: CAD file, 2022-06-14]
MVP_02/SHOPPING_LISTS/SUPE/20-019377--CARTRIDGE LANDING PAD--Rev_A.step
49.6 x 60.0 x 31.0 mm
