Vitrotem/vitronotion/MVP/SHOPPING_LISTS/LASERBEEST/13-018294.step

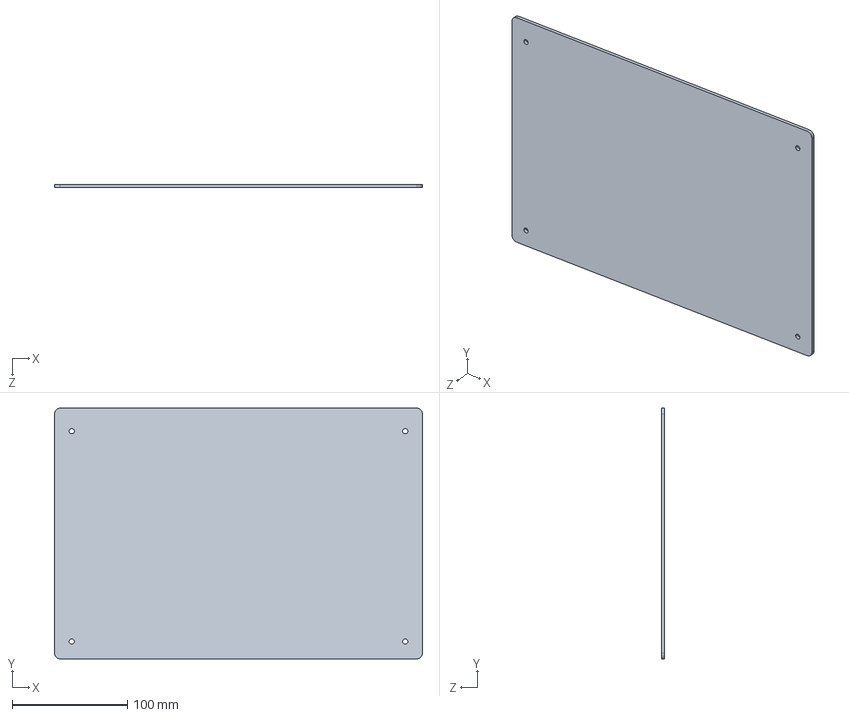
[picture p135: CAD file, 2022-03-07]
MVP/SHOPPING_LISTS/LASERBEEST/13-018294.step
320.0 x 218.0 x 3.00 mm
