Vitrotem/vitronotion/MVP/SHOPPING_LISTS/SUPE/13-018274.step

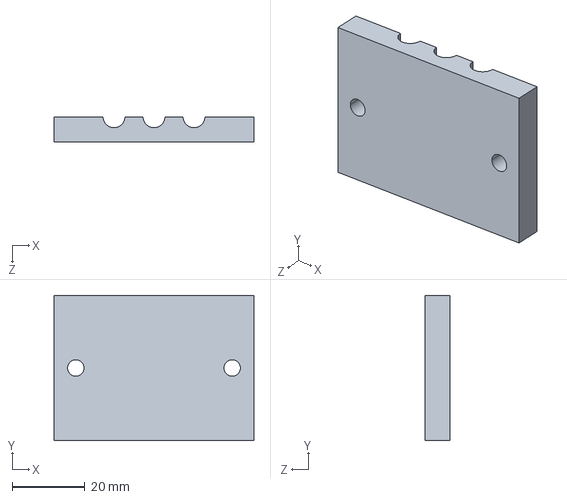
[picture p136: CAD file, 2022-03-07]
MVP/SHOPPING_LISTS/SUPE/13-018274.step
55.0 x 40.0 x 7.00 mm
