Vitrotem/vitronotion/MVP_02/SHOPPING_LISTS/LASERBEEST/20-019500--COVER A--Rev_A.step

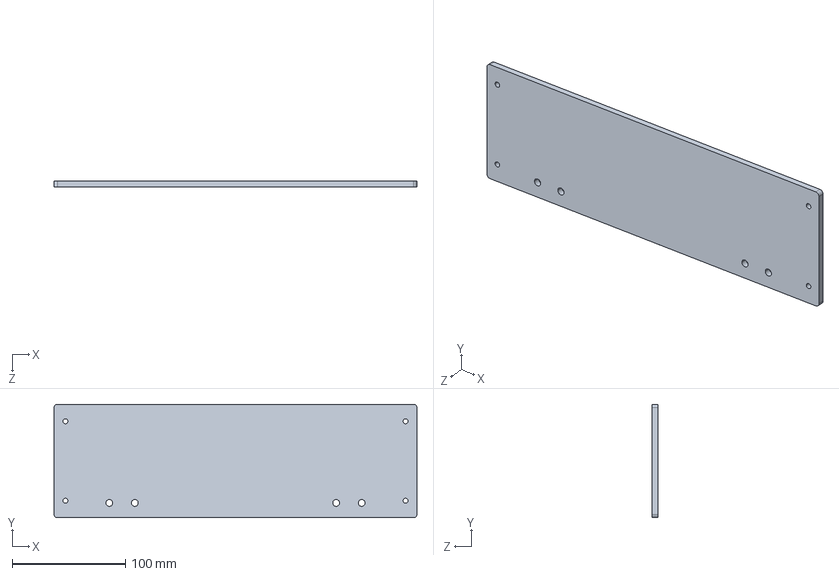
[picture p137: CAD file, 2022-06-14]
MVP_02/SHOPPING_LISTS/LASERBEEST/20-019500--COVER A--Rev_A.step
320.0 x 100.0 x 5.00 mm
