Vitrotem/vitronotion/MVP_02/SHOPPING_LISTS/SUPE/20-019410--HOUSING CONNECTION A--Rev_A.step

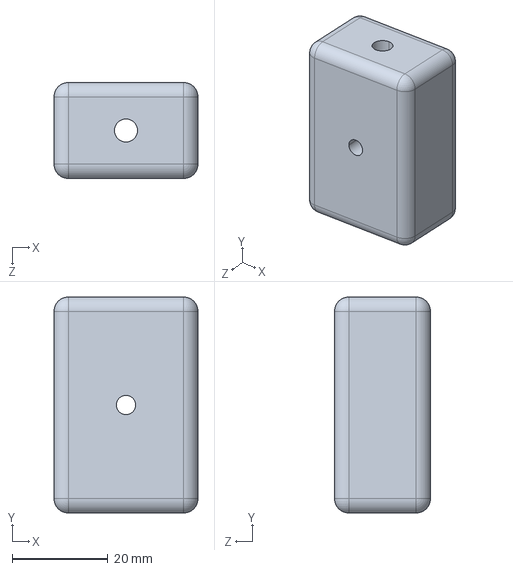
[picture p138: CAD file, 2022-06-14]
MVP_02/SHOPPING_LISTS/SUPE/20-019410--HOUSING CONNECTION A--Rev_A.step
30.0 x 45.0 x 20.0 mm
