Vitrotem/vitronotion/MVP/SHOPPING_LISTS/LASERBEEST/13-018746.step

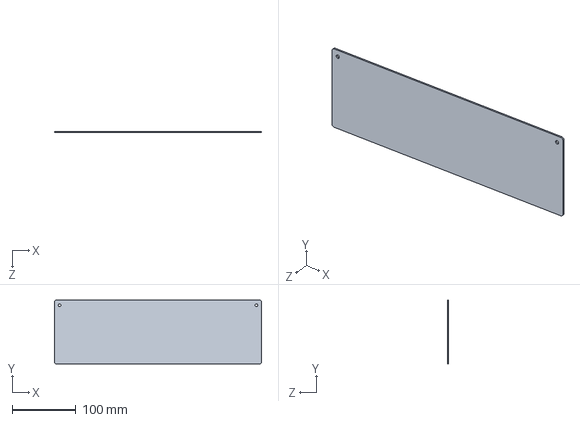
[picture p139: CAD file, 2022-03-07]
MVP/SHOPPING_LISTS/LASERBEEST/13-018746.step
324.0 x 100.0 x 2.00 mm
