Vitrotem/vitronotion/MVP_02/SHOPPING_LISTS/LASERBEEST/20-019407--BACK COVER--Rev_A.step

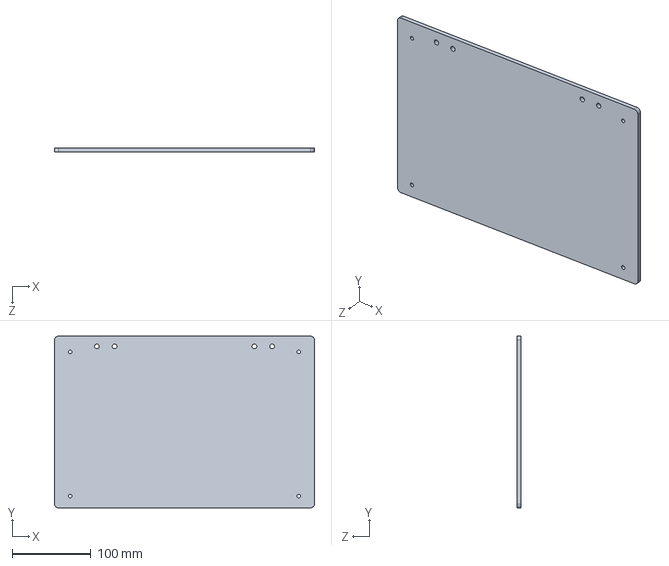
[picture p140: CAD file, 2022-06-14]
MVP_02/SHOPPING_LISTS/LASERBEEST/20-019407--BACK COVER--Rev_A.step
330.0 x 218.0 x 5.00 mm
