Vitrotem/vitronotion/MVP_02/SHOPPING_LISTS/SUPE/20-019460--HOUSING CONNECTION B--Rev_A.step

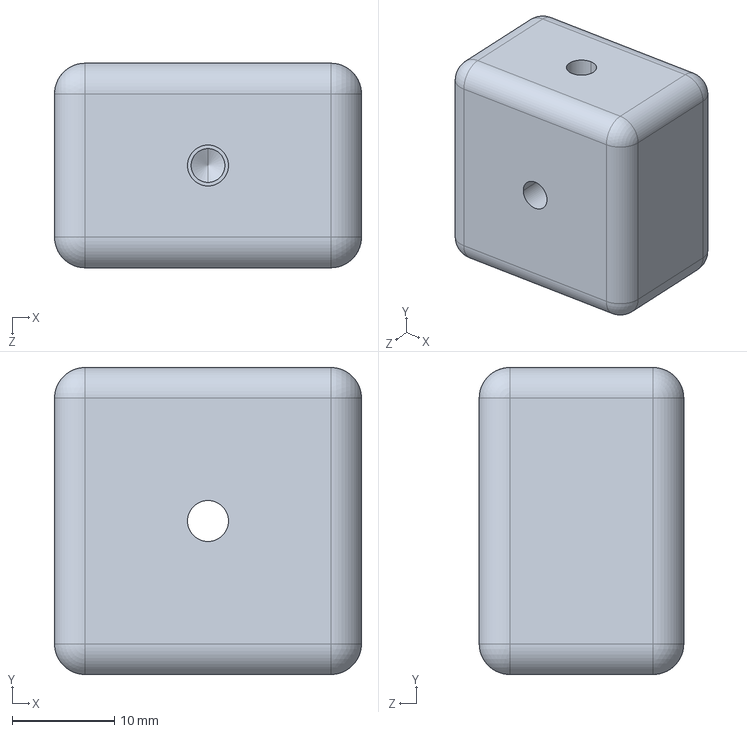
[picture p141: CAD file, 2022-06-14]
MVP_02/SHOPPING_LISTS/SUPE/20-019460--HOUSING CONNECTION B--Rev_A.step
30.0 x 30.0 x 20.0 mm
