Vitrotem/vitronotion/MVP/SHOPPING_LISTS/SUPE/13-018266.step

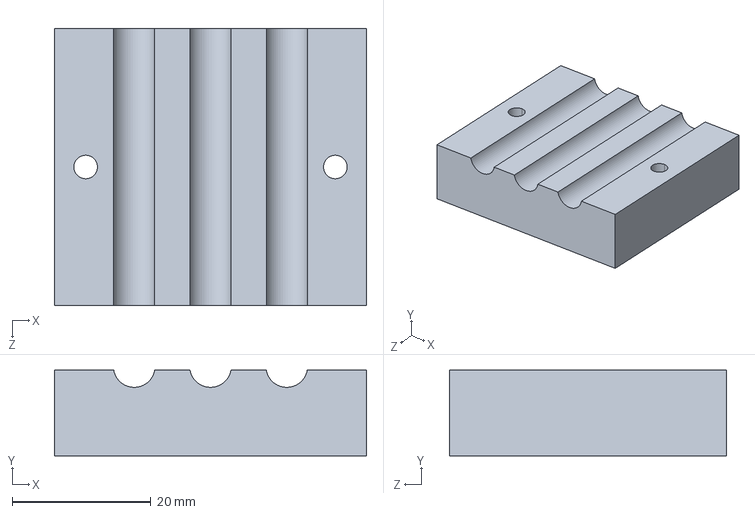
[picture p142: CAD file, 2022-03-07]
MVP/SHOPPING_LISTS/SUPE/13-018266.step
45.0 x 12.4 x 40.0 mm
