Vitrotem/vitronotion/MVP_02/SHOPPING_LISTS/LASERBEEST/20-019408--SIDE COVER A--Rev_A.step

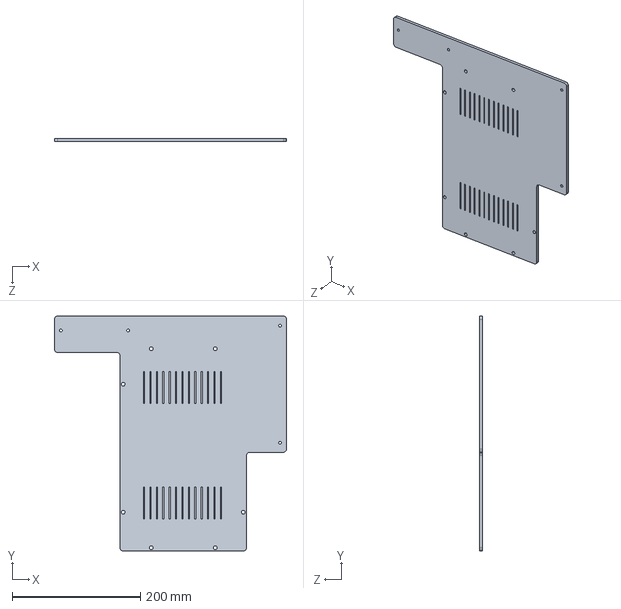
[picture p143: CAD file, 2022-06-14]
MVP_02/SHOPPING_LISTS/LASERBEEST/20-019408--SIDE COVER A--Rev_A.step
362.5 x 367.0 x 5.00 mm
