Vitrotem/vitronotion/MVP/SHOPPING_LISTS/LASERBEEST/13-018747.step

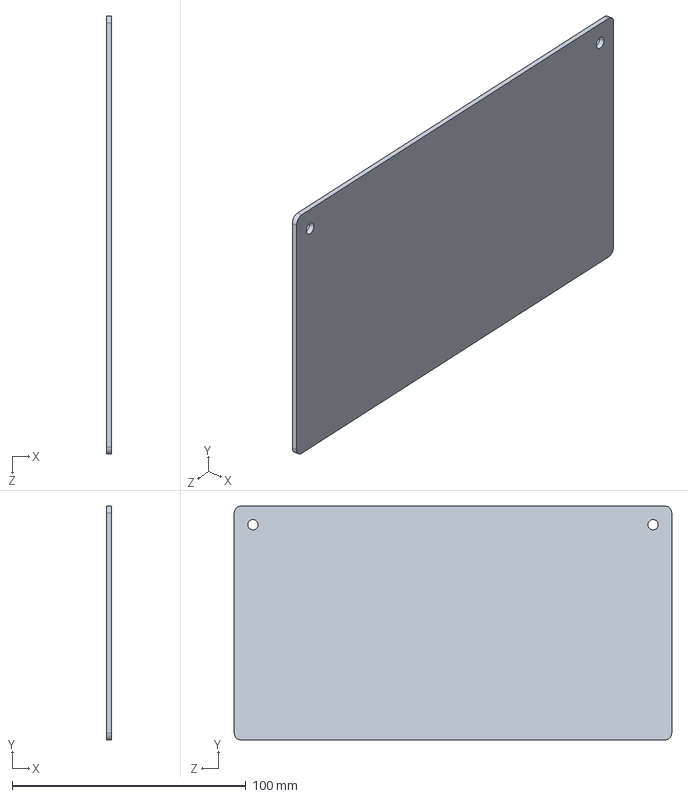
[picture p144: CAD file, 2022-03-07]
MVP/SHOPPING_LISTS/LASERBEEST/13-018747.step
2.00 x 100.0 x 187.0 mm
