Vitrotem/vitronotion/MVP/SHOPPING_LISTS/SUPE/13-018272.step

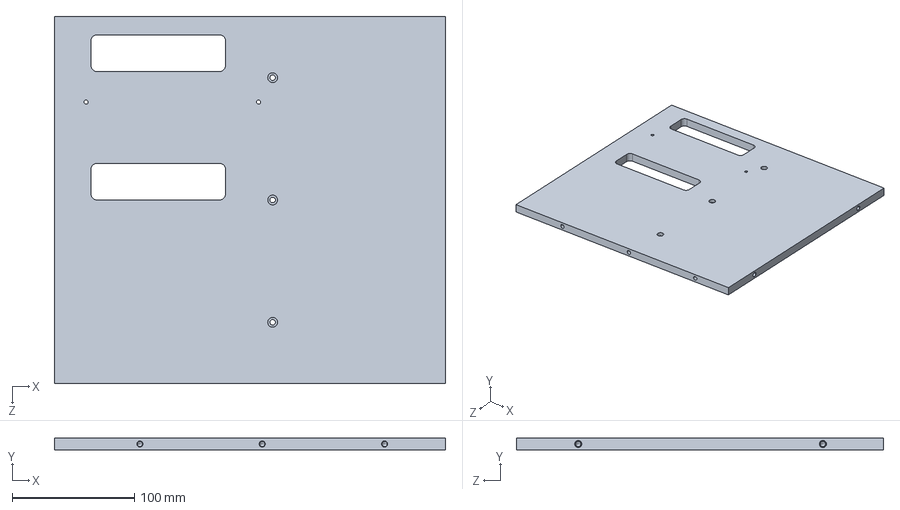
[picture p145: CAD file, 2022-03-07]
MVP/SHOPPING_LISTS/SUPE/13-018272.step
320.0 x 10.0 x 300.0 mm
