Vitrotem/vitronotion/MVP_02/SHOPPING_LISTS/LASERBEEST/20-019462--SIDE COVER B--Rev_A.step

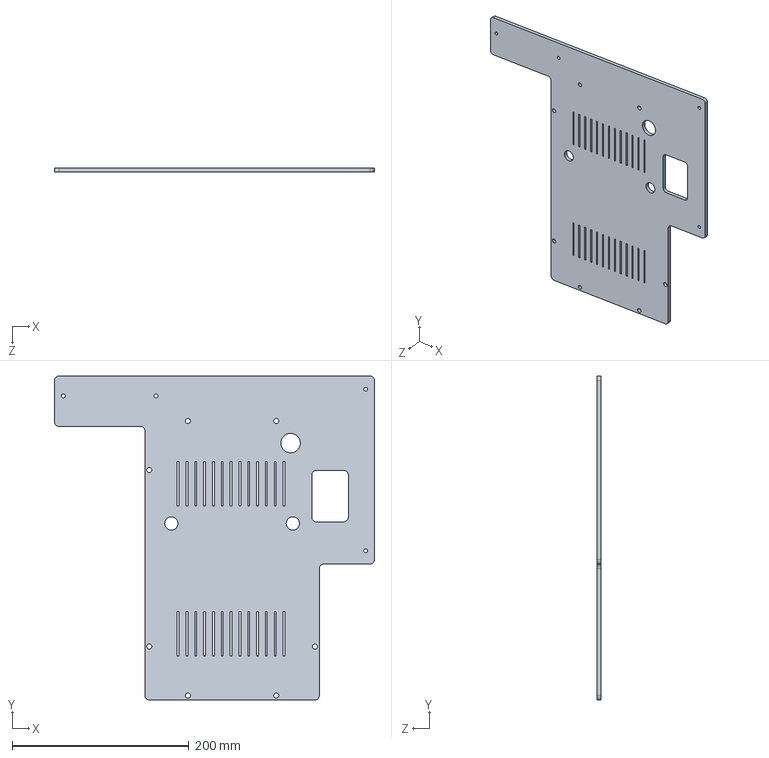
[picture p146: CAD file, 2022-06-14]
MVP_02/SHOPPING_LISTS/LASERBEEST/20-019462--SIDE COVER B--Rev_A.step
362.5 x 367.0 x 5.00 mm
