Vitrotem/vitronotion/MVP_02/SHOPPING_LISTS/SUPE/20-019385--HEATPIPE CLAMP A--Rev_A.step

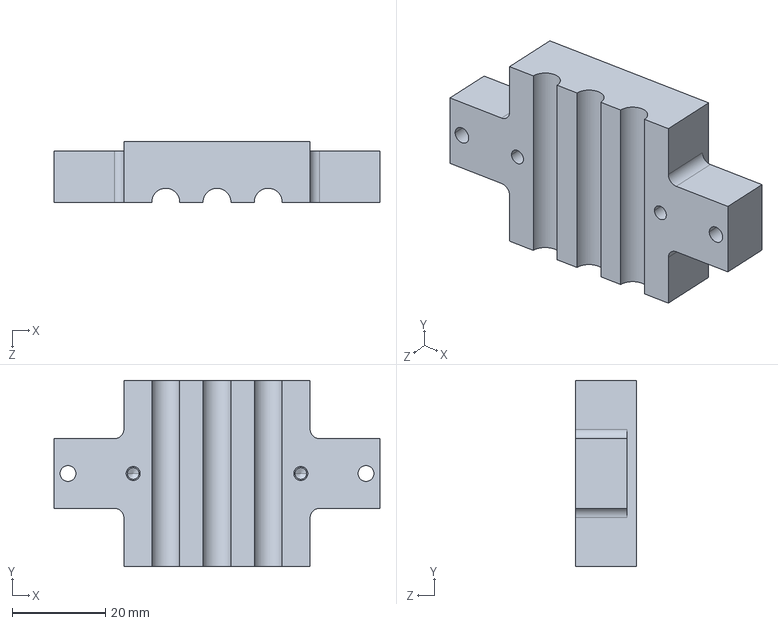
[picture p147: CAD file, 2022-06-14]
MVP_02/SHOPPING_LISTS/SUPE/20-019385--HEATPIPE CLAMP A--Rev_A.step
70.0 x 40.0 x 13.0 mm
