Vitrotem/vitronotion/MVP/SHOPPING_LISTS/LASERBEEST/13-018293.step

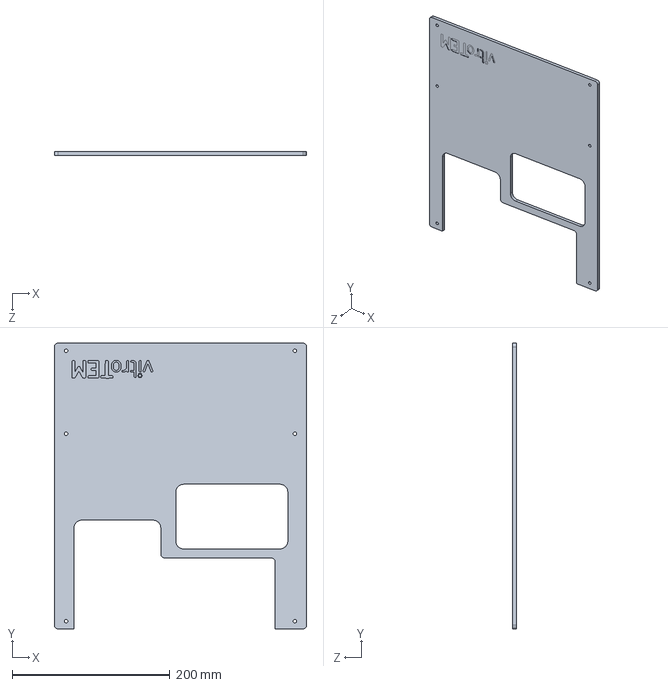
[picture p148: CAD file, 2022-03-07]
MVP/SHOPPING_LISTS/LASERBEEST/13-018293.step
320.0 x 362.5 x 5.00 mm
