Vitrotem/vitronotion/MVP_02/SHOPPING_LISTS/LASERBEEST/20-019468--FRONT COVER--Rev_A.step

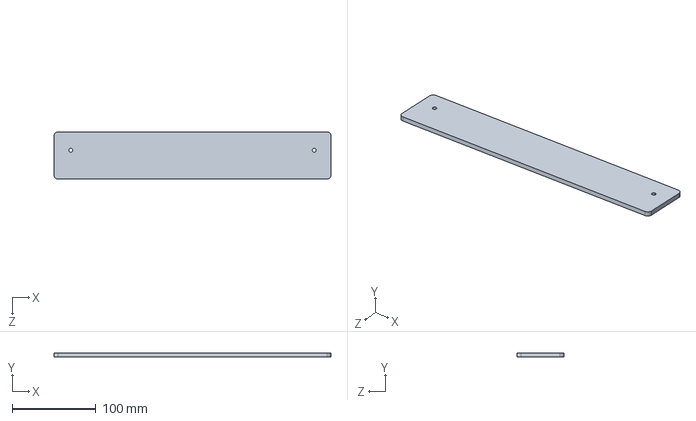
[picture p149: CAD file, 2022-06-14]
MVP_02/SHOPPING_LISTS/LASERBEEST/20-019468--FRONT COVER--Rev_A.step
330.0 x 5.00 x 56.5 mm
