Vitrotem/vitronotion/MVP_02/SHOPPING_LISTS/SUPE/20-019396--LEFT BRACE CONNECTOR--Rev_A.step

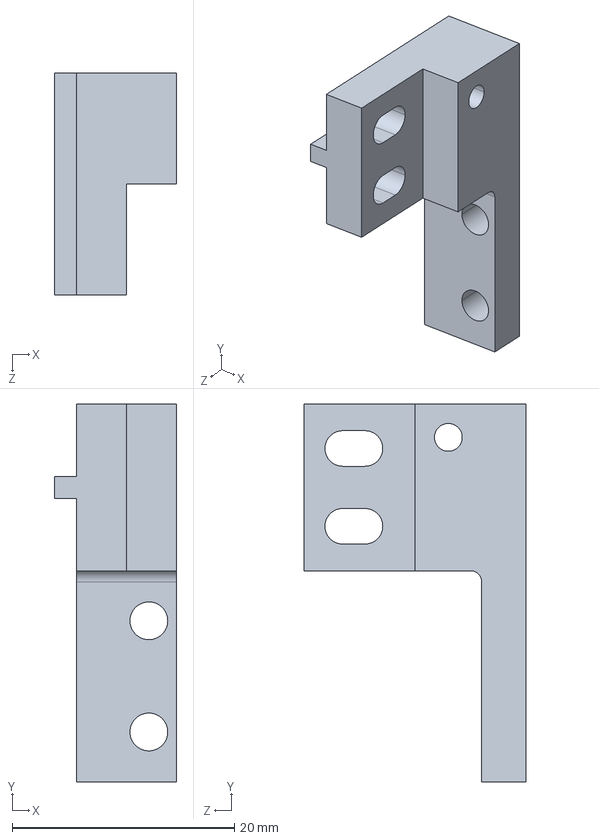
[picture p150: CAD file, 2022-06-14]
MVP_02/SHOPPING_LISTS/SUPE/20-019396--LEFT BRACE CONNECTOR--Rev_A.step
11.0 x 34.0 x 20.0 mm
