Vitrotem/vitronotion/MVP/SHOPPING_LISTS/SUPE/13-018314.step

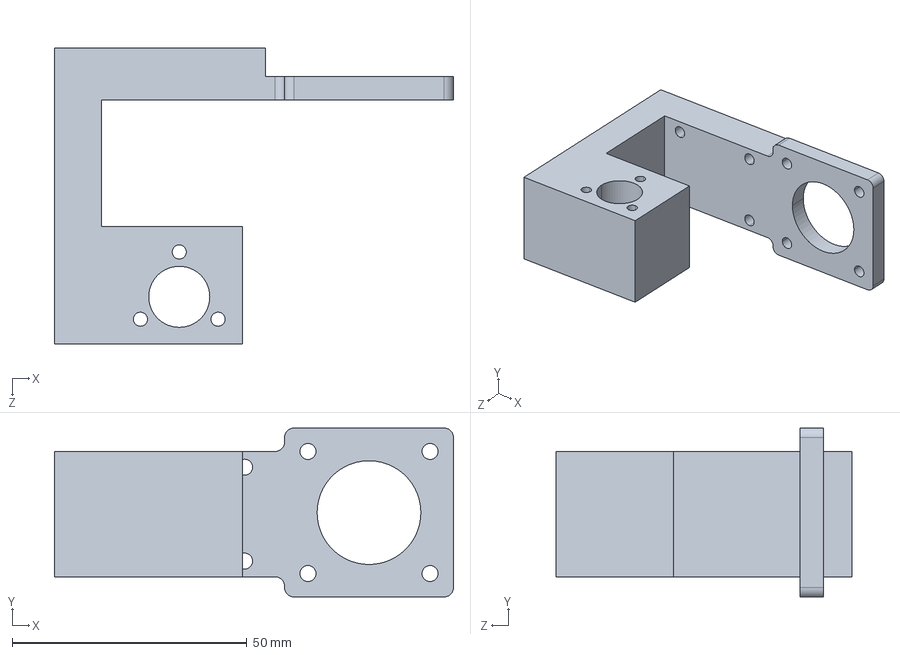
[picture p151: CAD file, 2022-03-07]
MVP/SHOPPING_LISTS/SUPE/13-018314.step
85.0 x 36.0 x 63.0 mm
