Vitrotem/vitronotion/MVP_02/SHOPPING_LISTS/LASERBEEST/20-019501--COVER B--Rev_A.step

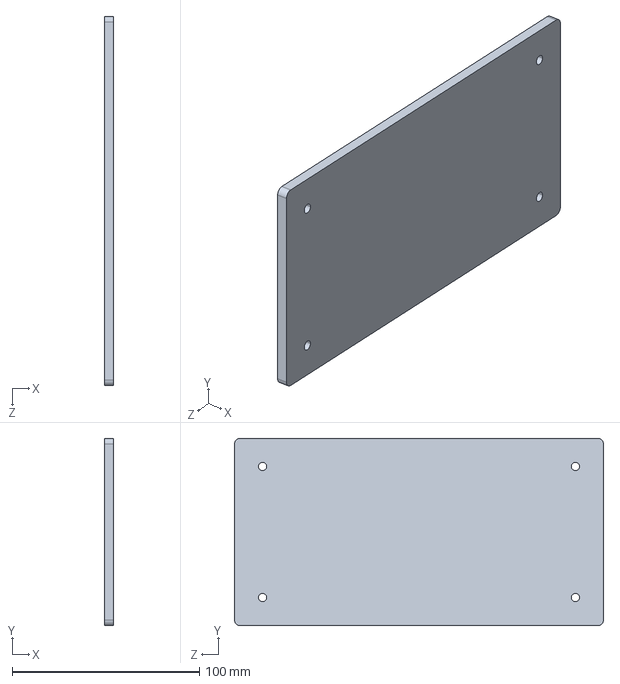
[picture p152: CAD file, 2022-06-14]
MVP_02/SHOPPING_LISTS/LASERBEEST/20-019501--COVER B--Rev_A.step
5.00 x 100.0 x 197.0 mm
