Vitrotem/vitronotion/MVP_02/SHOPPING_LISTS/SUPE/20-019383--HORIZONTAL MOTOR PLATE--Rev_A.step

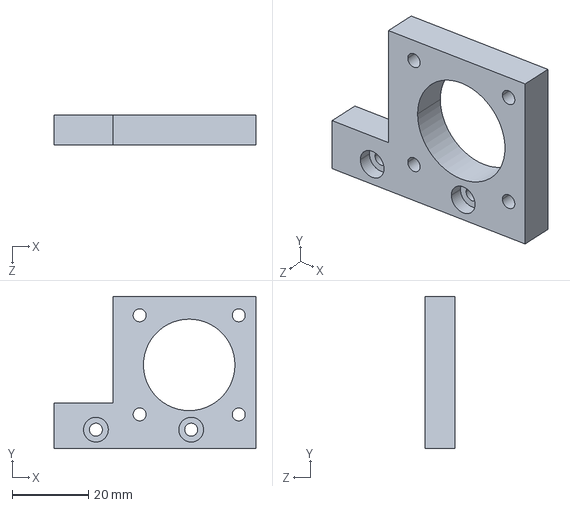
[picture p153: CAD file, 2022-06-14]
MVP_02/SHOPPING_LISTS/SUPE/20-019383--HORIZONTAL MOTOR PLATE--Rev_A.step
53.0 x 40.0 x 8.00 mm
