Vitrotem/vitronotion/MVP/SHOPPING_LISTS/SUPE/13-018242.step

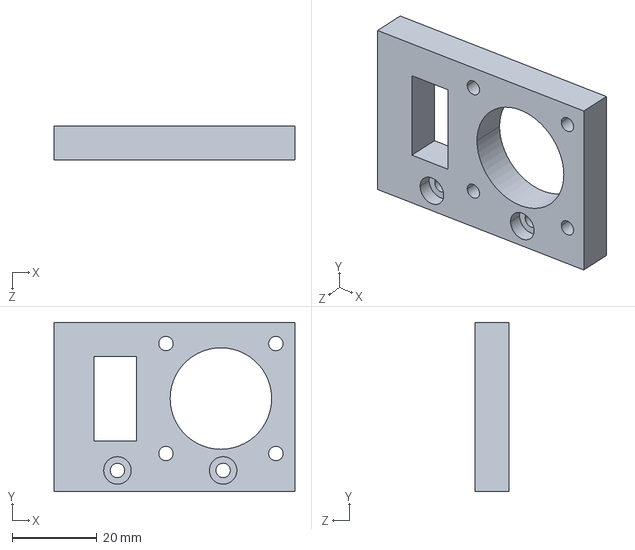
[picture p154: CAD file, 2022-03-07]
MVP/SHOPPING_LISTS/SUPE/13-018242.step
57.0 x 40.0 x 8.00 mm
