Vitrotem/vitronotion/MVP_02/SHOPPING_LISTS/SUPE/20-019482--PATCH PANEL FOR PSU--Rev_A.step

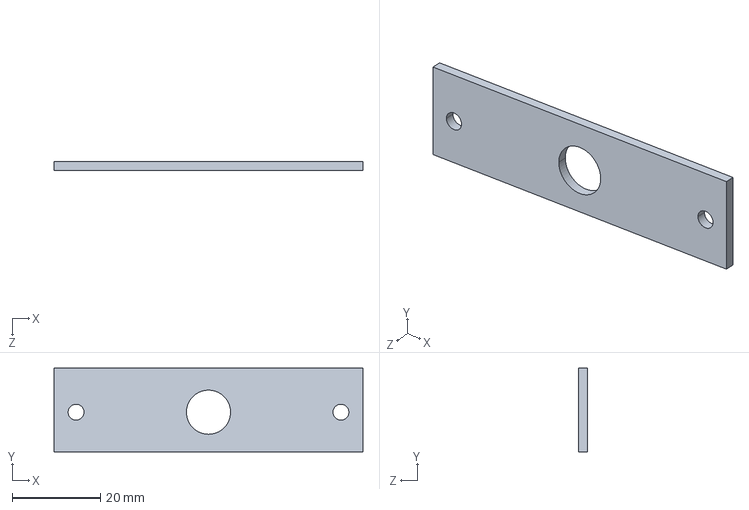
[picture p155: CAD file, 2022-06-14]
MVP_02/SHOPPING_LISTS/SUPE/20-019482--PATCH PANEL FOR PSU--Rev_A.step
70.0 x 19.0 x 2.00 mm
