Vitrotem/vitronotion/MVP/SHOPPING_LISTS/SUPE/13-018292.step

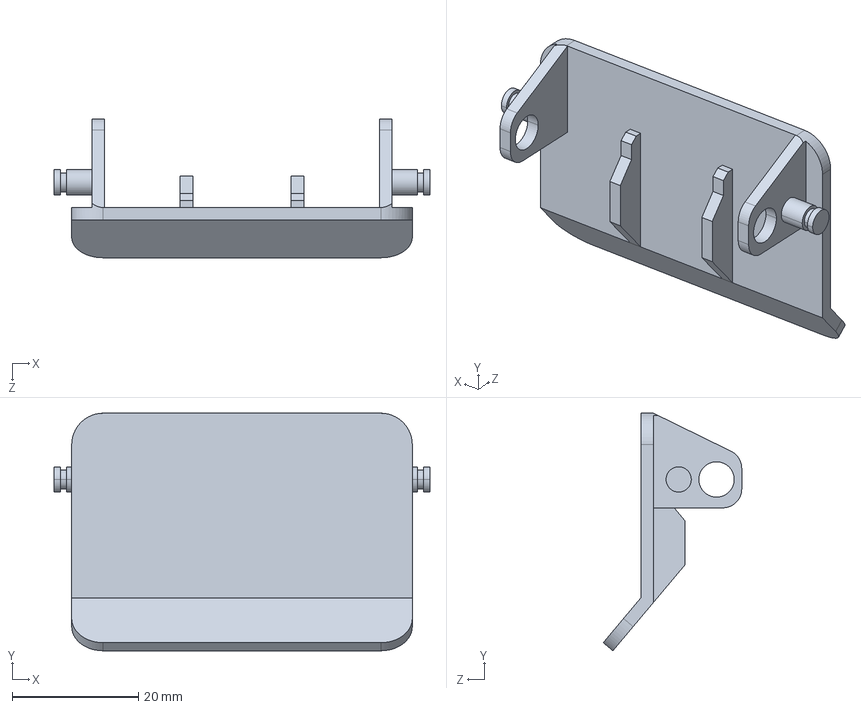
[picture p156: CAD file, 2022-03-07]
MVP/SHOPPING_LISTS/SUPE/13-018292.step
59.6 x 37.7 x 22.0 mm
