Vitrotem/vitronotion/MVP_02/SHOPPING_LISTS/SUPE/20-019379--CARTRIDGE LANDING LID--Rev_A.step

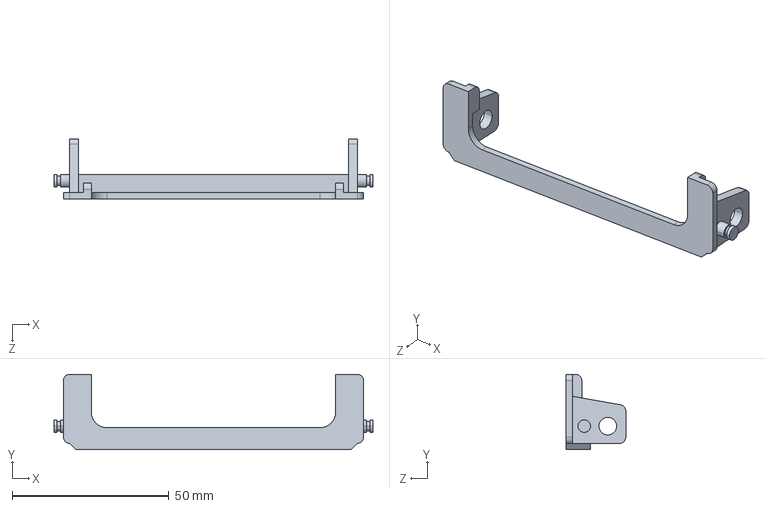
[picture p157: CAD file, 2022-06-14]
MVP_02/SHOPPING_LISTS/SUPE/20-019379--CARTRIDGE LANDING LID--Rev_A.step
101.6 x 24.0 x 19.0 mm
