Vitrotem/vitronotion/MVP_02/SHOPPING_LISTS/SUPE/20-019391--DIVIDER PLATE B--Rev_A.step

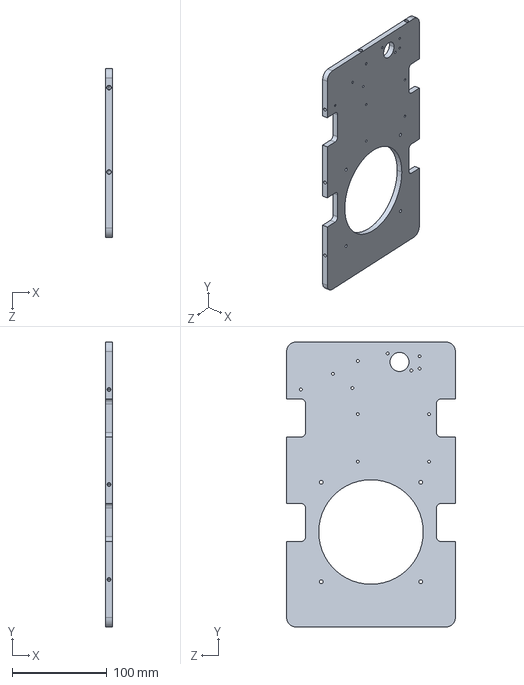
[picture p159: CAD file, 2022-06-14]
MVP_02/SHOPPING_LISTS/SUPE/20-019391--DIVIDER PLATE B--Rev_A.step
7.00 x 300.0 x 177.7 mm
