Vitrotem/vitronotion/MVP/SHOPPING_LISTS/SUPE/13-018289.step

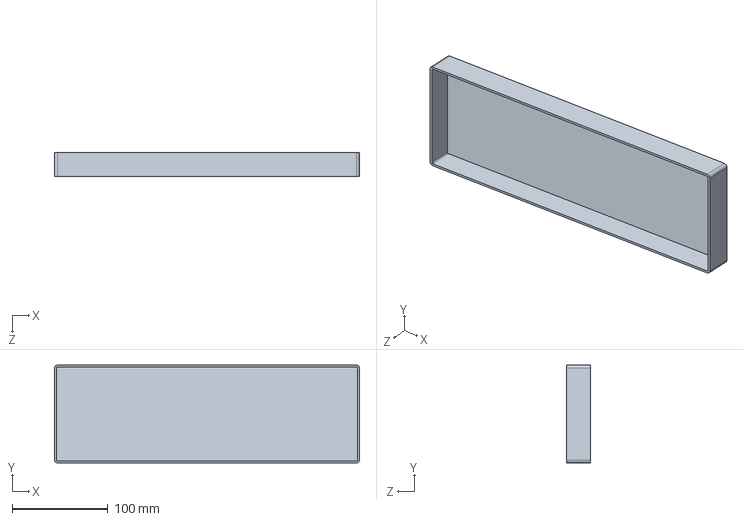
[picture p160: CAD file, 2022-03-07]
MVP/SHOPPING_LISTS/SUPE/13-018289.step
318.0 x 102.0 x 25.0 mm
