Vitrotem/vitronotion/MVP_02/SHOPPING_LISTS/SUPE/20-019400--ACTUATOR BRACKET--Rev_A.step

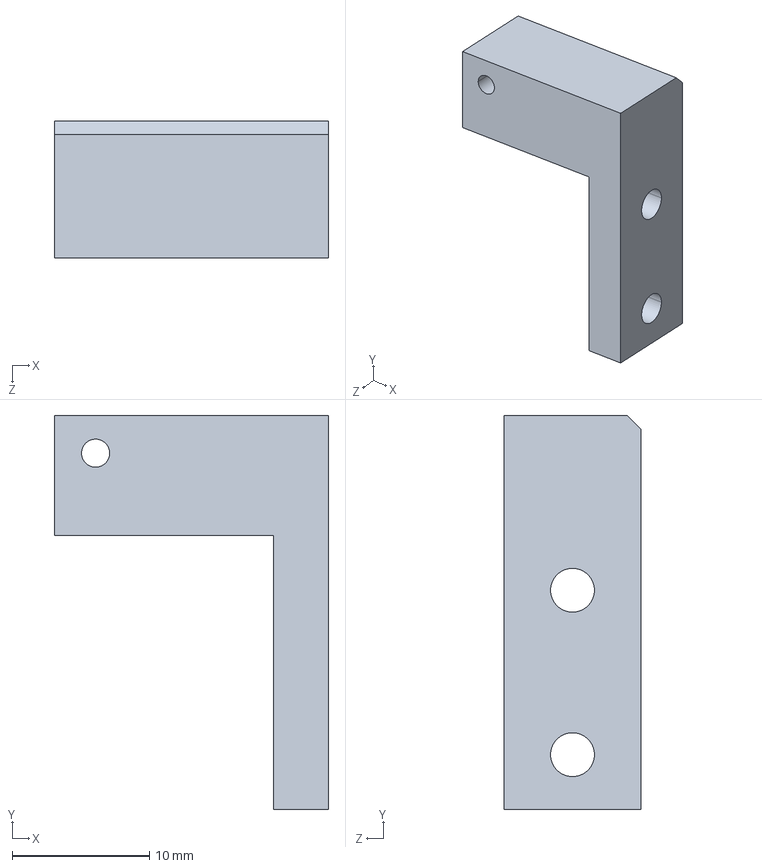
[picture p161: CAD file, 2022-06-14]
MVP_02/SHOPPING_LISTS/SUPE/20-019400--ACTUATOR BRACKET--Rev_A.step
20.0 x 28.8 x 10.0 mm
