Vitrotem/vitronotion/MVP_02/SHOPPING_LISTS/SUPE/20-019402--BOTTOM TRAY B--Rev_A.step

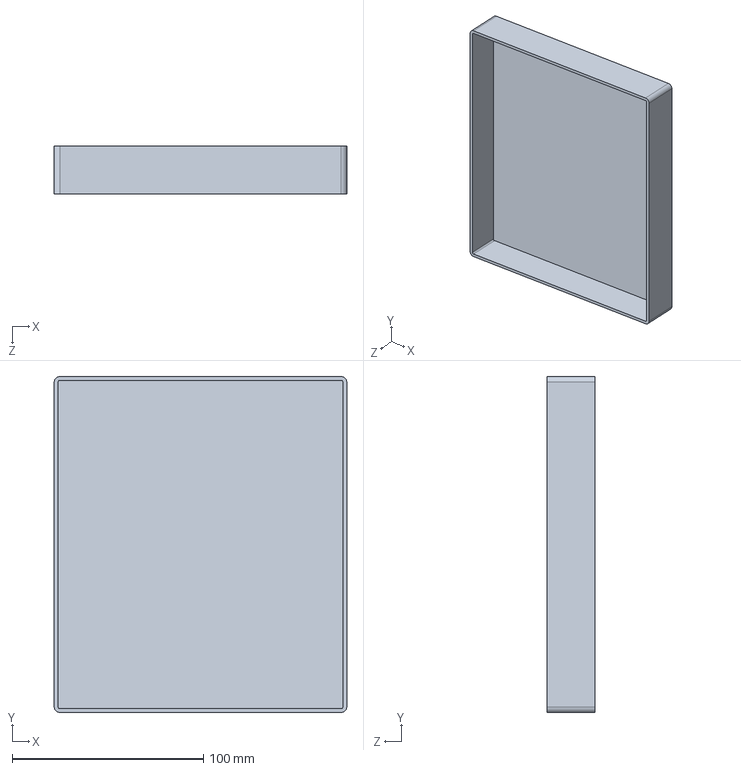
[picture p162: CAD file, 2022-06-14]
MVP_02/SHOPPING_LISTS/SUPE/20-019402--BOTTOM TRAY B--Rev_A.step
153.0 x 175.7 x 25.0 mm
