Vitrotem/vitronotion/MVP/SHOPPING_LISTS/SUPE/13-018313.step

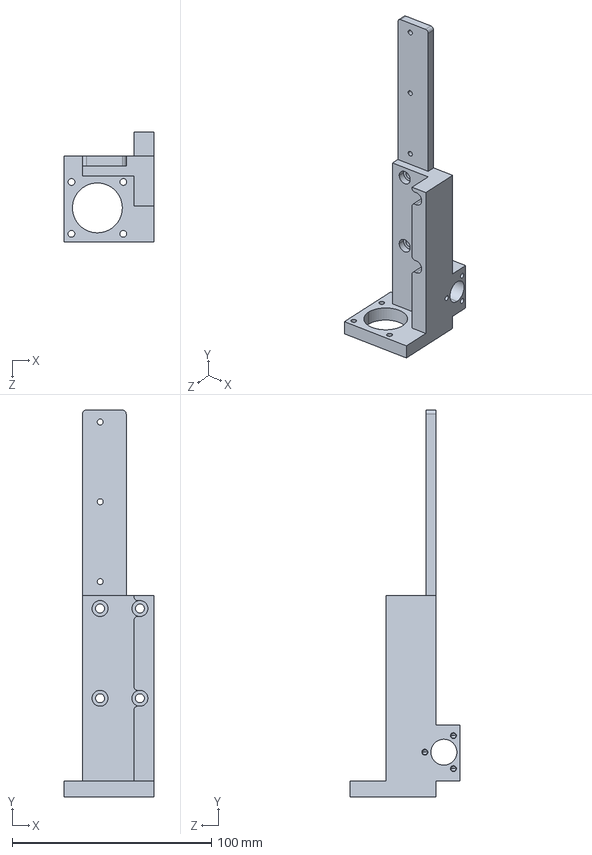
[picture p164: CAD file, 2022-03-07]
MVP/SHOPPING_LISTS/SUPE/13-018313.step
45.0 x 194.0 x 55.0 mm
