Vitrotem/vitronotion/MVP/SHOPPING_LISTS/SUPE/13-018446.step

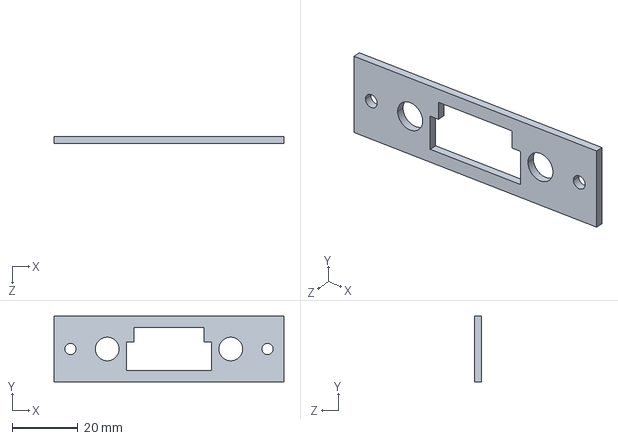
[picture p165: CAD file, 2022-03-07]
MVP/SHOPPING_LISTS/SUPE/13-018446.step
70.0 x 20.0 x 2.00 mm
