Vitrotem/vitronotion/MVP_02/SHOPPING_LISTS/LASERBEEST/20-019462.step

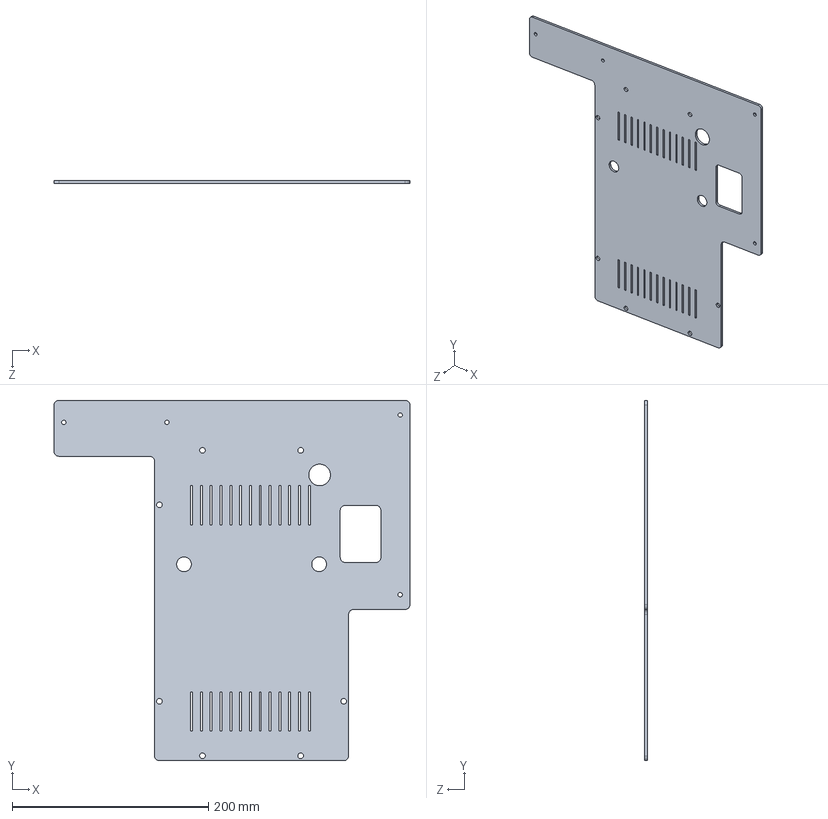
[picture p166: CAD file, 2022-04-21]
MVP_02/SHOPPING_LISTS/LASERBEEST/20-019462.step
362.5 x 367.0 x 3.00 mm
