Vitrotem/vitronotion/MVP/SHOPPING_LISTS/SUPE/13-018287.step

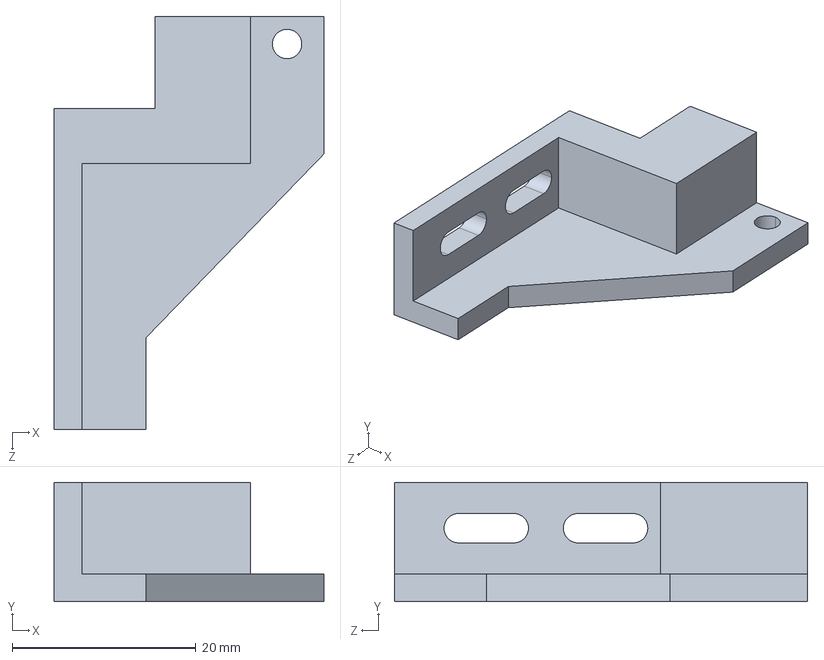
[picture p167: CAD file, 2022-03-07]
MVP/SHOPPING_LISTS/SUPE/13-018287.step
29.4 x 13.0 x 45.0 mm
