Vitrotem/vitronotion/MVP_02/SHOPPING_LISTS/SUPE/20-019471--COPPER JACKET--Rev_A.step

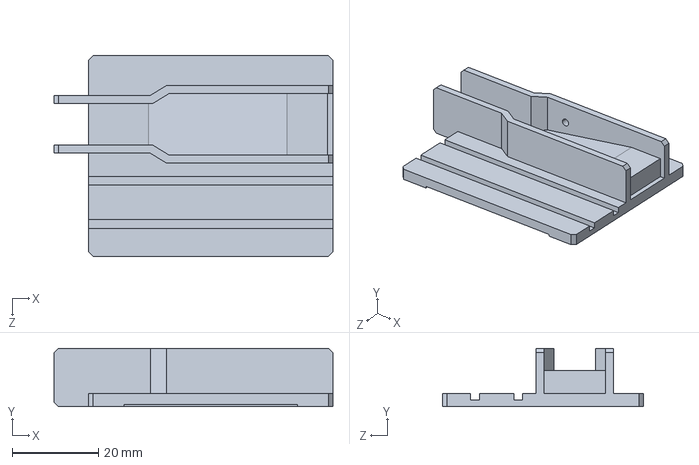
[picture p168: CAD file, 2022-06-14]
MVP_02/SHOPPING_LISTS/SUPE/20-019471--COPPER JACKET--Rev_A.step
64.7 x 13.5 x 46.5 mm
