Vitrotem/vitronotion/MVP_02/SHOPPING_LISTS/SUPE/20-019526--LOOP HOLDER INTERFACE--Rev_B.step

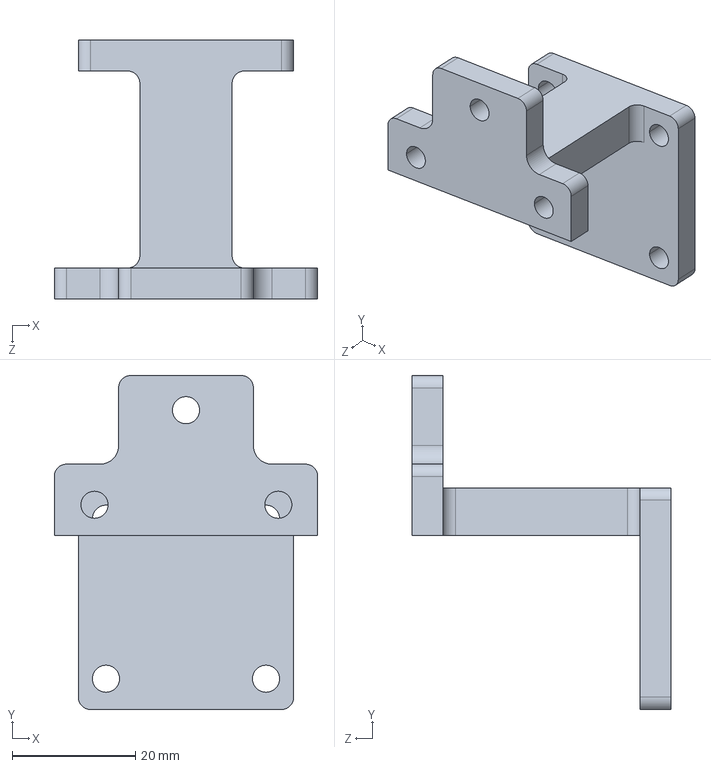
[picture p169: CAD file, 2022-06-14]
MVP_02/SHOPPING_LISTS/SUPE/20-019526--LOOP HOLDER INTERFACE--Rev_B.step
42.8 x 54.3 x 42.0 mm
