Vitrotem/vitronotion/MVP/SHOPPING_LISTS/SUPE/13-018240.step

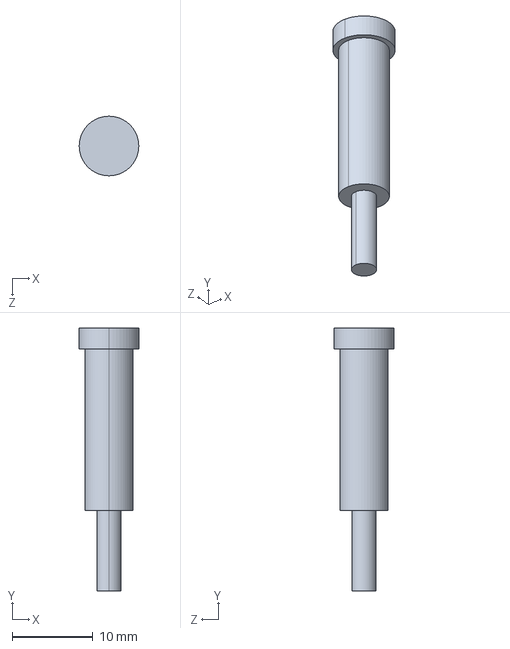
[picture p170: CAD file, 2022-03-07]
MVP/SHOPPING_LISTS/SUPE/13-018240.step
7.38 x 32.6 x 7.38 mm
