Vitrotem/vitronotion/MVP_02/SHOPPING_LISTS/SUPE/20-019378--SET BLOCK--Rev_A.step

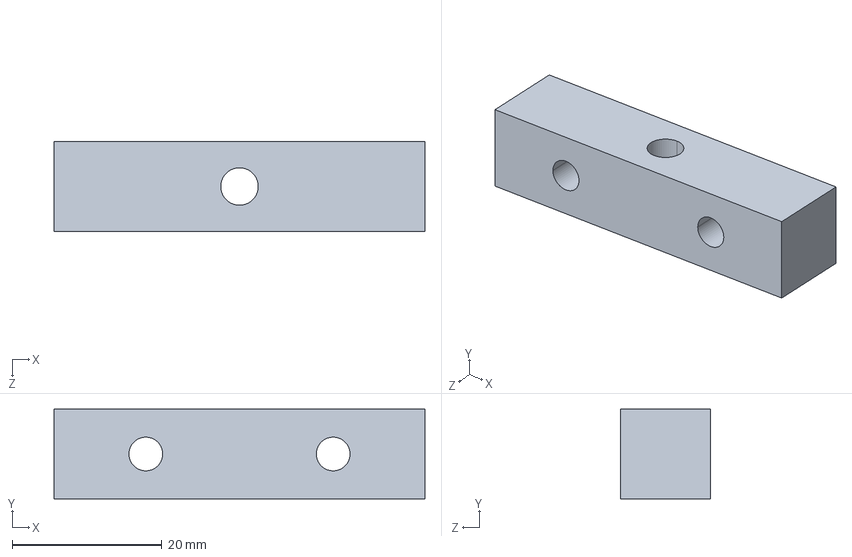
[picture p171: CAD file, 2022-06-14]
MVP_02/SHOPPING_LISTS/SUPE/20-019378--SET BLOCK--Rev_A.step
49.5 x 12.0 x 12.0 mm
