Vitrotem/vitronotion/MVP_02/SHOPPING_LISTS/SUPE/20-019393--FLOWCELL COVER BRACKET--Rev_A.step

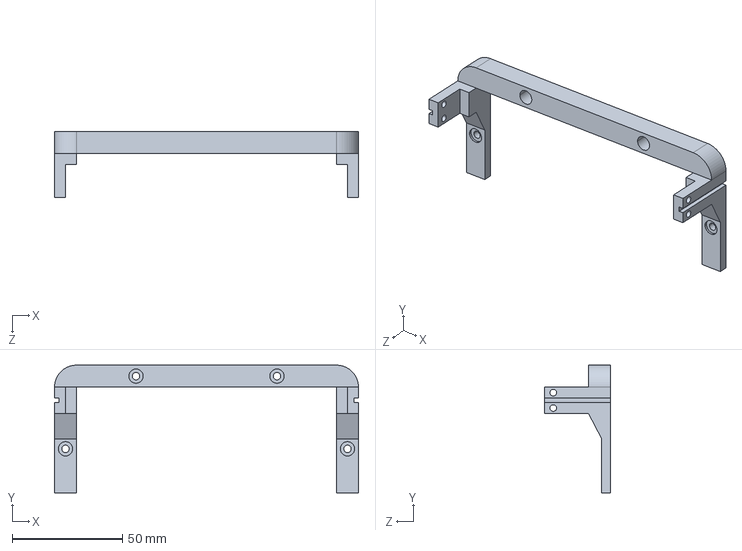
[picture p172: CAD file, 2022-06-14]
MVP_02/SHOPPING_LISTS/SUPE/20-019393--FLOWCELL COVER BRACKET--Rev_A.step
138.0 x 58.0 x 30.0 mm
