Vitrotem/vitronotion/MVP/SHOPPING_LISTS/SUPE/13-018233.step

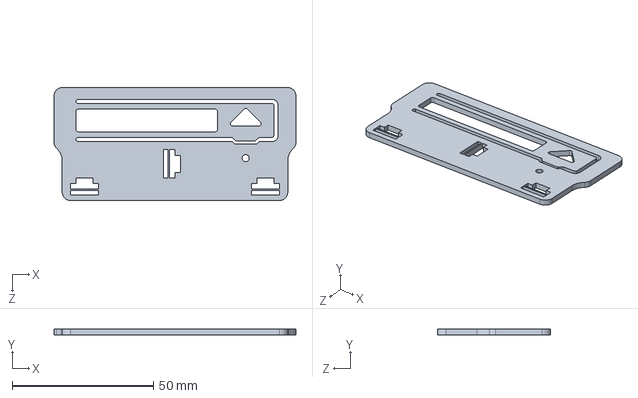
[picture p173: CAD file, 2022-03-07]
MVP/SHOPPING_LISTS/SUPE/13-018233.step
85.6 x 2.00 x 40.0 mm
