Vitrotem/vitronotion/MVP/SHOPPING_LISTS/SUPE/13-018235.step

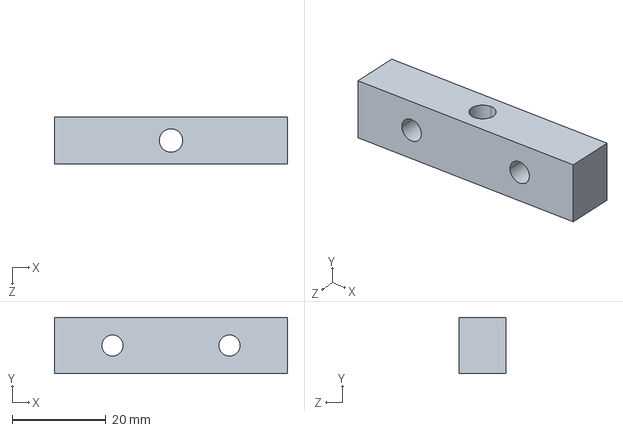
[picture p174: CAD file, 2022-03-07]
MVP/SHOPPING_LISTS/SUPE/13-018235.step
49.8 x 12.0 x 10.0 mm
