Vitrotem/vitronotion/MVP/SHOPPING_LISTS/SUPE/13-018220.step

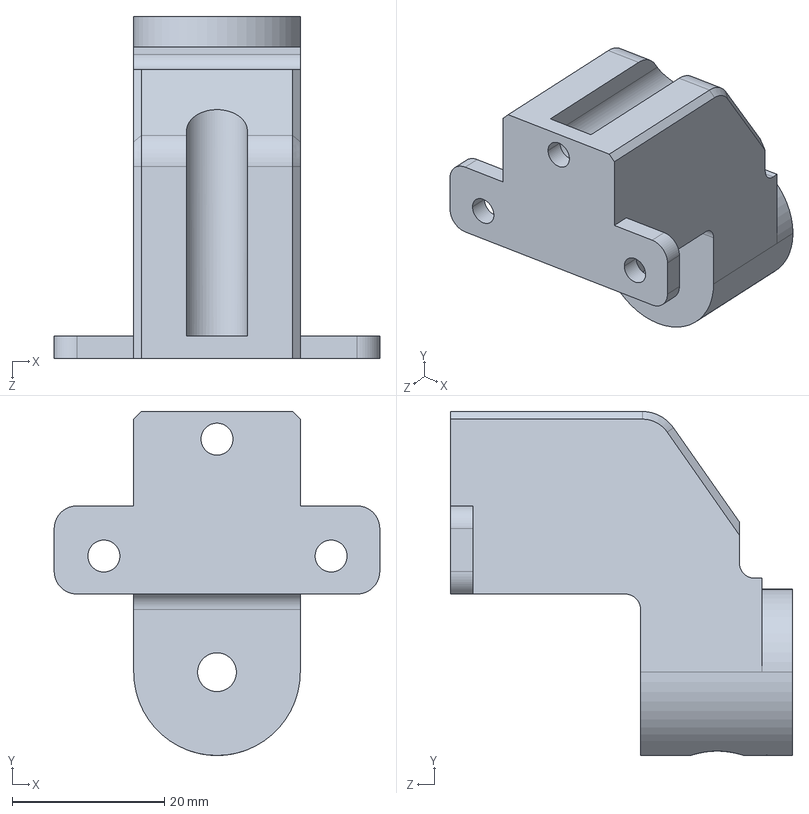
[picture p175: CAD file, 2022-03-07]
MVP/SHOPPING_LISTS/SUPE/13-018220.step
42.8 x 45.2 x 45.0 mm
