Vitrotem/vitronotion/MVP/SHOPPING_LISTS/SUPE/13-018410.step

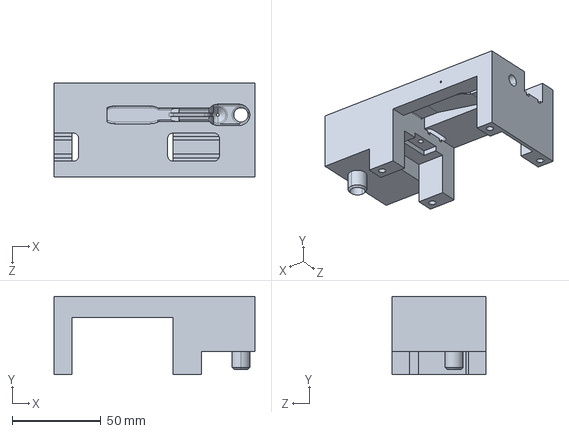
[picture p176: CAD file, 2022-03-07]
MVP/SHOPPING_LISTS/SUPE/13-018410.step
113.0 x 44.0 x 53.0 mm
