Vitrotem/vitronotion/MVP_02/SHOPPING_LISTS/SUPE/20-019421.step

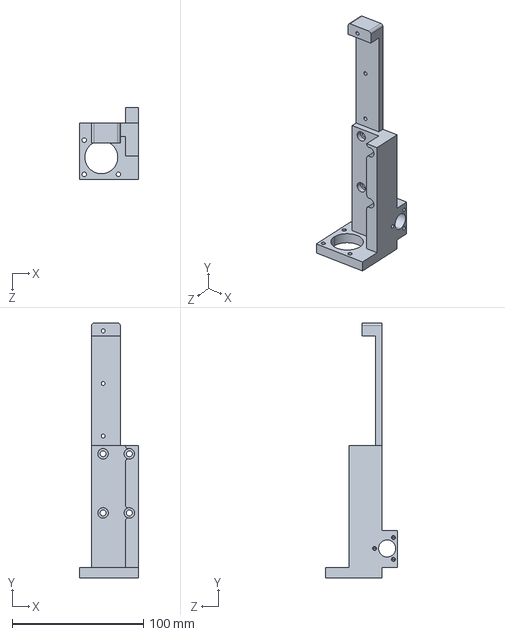
[picture p177: CAD file, 2022-04-21]
MVP_02/SHOPPING_LISTS/SUPE/20-019421.step
45.0 x 194.0 x 55.0 mm
