Vitrotem/vitronotion/MVP/SHOPPING_LISTS/SUPE/13-018270.step

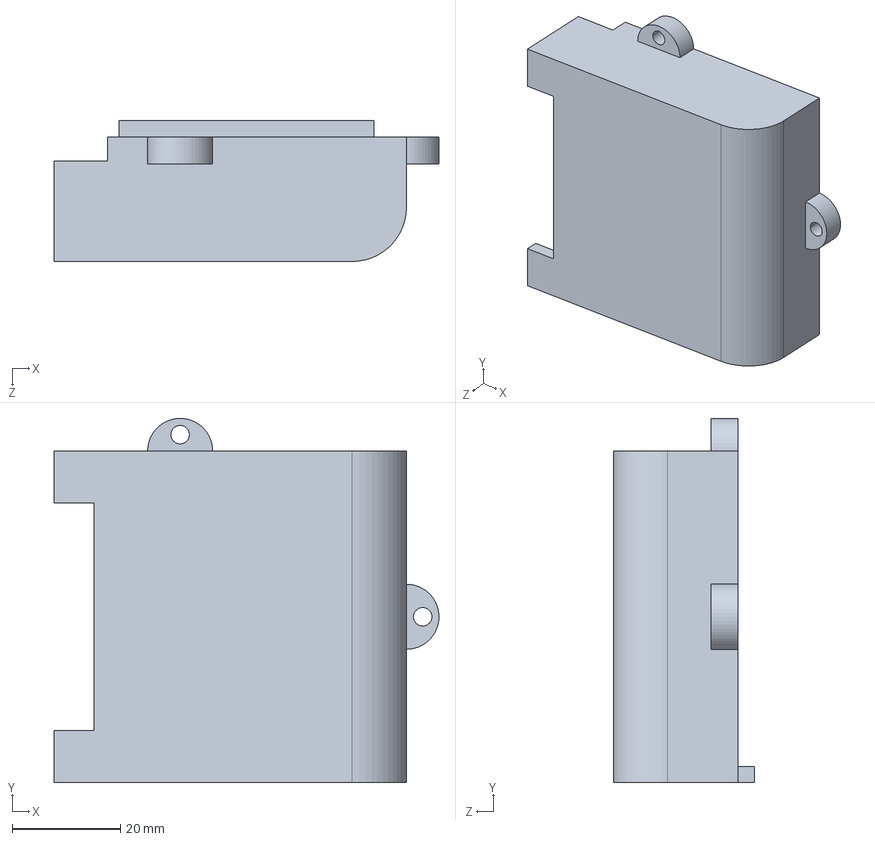
[picture p178: CAD file, 2022-02-23]
MVP/SHOPPING_LISTS/SUPE/13-018270.step
71.0 x 67.2 x 26.0 mm
