Vitrotem/vitronotion/MVP/SHOPPING_LISTS/SUPE/13-018267.step

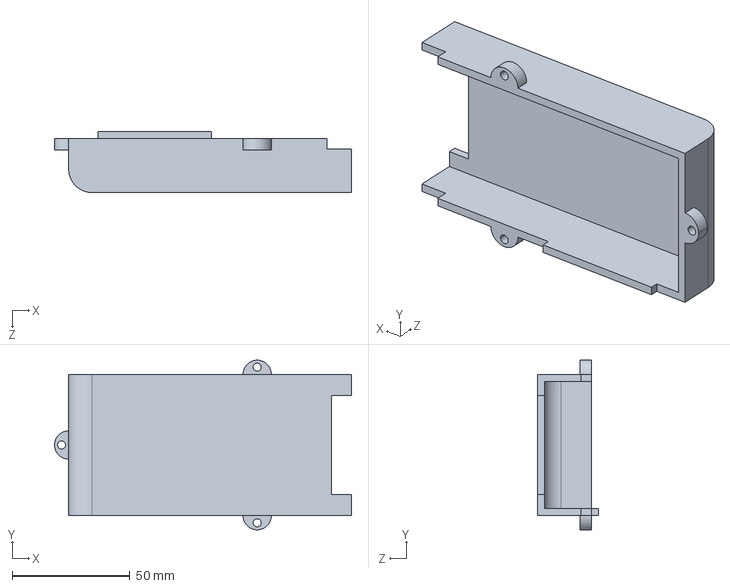
[picture p179: CAD file, 2022-02-23]
MVP/SHOPPING_LISTS/SUPE/13-018267.step
126.0 x 72.0 x 26.0 mm
