Vitrotem/vitronotion/(list of files, cad)

Other CAD files:
MVP_02/SHOPPING_LISTS/PRECISION MICRO/20-019371--PRECISION MICRO 4--Rev_A.step
MVP_02/SHOPPING_LISTS/TAMESON/20-019507.step
MVP_02/SHOPPING_LISTS/PRECISION MICRO/20-019371.step
MVP_02/SHOPPING_LISTS/LASERBEEST/20-019370--CARTRIDGE--Rev_A.step
MVP_02/SHOPPING_LISTS/QUICKCOOL/20-019388.step
MVP/SHOPPING_LISTS/SUPE/13-018234.step
MVP/SHOPPING_LISTS/LASERBEEST/13-018295.step
MVP_02/SHOPPING_LISTS/SUPE/20-019399--VALVE PLATE--Rev_A.step
MVP/SHOPPING_LISTS/SUPE/13-018229.step
MVP_02/SHOPPING_LISTS/SUPE/20-019390--DIVIDER PLATE A--Rev_A.step
MVP/SHOPPING_LISTS/SUPE/13-018207.step
MVP_02/SHOPPING_LISTS/LASERBEEST/20-019529--COVER D--Rev_A.step
MVP_02/SHOPPING_LISTS/LASERBEEST/20-019502.step
MVP_02/SHOPPING_LISTS/LASERBEEST/20-019406.step
MVP_02/SHOPPING_LISTS/LASERBEEST/20-019468.step
MVP_02/SHOPPING_LISTS/LASERBEEST/20-019500.step
MVP/SHOPPING_LISTS/SUPE/13-018206.step
MVP_02/SHOPPING_LISTS/LASERBEEST/20-019501.step
MVP/SHOPPING_LISTS/SUPE/13-018286.step
MVP_02/SHOPPING_LISTS/LASERBEEST/20-019407.step
MVP_02/SHOPPING_LISTS/LASERBEEST/20-019408.step
MVP_02/SHOPPING_LISTS/SUPE/20-019363--BACK PLATE--Rev_A.step
MVP_02/SHOPPING_LISTS/SUPE/20-019375--CARTRIDGE PLATFORM--Rev_A.step
MVP_02/SHOPPING_LISTS/LASERBEEST/20-019370.step
MVP/SHOPPING_LISTS/SUPE/13-018278.step
MVP/SHOPPING_LISTS/SUPE/13-018288.step
MVP/SHOPPING_LISTS/SUPE/13-018279.step
MVP_02/SHOPPING_LISTS/SUPE/20-019401--CARTRIDGE BRACKET--Rev_A.step
MVP/SHOPPING_LISTS/SUPE/13-018265.step
MVP_02/SHOPPING_LISTS/SUPE/20-019403--BOTTOM TRAY A--Rev_A.step
MVP_02/SHOPPING_LISTS/SUPE/20-019387--HEATSINK--Rev_A.step
MVP/SHOPPING_LISTS/SUPE/13-018217.step
MVP_02/SHOPPING_LISTS/SUPE/20-019405--LOOP HOLDER CLIP--Rev_A.step
MVP/SHOPPING_LISTS/SUPE/13-018301.step
MVP_02/SHOPPING_LISTS/SUPE/20-019397--RIGHT BRACE CONNECTOR--Rev_A.step
MVP/SHOPPING_LISTS/SUPE/13-018275.step
MVP_02/SHOPPING_LISTS/SUPE/20-019386--HEATPIPE CLAMP B--Rev_A.step
MVP_02/SHOPPING_LISTS/SUPE/20-019373--BOTTOM PLATE--Rev_A.step
MVP_02/SHOPPING_LISTS/SUPE/20-019392--HEATSINK CLAMP--Rev_A.step
MVP/SHOPPING_LISTS/SUPE/13-018425.step
MVP_02/SHOPPING_LISTS/SUPE/20-019376--GRID HOLDER--Rev_A.step
MVP_02/SHOPPING_LISTS/SUPE/20-019469--FLOWCELL--Rev_A.step
MVP/SHOPPING_LISTS/SUPE/13-018273.step
MVP_02/SHOPPING_LISTS/SUPE/20-019362.step
MVP/SHOPPING_LISTS/SUPE/13-018271.step
MVP_02/SHOPPING_LISTS/SUPE/20-019386.step
MVP/SHOPPING_LISTS/SUPE/13-018309.step
MVP_02/SHOPPING_LISTS/SUPE/20-019422.step
MVP_02/SHOPPING_LISTS/SUPE/20-019378.step
MVP_02/SHOPPING_LISTS/SUPE/20-019391.step
MVP_02/SHOPPING_LISTS/SUPE/20-019379.step
MVP_02/SHOPPING_LISTS/SUPE/20-019469.step
MVP_02/SHOPPING_LISTS/SUPE/20-019383.step
MVP_02/SHOPPING_LISTS/SUPE/20-019397.step
MVP_02/SHOPPING_LISTS/SUPE/20-019482.step
MVP_02/SHOPPING_LISTS/SUPE/20-019387.step
MVP_02/SHOPPING_LISTS/SUPE/20-019369.step
MVP_02/SHOPPING_LISTS/SUPE/20-019385.step
MVP_02/SHOPPING_LISTS/SUPE/20-019374.step
MVP_02/SHOPPING_LISTS/SUPE/20-019377.step
MVP_02/SHOPPING_LISTS/SUPE/20-019460.step
MVP_02/SHOPPING_LISTS/SUPE/20-019400.step
MVP_02/SHOPPING_LISTS/SUPE/20-019471.step
MVP_02/SHOPPING_LISTS/SUPE/20-019401.step
MVP_02/SHOPPING_LISTS/SUPE/20-019410.step
MVP_02/SHOPPING_LISTS/SUPE/20-019402.step
MVP_02/SHOPPING_LISTS/SUPE/20-019392.step
MVP_02/SHOPPING_LISTS/SUPE/20-019375.step
MVP_02/SHOPPING_LISTS/SUPE/20-019373.step
MVP_02/SHOPPING_LISTS/SUPE/20-019405.step
MVP_02/SHOPPING_LISTS/SUPE/20-019363.step
MVP_02/SHOPPING_LISTS/SUPE/20-019396.step
MVP_02/SHOPPING_LISTS/SUPE/20-019389.step
MVP_02/SHOPPING_LISTS/SUPE/20-019376.step
MVP_02/SHOPPING_LISTS/SUPE/20-019372.step
MVP_02/SHOPPING_LISTS/SUPE/20-019403.step
MVP_02/SHOPPING_LISTS/SUPE/20-019393.step
MVP_02/SHOPPING_LISTS/SUPE/20-019399.step
MVP_02/SHOPPING_LISTS/SUPE/20-019390.step
MVP_02/SHOPPING_LISTS/LASERBEEST/20-019406.dxf
MVP_02/SHOPPING_LISTS/LASERBEEST/20-019407.dxf
MVP_02/SHOPPING_LISTS/LASERBEEST/20-019408.dxf
MVP_02/SHOPPING_LISTS/LASERBEEST/20-019462.dxf
MVP_02/SHOPPING_LISTS/LASERBEEST/20-019468.dxf
MVP_02/SHOPPING_LISTS/LASERBEEST/20-019500.dxf
MVP_02/SHOPPING_LISTS/LASERBEEST/20-019501.dxf
MVP_02/SHOPPING_LISTS/LASERBEEST/20-019502.dxf
MVP_02/SHOPPING_LISTS/QUICKCOOL/20-019388--HEATPIPE--Rev_A.step
