Vitrotem/vitronotion/MVP_02/SHOPPING_LISTS/LASERBEEST/20-019406.pdf

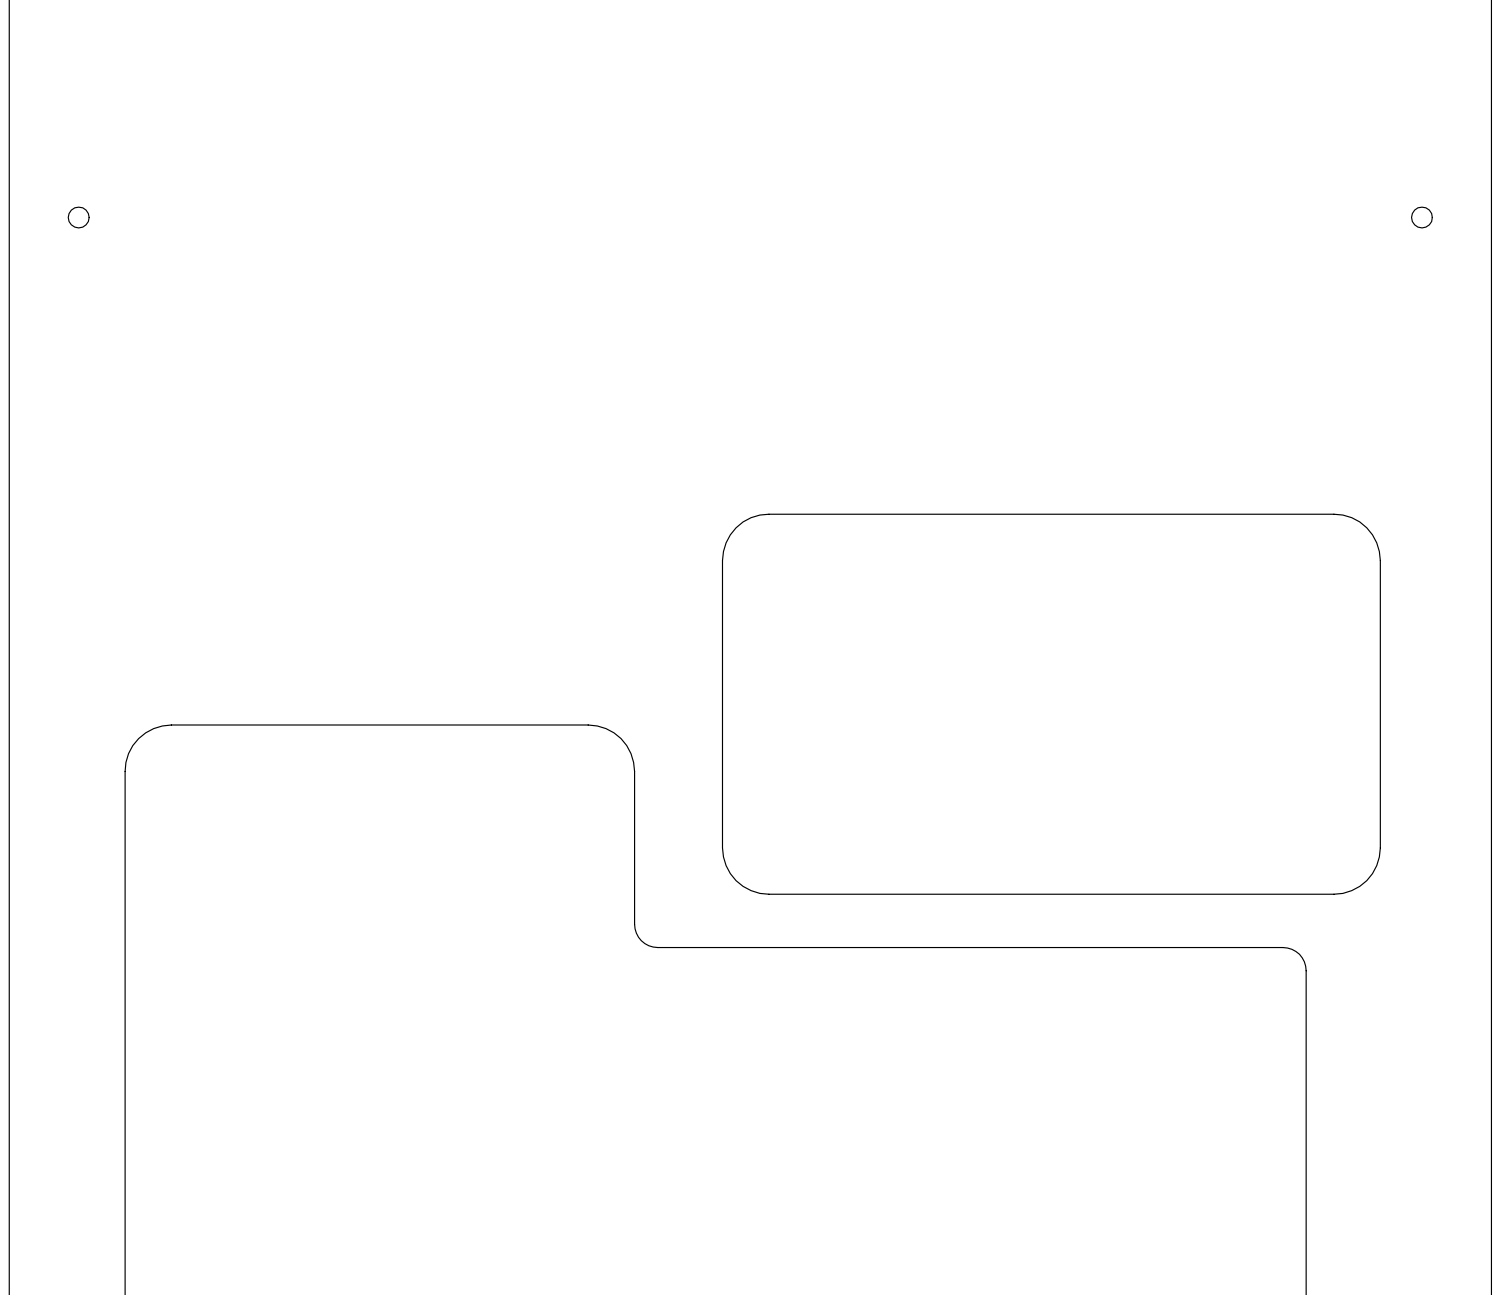
[picture p198: page 1]
