Vitrotem/vitronotion/MVP_02/SHOPPING_LISTS/LASERBEEST/20-019407.pdf

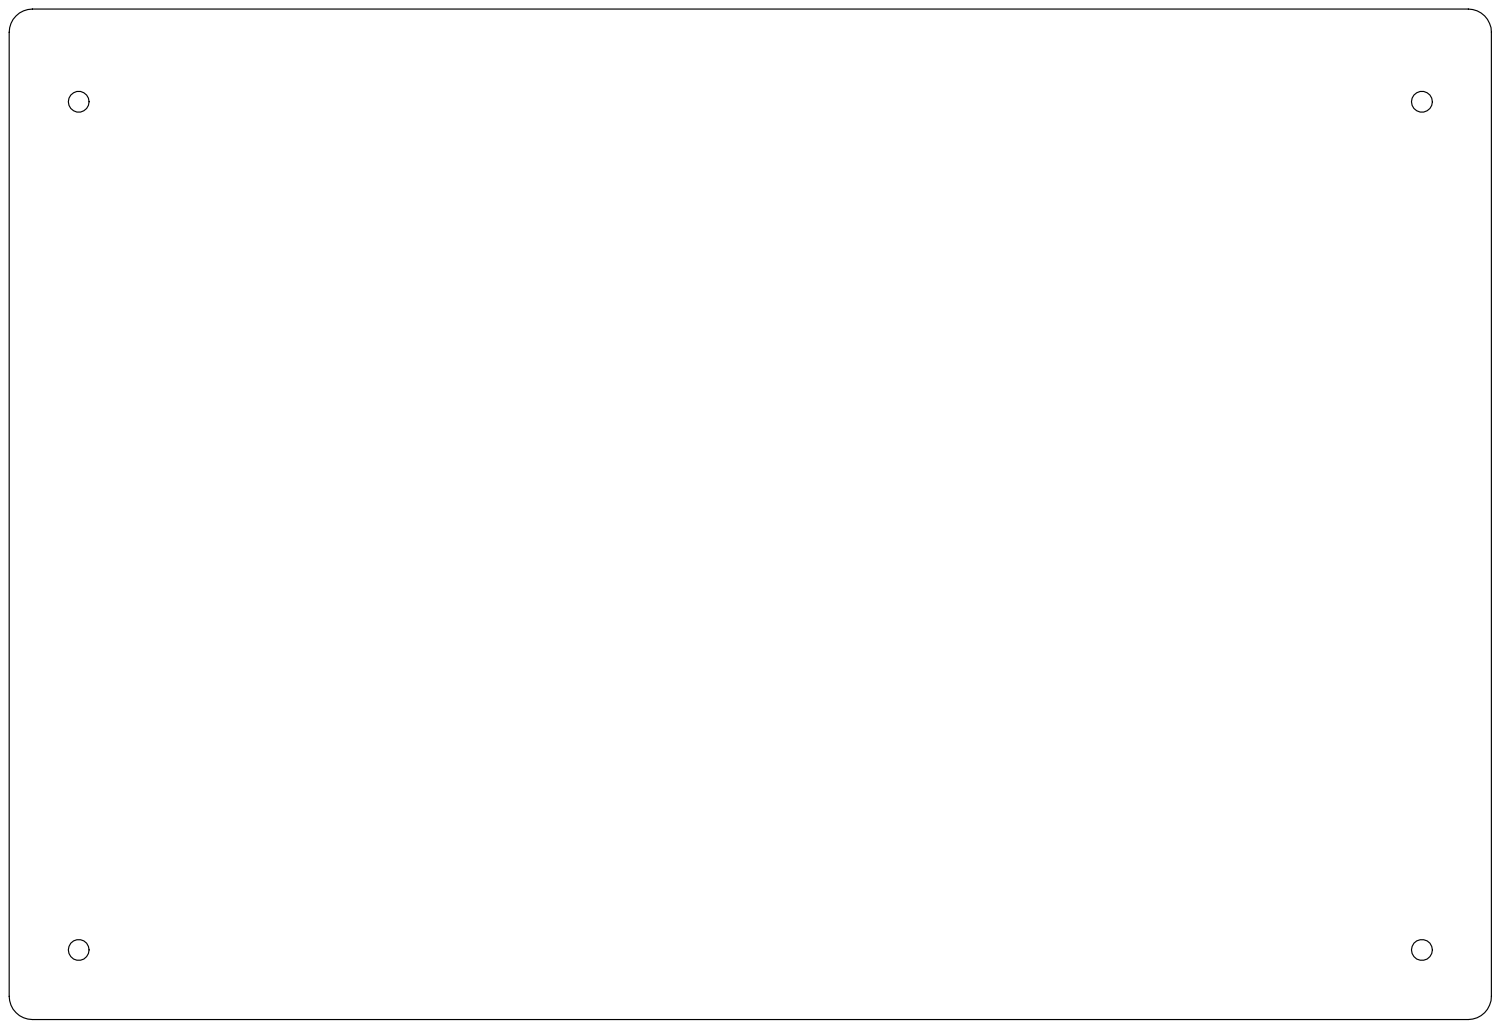
[picture p199: page 1]
