Vitrotem/vitronotion/MVP_02/SHOPPING_LISTS/LASERBEEST/20-019408.pdf

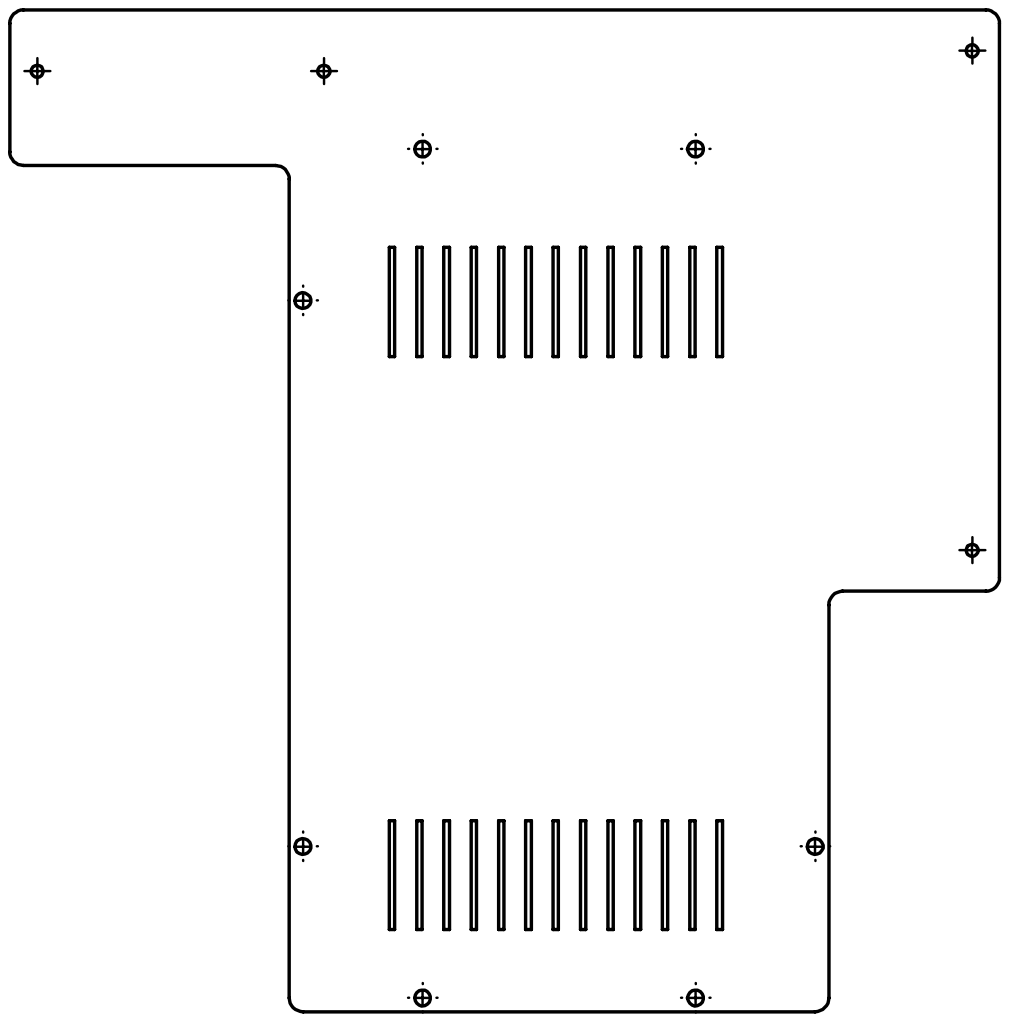
[picture p200: page 1]
