Vitrotem/vitronotion/MVP_02/SHOPPING_LISTS/LASERBEEST/20-019500.pdf

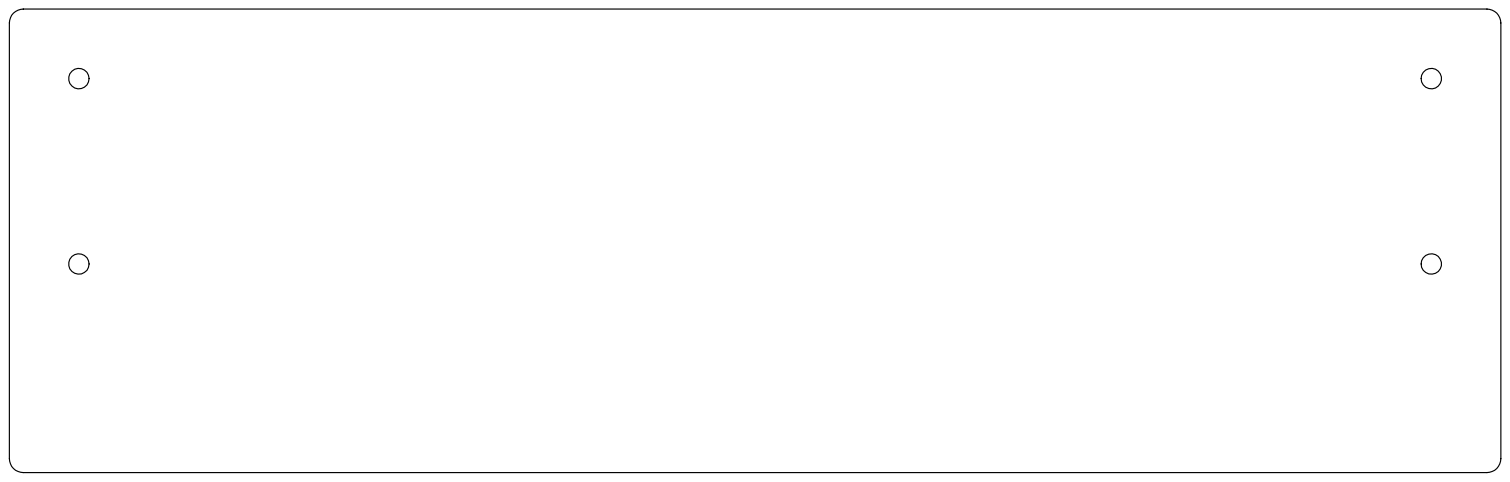
[picture p201: page 1]
