Vitrotem/vitronotion/MVP_02/SHOPPING_LISTS/LASERBEEST/20-019501.pdf

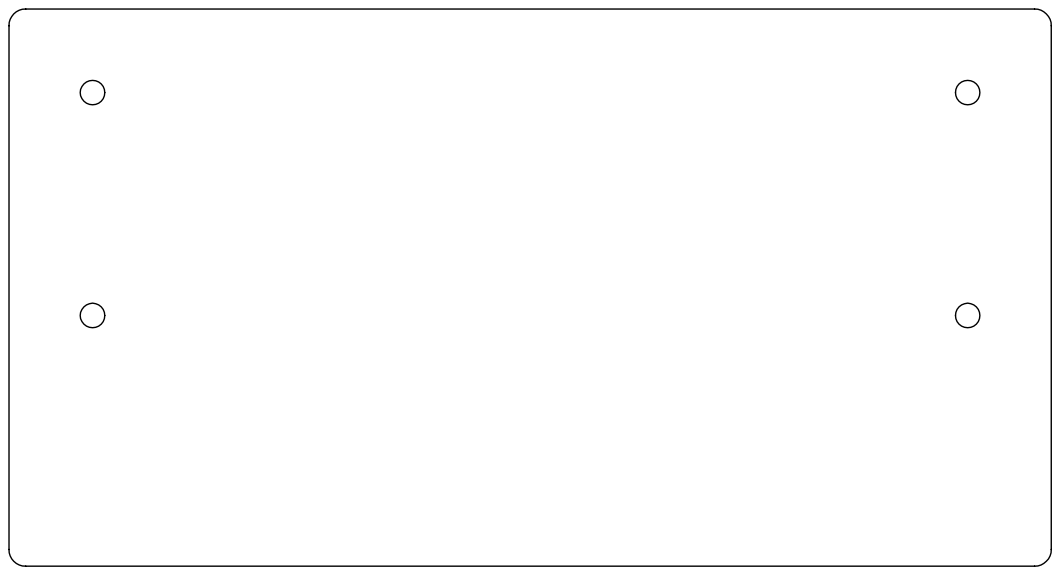
[picture p202: page 1]
