Vitrotem/vitronotion/MVP_02/SHOPPING_LISTS/LASERBEEST/20-019502.pdf

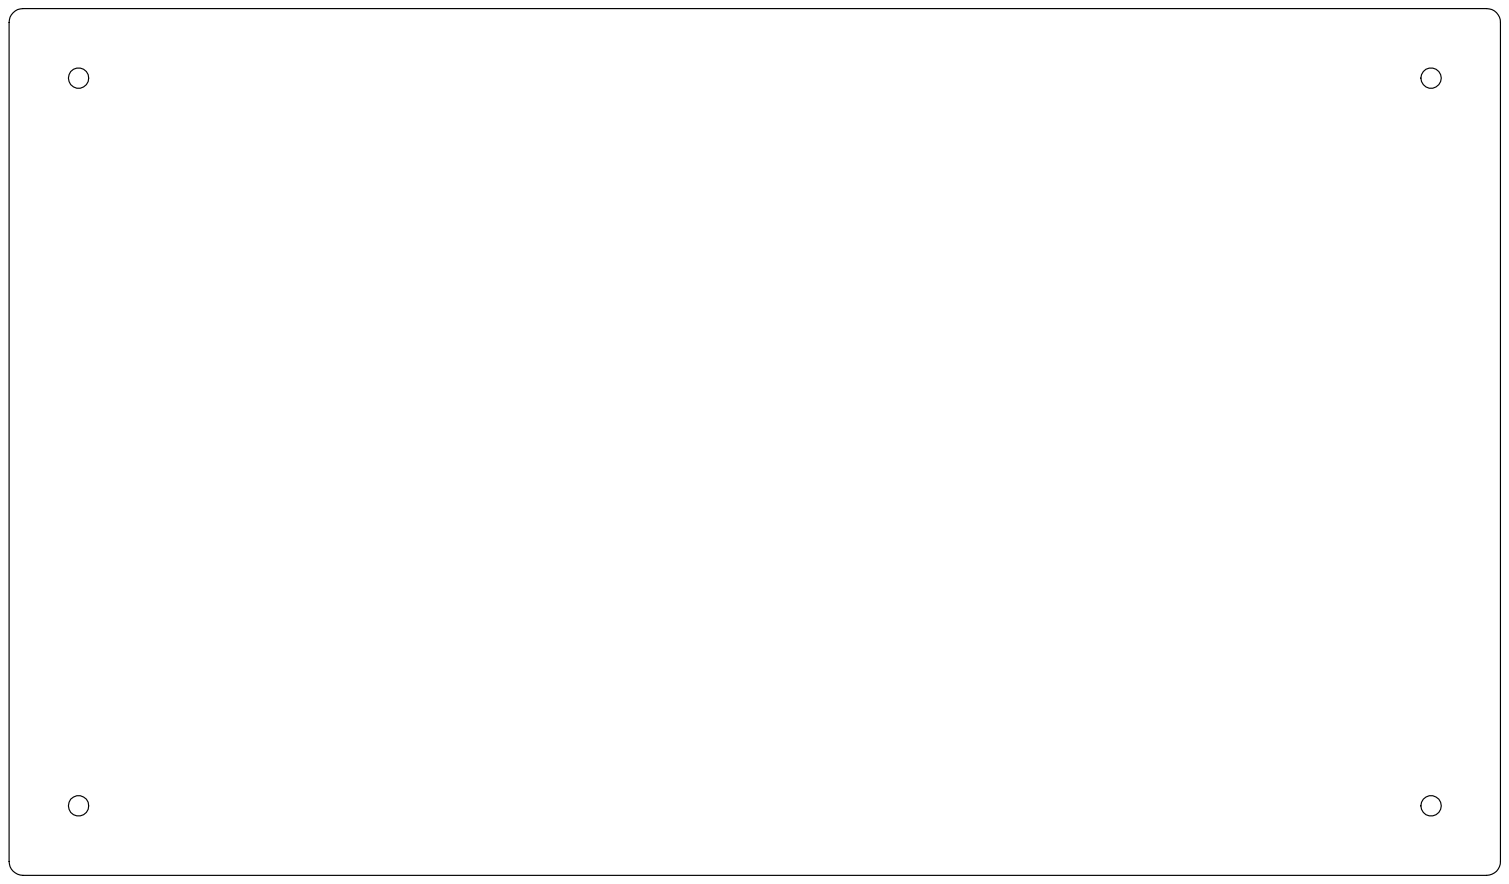
[picture p203: page 1]
