Vitrotem/vitronotion/MVP_02/SHOPPING_LISTS/QUICKCOOL/20-019388--HEATPIPE--Rev_B.pdf

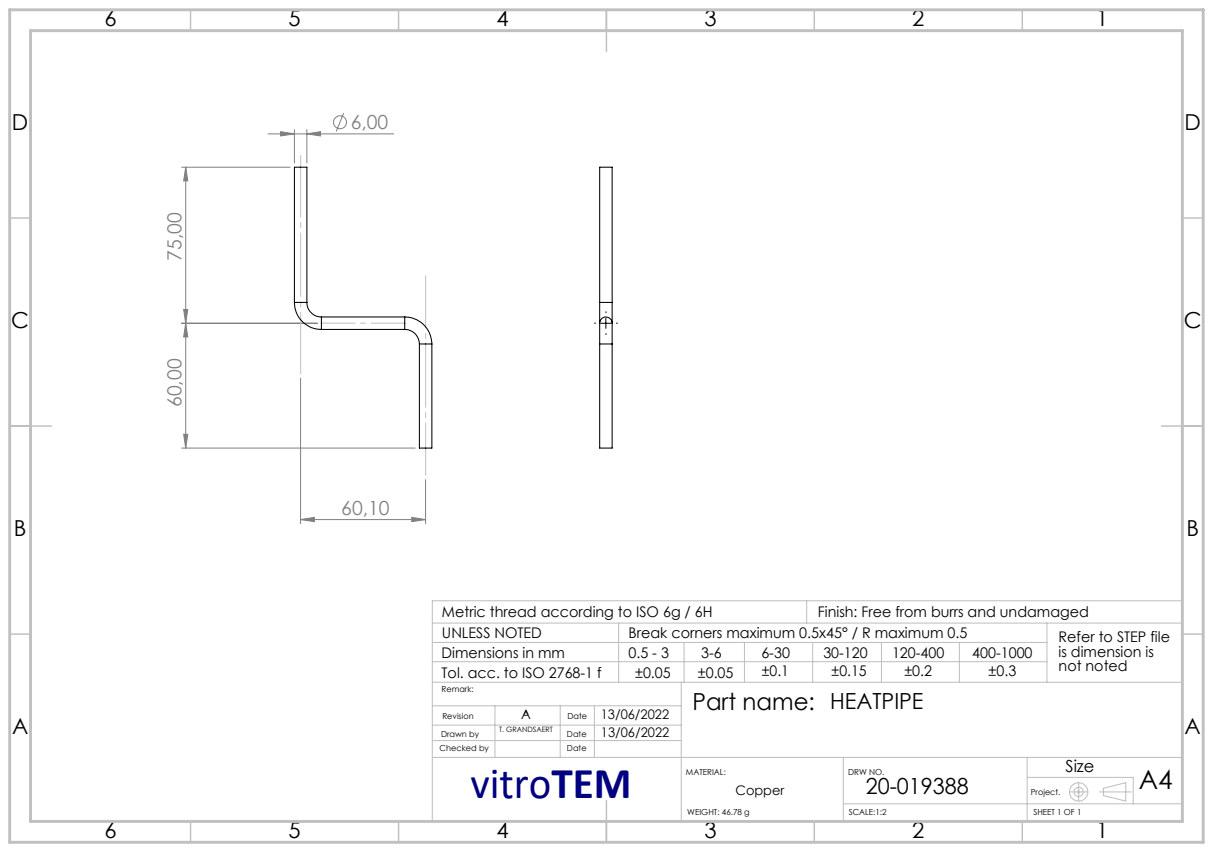
[picture p180: page 1]
MATERIAL:; DRW NO.; SCALE:1:2; SHEET 1 OF 1; WEIGHT: 46.78 g; UNLESS NOTED; Break corners maximum 0.5x45° / R maximum 0.5; Metric thread according to ISO 6g / 6H; Finish: Free from burrs and undamaged; HEATPIPE Revision; Date 13/06/2022; Checked by; Date; Part name:

Dimensions in mm
Tol. acc. to ISO 2768-1 f
Remark:
vitroTEM

Refer to STEP file
is dimension is
not noted

Date T. GRANDSAERT Drawn by
