Vitrotem/vitronotion/MVP_02/SHOPPING_LISTS/SUPE/20-019362--BASE PLATE--Rev_A.pdf

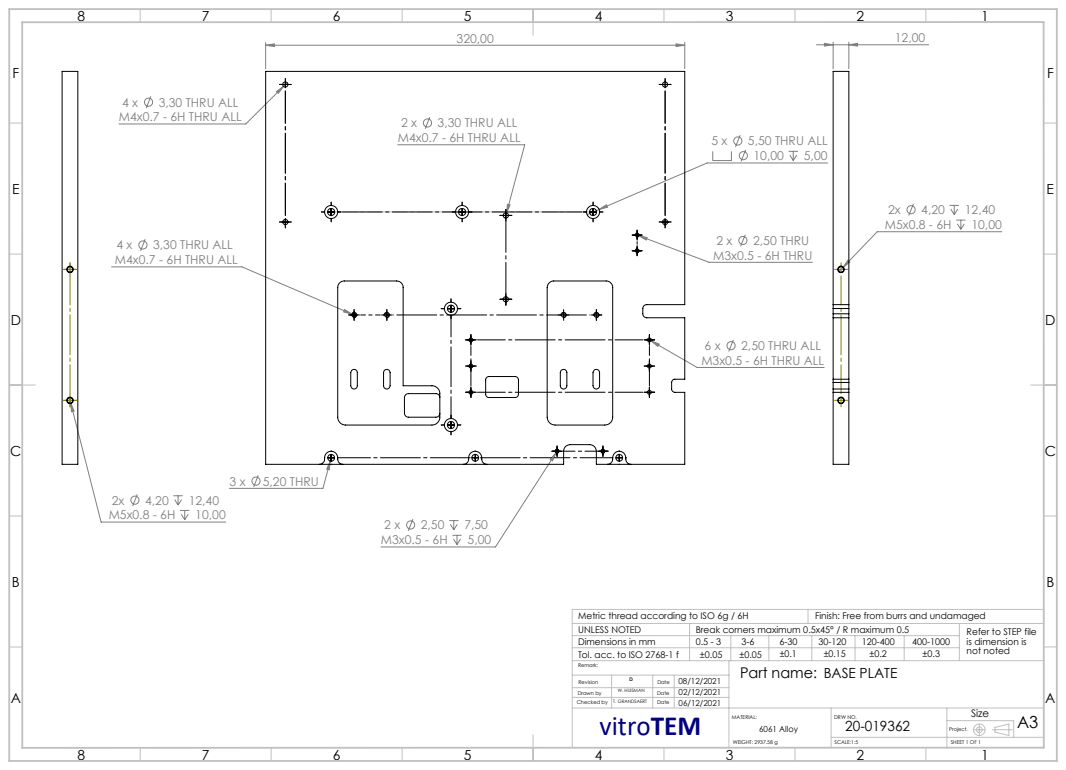
[picture p181: page 1]
3,30 THRU ALL; M4x0.7 - 6H THRU ALL; 5,50 THRU ALL; 2,50 THRU ALL; M3x0.5 - 6H THRU ALL; 3 x 5,20 THRU; 2,50 THRU; M3x0.5 - 6H THRU; MATERIAL:; DRW NO.; SCALE:1:5; SHEET 1 OF 1; 6061 Alloy; WEIGHT: 2937.58 g; T. GRANDSAERT; UNLESS NOTED; Break corners maximum 0.5x45° / R maximum 0.5; Part name:; Metric thread according to ISO 6g / 6H; Finish: Free from burrs and undamaged; BASE PLATE Revision; Date; Checked by

Dimensions in mm
Tol. acc. to ISO 2768-1 f
Remark:
vitroTEM

Refer to STEP file
is dimension is
not noted

Date W. HUISMAN Drawn by
