Vitrotem/vitronotion/MVP_02/SHOPPING_LISTS/SUPE/20-019373--BOTTOM PLATE--Rev_A.pdf

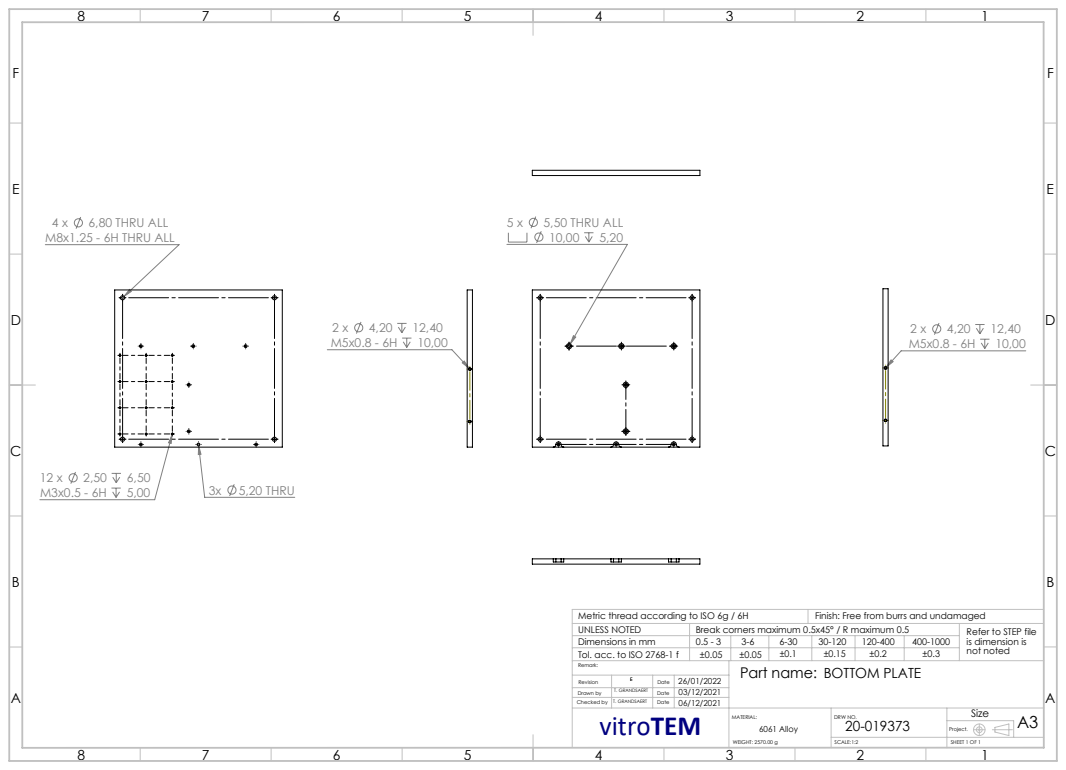
[picture p184: page 1]
6,80 THRU ALL; M8x1.25 - 6H THRU ALL; 3x 5,20 THRU; 5,50 THRU ALL; MATERIAL:; DRW NO.; SCALE:1:2; SHEET 1 OF 1; 6061 Alloy; WEIGHT: 2570.00 g; T. GRANDSAERT; UNLESS NOTED; Break corners maximum 0.5x45° / R maximum 0.5; Part name:; Metric thread according to ISO 6g / 6H; Finish: Free from burrs and undamaged; BOTTOM PLATE Revision; Date 26/01/2022; Checked by; Date

Dimensions in mm
Tol. acc. to ISO 2768-1 f
Remark:
vitroTEM

Refer to STEP file
is dimension is
not noted

Date T. GRANDSAERT Drawn by
