Vitrotem/vitronotion/MVP_02/SHOPPING_LISTS/SUPE/20-019374--FLOWCELL SLIDER--Rev_A.pdf

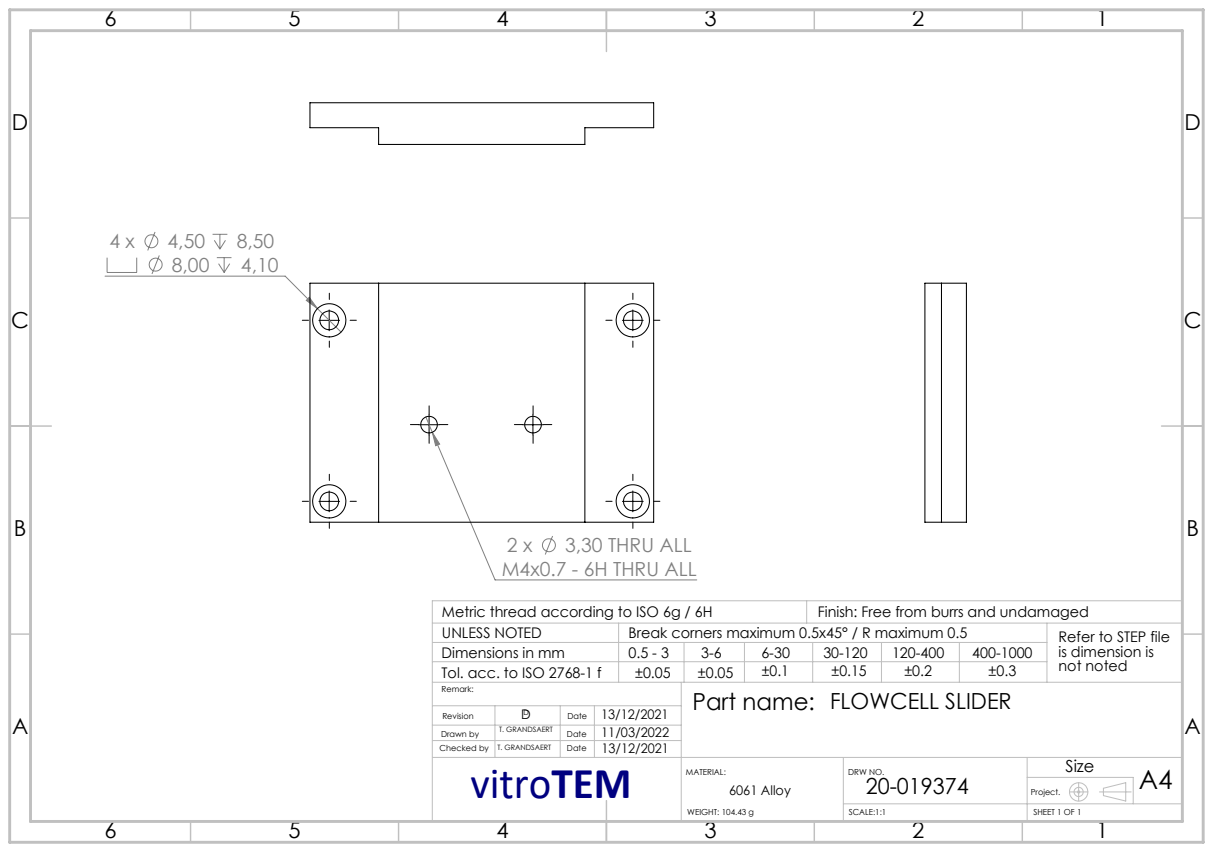
[picture p185: page 1]
3,30 THRU ALL; M4x0.7 - 6H THRU ALL; MATERIAL:; DRW NO.; SCALE:1:1; SHEET 1 OF 1; 6061 Alloy; WEIGHT: 104.43 g; T. GRANDSAERT; UNLESS NOTED; Break corners maximum 0.5x45° / R maximum 0.5; Metric thread according to ISO 6g / 6H; Finish: Free from burrs and undamaged; FLOWCELL SLIDER Revision; Date; Checked by; Part name:

Dimensions in mm
Tol. acc. to ISO 2768-1 f
Remark:
vitroTEM

Refer to STEP file
is dimension is
not noted

Date T. GRANDSAERT Drawn by
