Vitrotem/vitronotion/MVP_02/SHOPPING_LISTS/SUPE/20-019378--SET BLOCK--Rev_A.pdf

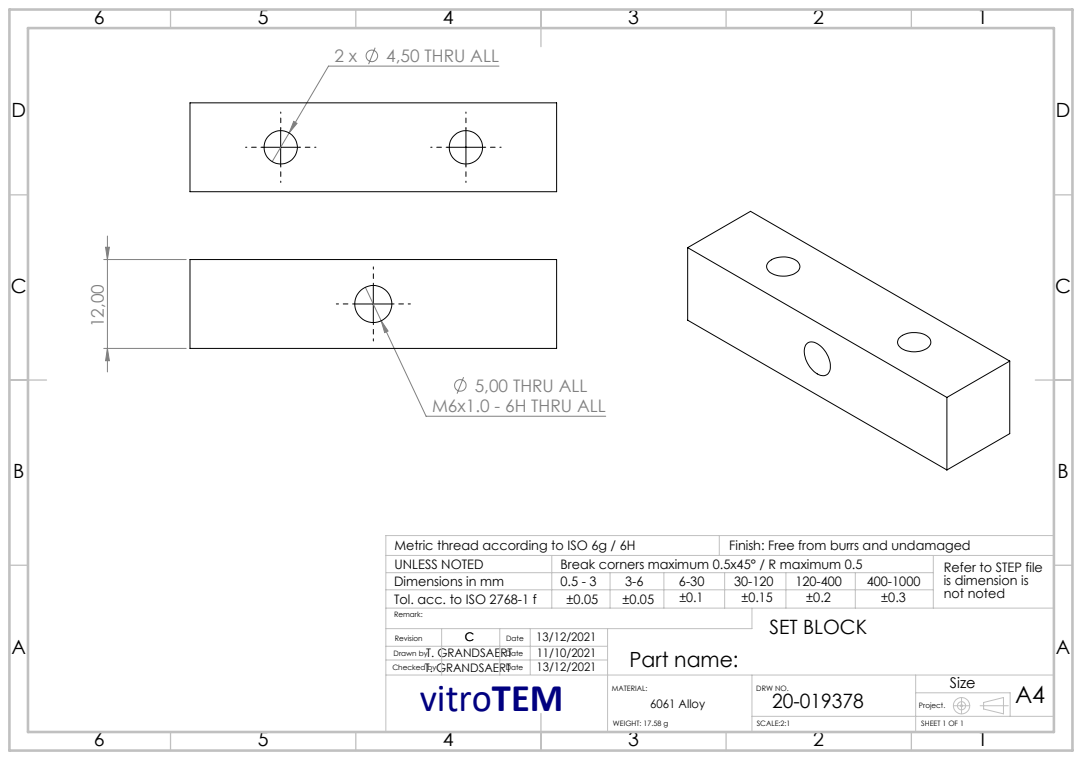
[picture p186: page 1]
5,00 THRU ALL M6x1.0 - 6H THRU ALL; 4,50 THRU ALL; MATERIAL:; DRW NO.; SCALE:2:1; SHEET 1 OF 1; 6061 Alloy; WEIGHT: 17.58 g; UNLESS NOTED; Break corners maximum 0.5x45° / R maximum 0.5; Part name:; Metric thread according to ISO 6g / 6H; Finish: Free from burrs and undamaged; SET BLOCK Revision; Date; Checked by

Dimensions in mm
Tol. acc. to ISO 2768-1 f
Remark:
vitroTEM

Refer to STEP file
is dimension is
not noted

Drawn byT. GRANDSAERTDate
T. GRANDSAERT
