Vitrotem/vitronotion/MVP_02/SHOPPING_LISTS/SUPE/20-019400--ACTUATOR BRACKET--Rev_A.pdf

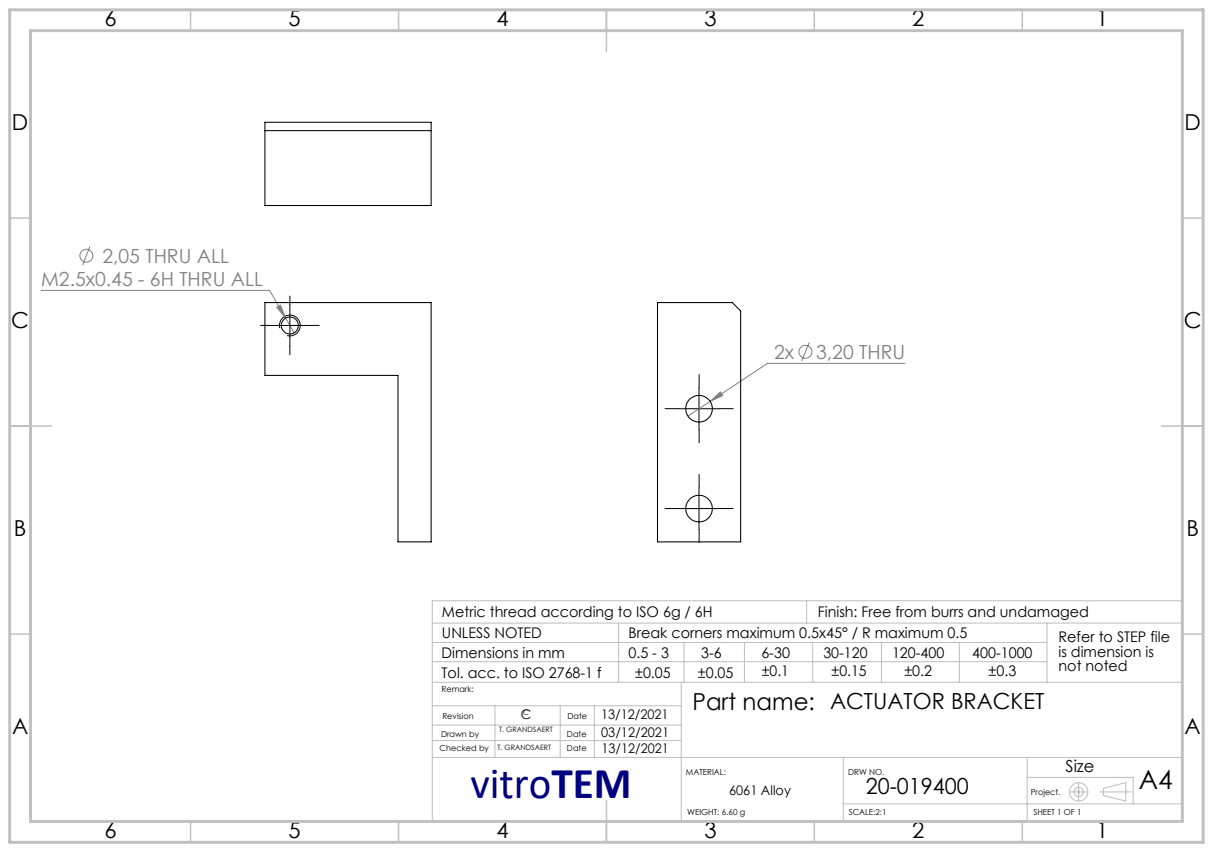
[picture p189: page 1]
2,05 THRU ALL M2.5x0.45 - 6H THRU ALL; 2x 3,20 THRU; MATERIAL:; DRW NO.; SCALE:2:1; SHEET 1 OF 1; 6061 Alloy; WEIGHT: 6.60 g; T. GRANDSAERT; UNLESS NOTED; Break corners maximum 0.5x45° / R maximum 0.5; Metric thread according to ISO 6g / 6H; Finish: Free from burrs and undamaged; ACTUATOR BRACKET Revision; Date; Checked by; Part name:

Dimensions in mm
Tol. acc. to ISO 2768-1 f
Remark:
vitroTEM

Refer to STEP file
is dimension is
not noted

Date T. GRANDSAERT Drawn by
