Vitrotem/vitronotion/MVP_02/SHOPPING_LISTS/SUPE/20-019402--BOTTOM TRAY B--Rev_A.pdf

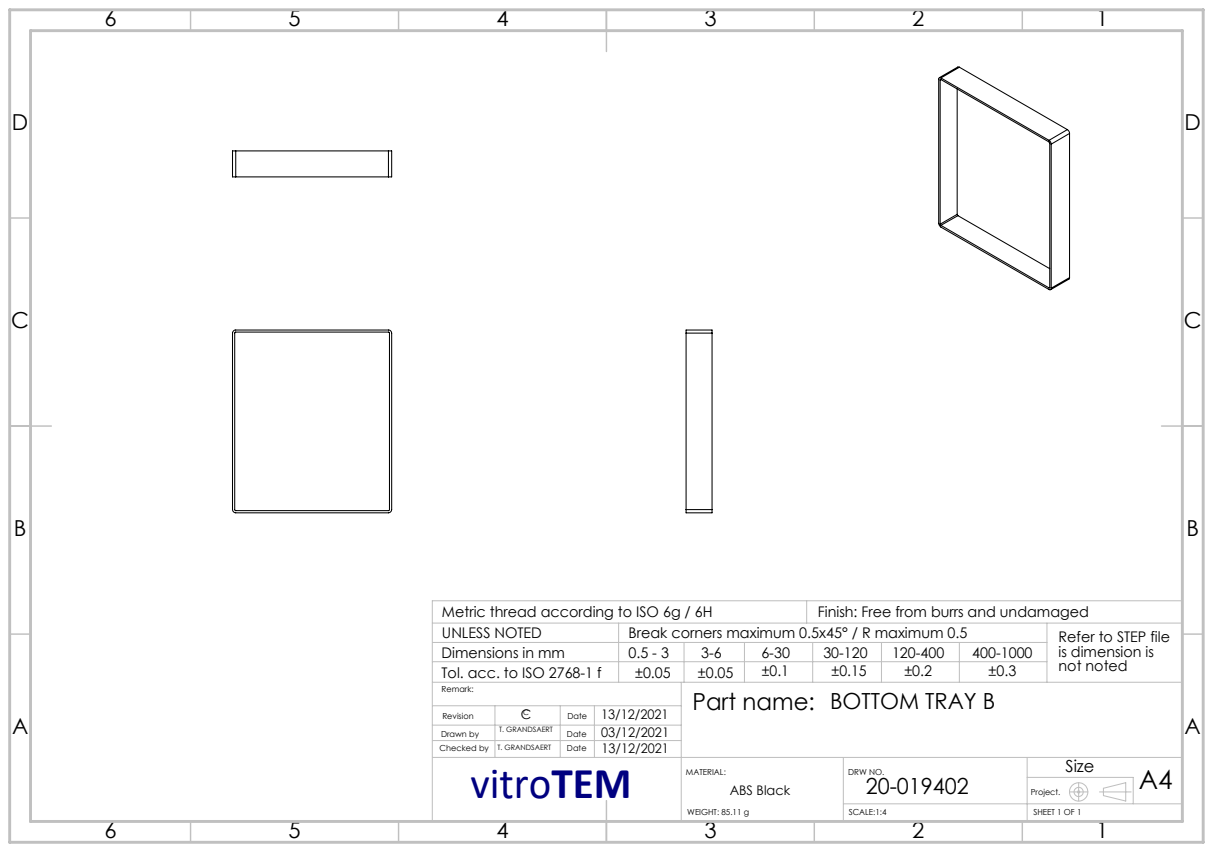
[picture p190: page 1]
MATERIAL:; DRW NO.; SCALE:1:4; SHEET 1 OF 1; ABS Black; WEIGHT: 85.11 g; T. GRANDSAERT; UNLESS NOTED; Break corners maximum 0.5x45° / R maximum 0.5; Metric thread according to ISO 6g / 6H; Finish: Free from burrs and undamaged; BOTTOM TRAY B Revision; Date; Checked by; Part name:

Dimensions in mm
Tol. acc. to ISO 2768-1 f
Remark:
vitroTEM

Refer to STEP file
is dimension is
not noted

Date T. GRANDSAERT Drawn by
