Vitrotem/vitronotion/MVP_02/SHOPPING_LISTS/SUPE/20-019403--BOTTOM TRAY A--Rev_A.pdf

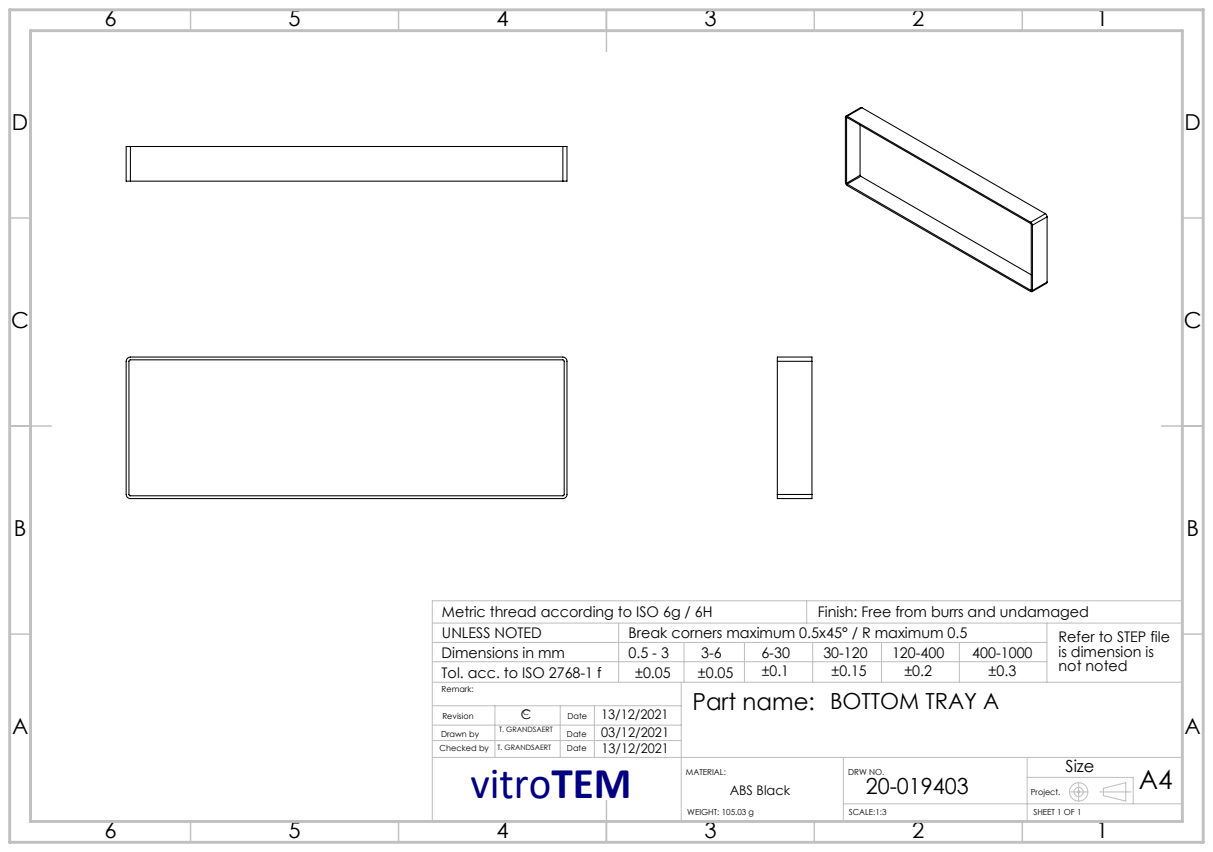
[picture p191: page 1]
MATERIAL:; DRW NO.; SCALE:1:3; SHEET 1 OF 1; ABS Black; WEIGHT: 105.03 g; T. GRANDSAERT; UNLESS NOTED; Break corners maximum 0.5x45° / R maximum 0.5; Metric thread according to ISO 6g / 6H; Finish: Free from burrs and undamaged; BOTTOM TRAY A Revision; Date; Checked by; Part name:

Dimensions in mm
Tol. acc. to ISO 2768-1 f
Remark:
vitroTEM

Refer to STEP file
is dimension is
not noted

Date T. GRANDSAERT Drawn by
