Vitrotem/vitronotion/MVP_02/SHOPPING_LISTS/SUPE/20-019410--HOUSING CONNECTION A--Rev_A.pdf

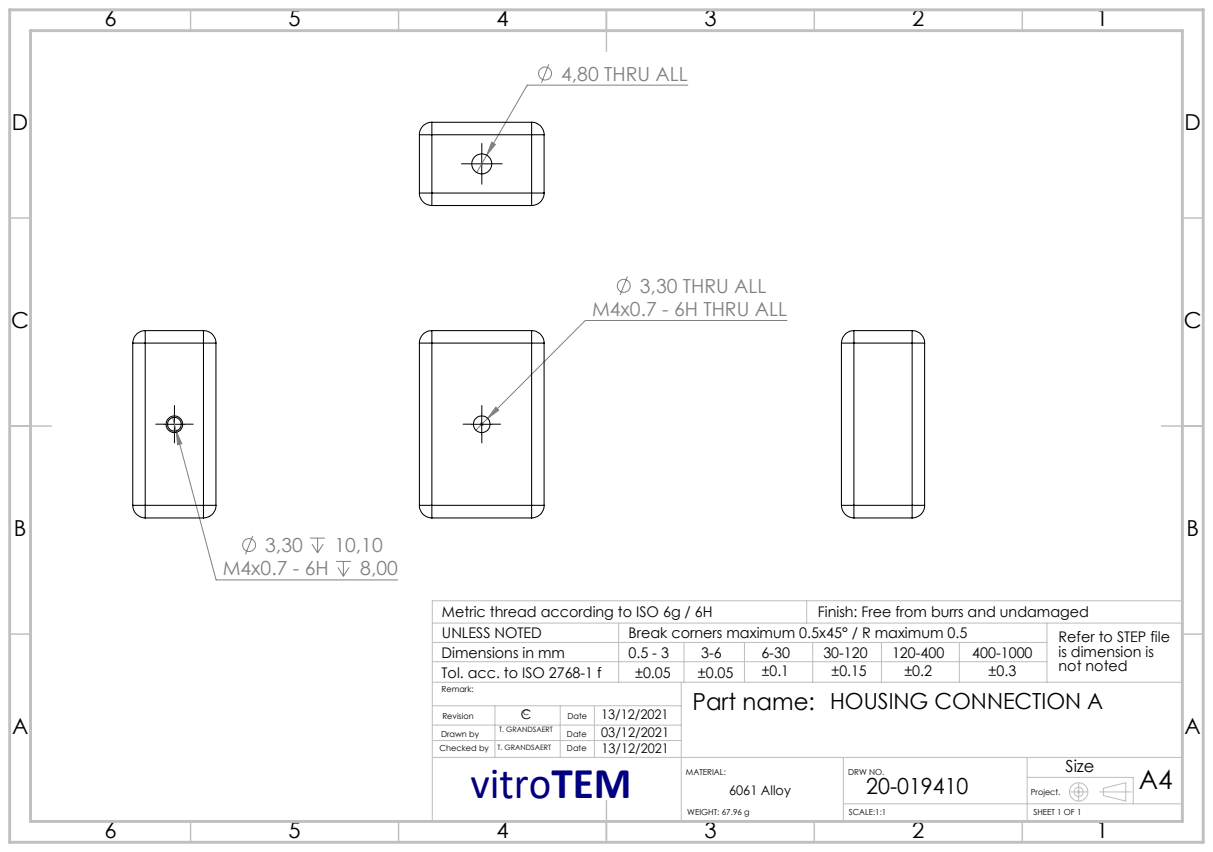
[picture p192: page 1]
3,30 THRU ALL M4x0.7 - 6H THRU ALL; 4,80 THRU ALL; MATERIAL:; DRW NO.; SCALE:1:1; SHEET 1 OF 1; 6061 Alloy; WEIGHT: 67.96 g; T. GRANDSAERT; UNLESS NOTED; Break corners maximum 0.5x45° / R maximum 0.5; Metric thread according to ISO 6g / 6H; Finish: Free from burrs and undamaged; HOUSING CONNECTION A Revision; Date; Checked by; Part name:

Dimensions in mm
Tol. acc. to ISO 2768-1 f
Remark:
vitroTEM

Refer to STEP file
is dimension is
not noted

Date T. GRANDSAERT Drawn by
