Vitrotem/vitronotion/MVP_02/SHOPPING_LISTS/SUPE/20-019526--LOOP HOLDER INTERFACE--Rev_B.pdf

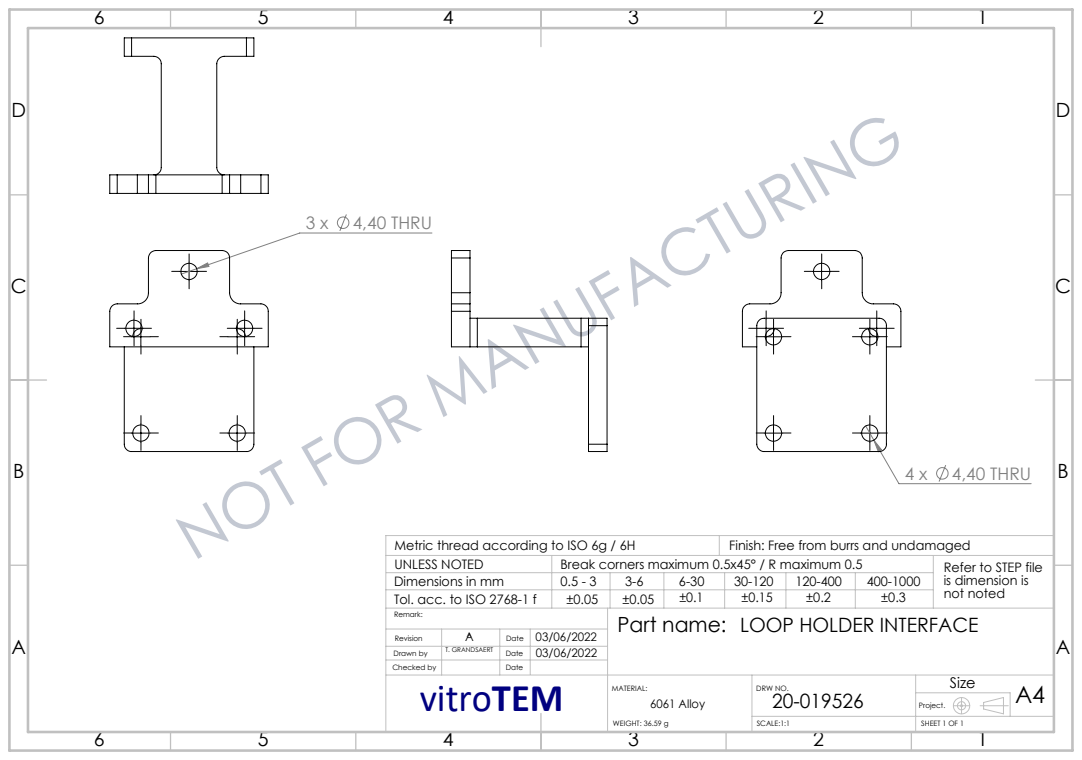
[picture p194: page 1]
3 x 4,40 THRU; 4 x 4,40 THRU; MATERIAL:; DRW NO.; SCALE:1:1; SHEET 1 OF 1; 6061 Alloy; WEIGHT: 36.59 g; UNLESS NOTED; Break corners maximum 0.5x45° / R maximum 0.5; Metric thread according to ISO 6g / 6H; Finish: Free from burrs and undamaged; LOOP HOLDER INTERFACE Revision; Date 03/06/2022; Checked by; Date; Part name:

NOT FOR MANUFACTURING

Dimensions in mm
Tol. acc. to ISO 2768-1 f
Remark:
vitroTEM

Refer to STEP file
is dimension is
not noted

Date T. GRANDSAERT Drawn by
