Vitrotem/vitronotion/MVP_02/SHOPPING_LISTS/LASERBEEST/20-019462.pdf

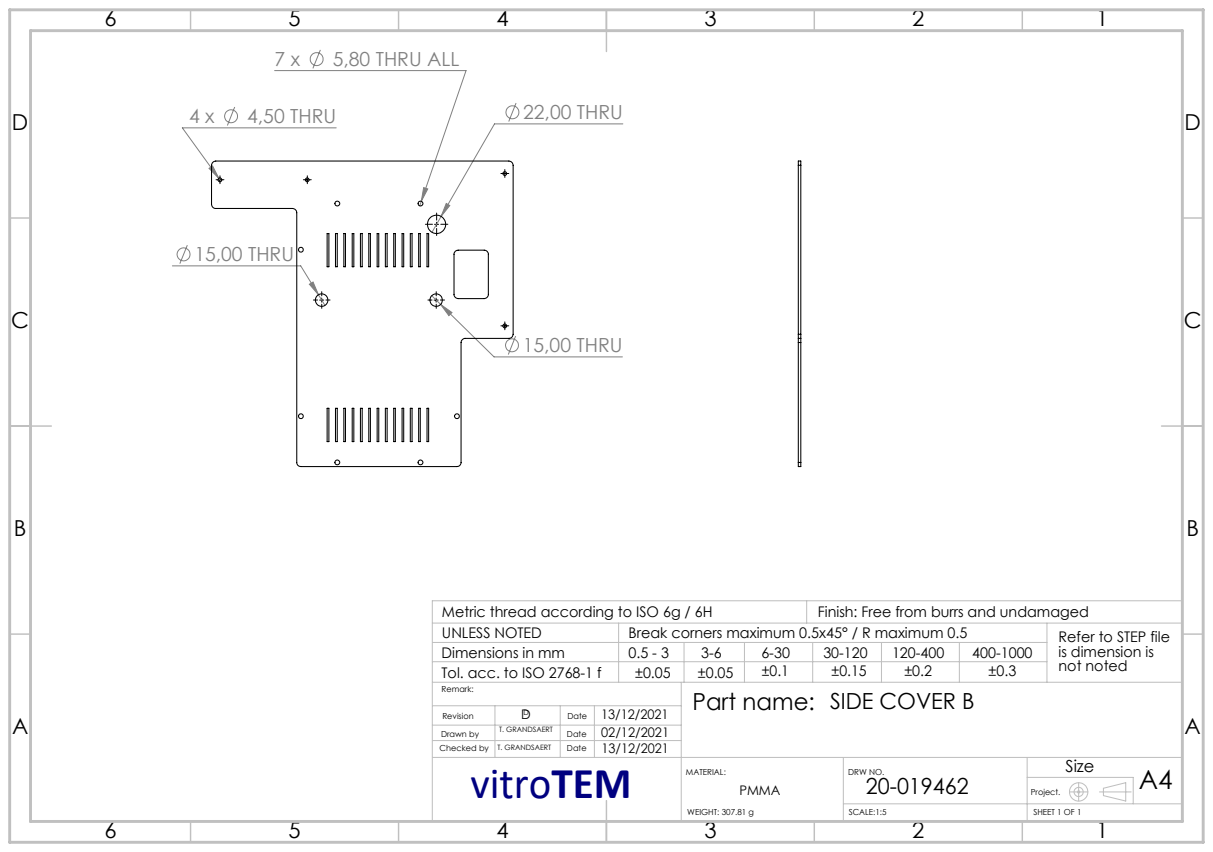
[picture p195: page 1]
4,50 THRU; 15,00 THRU; 22,00 THRU; 5,80 THRU ALL; MATERIAL:; DRW NO.; SCALE:1:5; SHEET 1 OF 1; WEIGHT: 307.81 g; T. GRANDSAERT; UNLESS NOTED; Break corners maximum 0.5x45° / R maximum 0.5; Metric thread according to ISO 6g / 6H; Finish: Free from burrs and undamaged; SIDE COVER B Revision; Date; Checked by; Part name:

Dimensions in mm
Tol. acc. to ISO 2768-1 f
Remark:
vitroTEM

Refer to STEP file
is dimension is
not noted

Date T. GRANDSAERT Drawn by
