Vitrotem/vitronotion/MVP_02/SHOPPING_LISTS/SUPE/20-019421.pdf

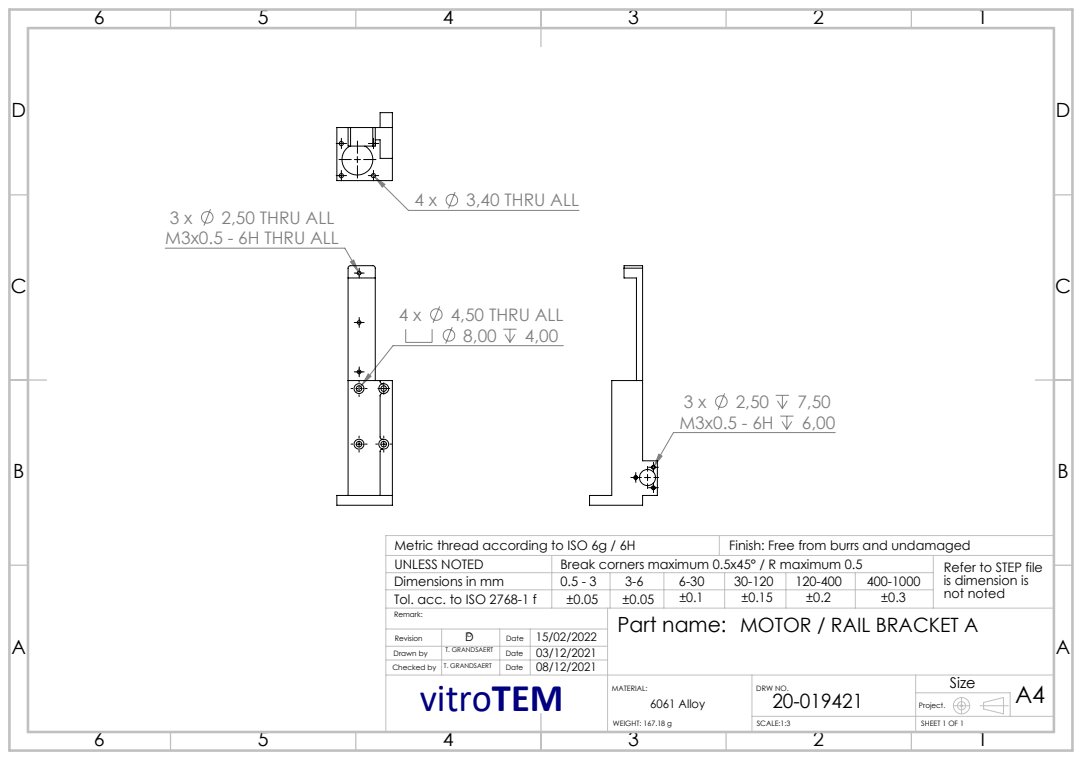
[picture p196: page 1]
4,50 THRU ALL; 2,50 THRU ALL; M3x0.5 - 6H THRU ALL; 3,40 THRU ALL; MATERIAL:; DRW NO.; SCALE:1:3; SHEET 1 OF 1; 6061 Alloy; WEIGHT: 167.18 g; T. GRANDSAERT; UNLESS NOTED; Break corners maximum 0.5x45° / R maximum 0.5; Metric thread according to ISO 6g / 6H; Finish: Free from burrs and undamaged; MOTOR / RAIL BRACKET A Revision; Date 15/02/2022; Checked by; Date; Part name:

Dimensions in mm
Tol. acc. to ISO 2768-1 f
Remark:
vitroTEM

Refer to STEP file
is dimension is
not noted

Date T. GRANDSAERT Drawn by
