Vitrotem/vitronotion/MVP_02/SHOPPING_LISTS/SUPE/20-019482.pdf

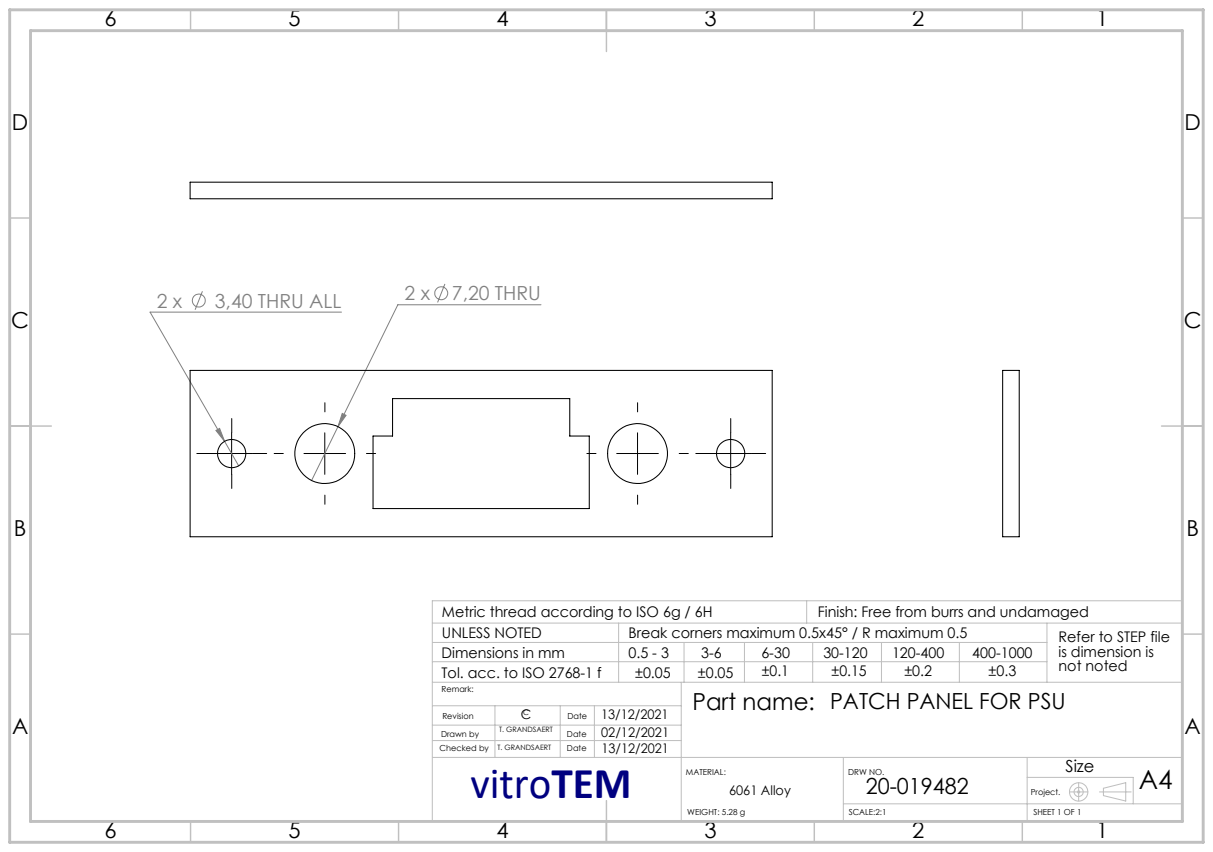
[picture p197: page 1]
3,40 THRU ALL; 2 x 7,20 THRU; MATERIAL:; DRW NO.; SCALE:2:1; SHEET 1 OF 1; 6061 Alloy; WEIGHT: 5.28 g; T. GRANDSAERT; UNLESS NOTED; Break corners maximum 0.5x45° / R maximum 0.5; Metric thread according to ISO 6g / 6H; Finish: Free from burrs and undamaged; PATCH PANEL FOR PSU Revision; Date; Checked by; Part name:

Dimensions in mm
Tol. acc. to ISO 2768-1 f
Remark:
vitroTEM

Refer to STEP file
is dimension is
not noted

Date T. GRANDSAERT Drawn by
