Vitrotem/vitronotion/(notices)

Notices in the files:
MVP/BOM/index.html:
75 | 13-018353 | MVP:PRT: FLOW VALVE | SMC NEDERLAND | LVM10R3-5E2U-3-Q | | | 5 | | 5 | Ordered | | 0 | | | https://www.smc.eu/nl-nl/products/lvm10-100-2-3-poort-magneetventiel-voor-chemicalien~134871~cfg?partNumber=LVM10R3-5E2U-3-Q | RenÃƒÂ© Bachofner: verkoop@smc.nl
